Laurenceb/Dactyl/Hardware/Assembly/photo1.JPG

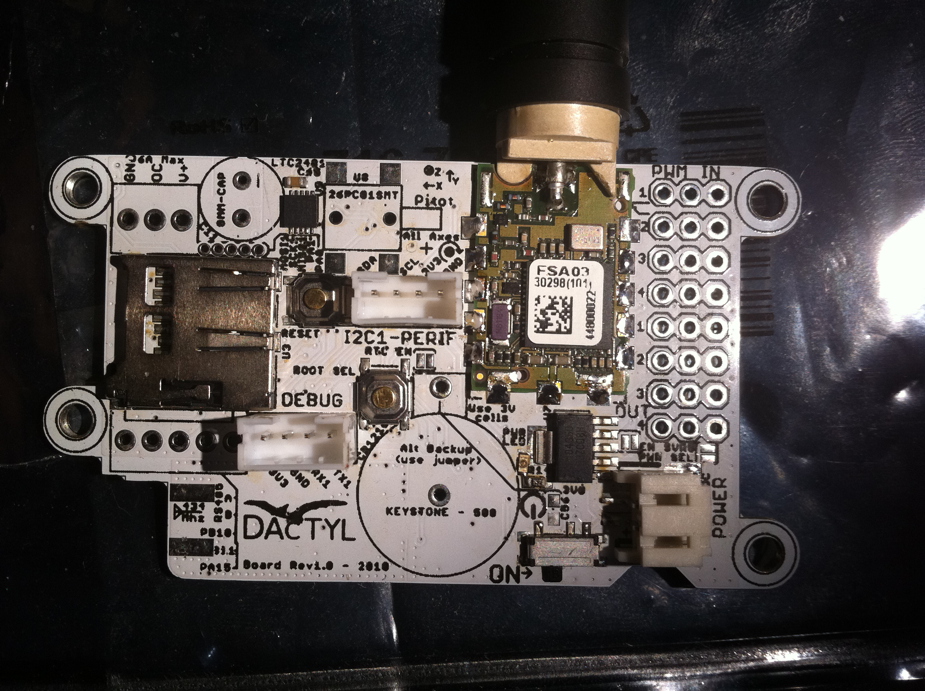
Hardware/Assembly/photo1.JPG
