Laurenceb/Dactyl/Hardware/Assembly/photo2.JPG

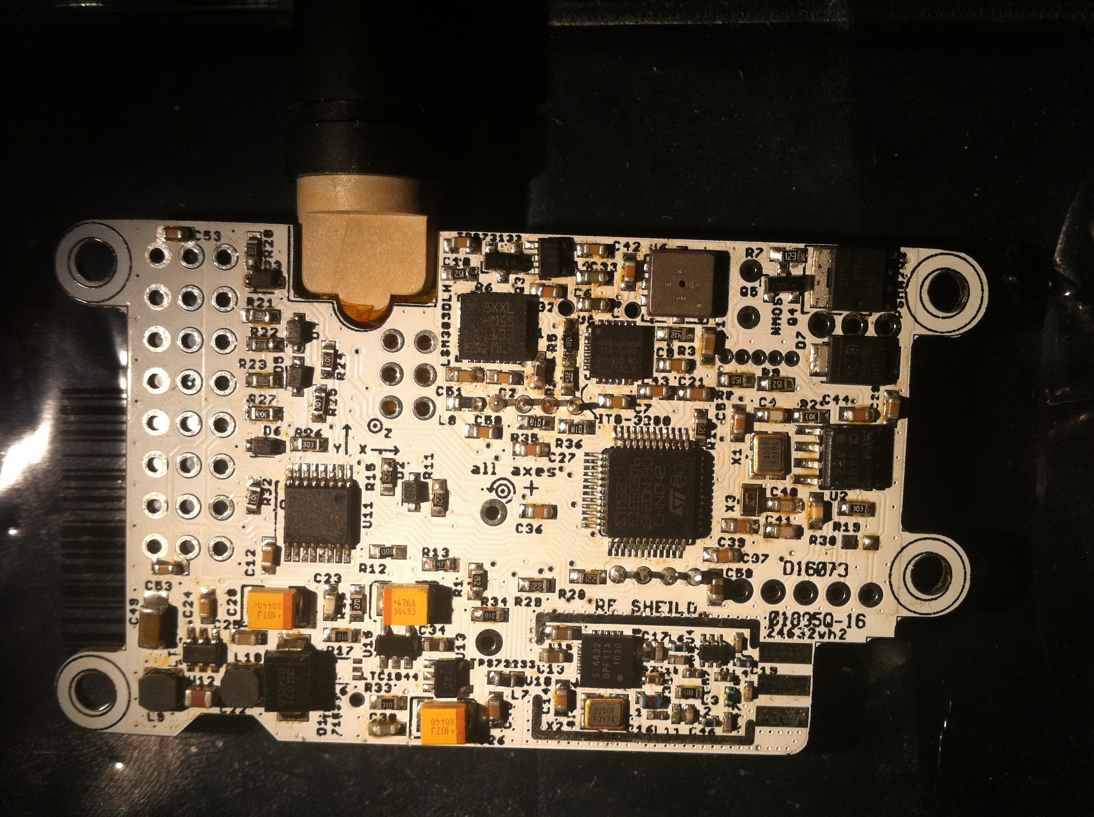
Hardware/Assembly/photo2.JPG
