Laurenceb/Dactyl/README

 The 'Dactyl' autopilot project.

V1.0 of the pcb - has been assembled and mostly tested.

Firmware is presently under development, using ekf code
from openpilot, ubx protocol driver from ukhas mini rogallo
 and Fatfs from http://elm-chan.org
Compiled with codesourcery.

Many thanks to :

- Everyone at OpenPilot
- ChaN for FatFS
- Martin Thomas for SPI and DMA code
- Peter Dannegger for RTC code
- Pascal Stang for rprintf code

Licensed under the GPL

This program is free software; you can redistribute it and/or modify
it under the terms of the GNU General Public License as published by
the Free Software Foundation; version 3 of the License.

This program is distributed in the hope that it will be useful,
but WITHOUT ANY WARRANTY; without even the implied warranty of
MERCHANTABILITY or FITNESS FOR A PARTICULAR PURPOSE.  See the
GNU General Public License for more details.
