Laurenceb/Dactyl/Hardware/11thSept_all.png

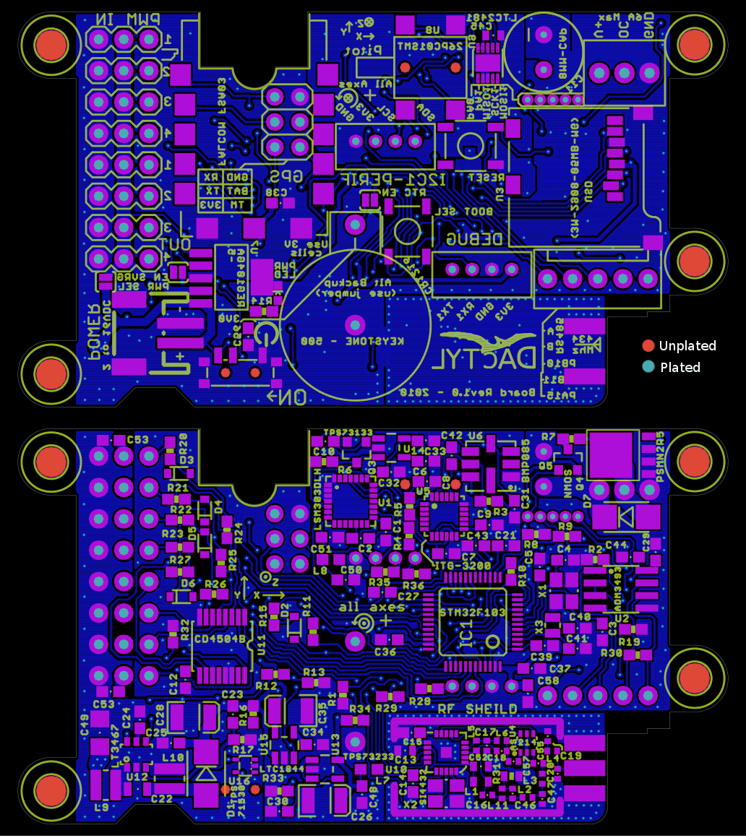
Hardware/11thSept_all.png
