Laurenceb/Dactyl/Hardware/Schematics/Board.png

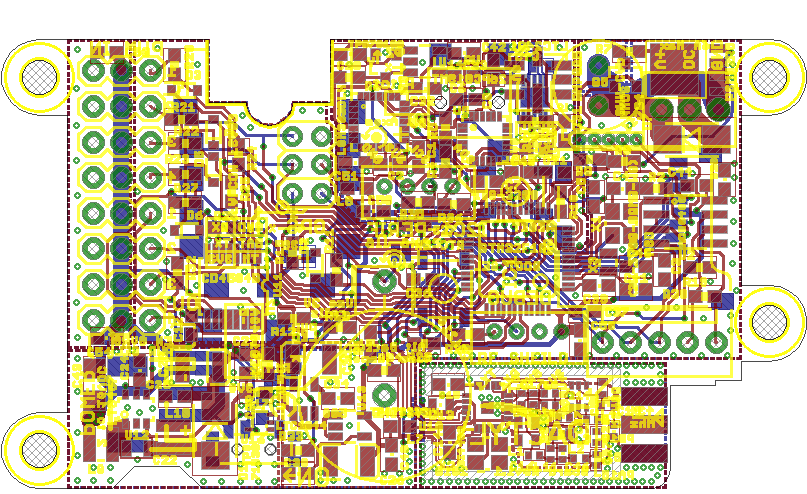
Hardware/Schematics/Board.png
