Laurenceb/Dactyl/Hardware/Schematics/intf.png

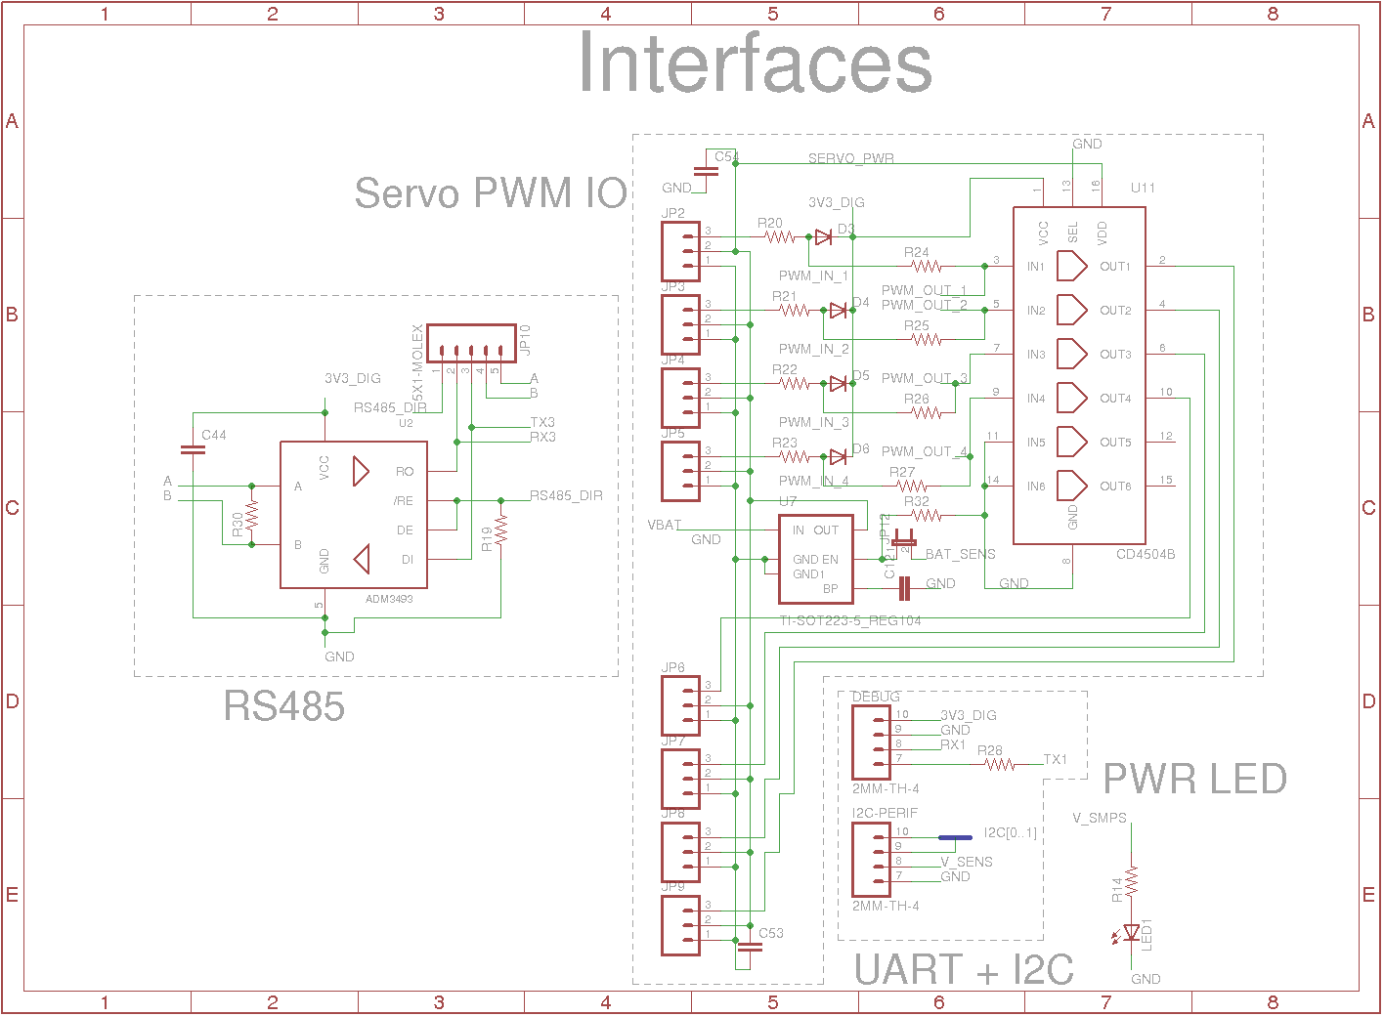
Hardware/Schematics/intf.png
