Laurenceb/Dactyl/Hardware/Schematics/ism.png

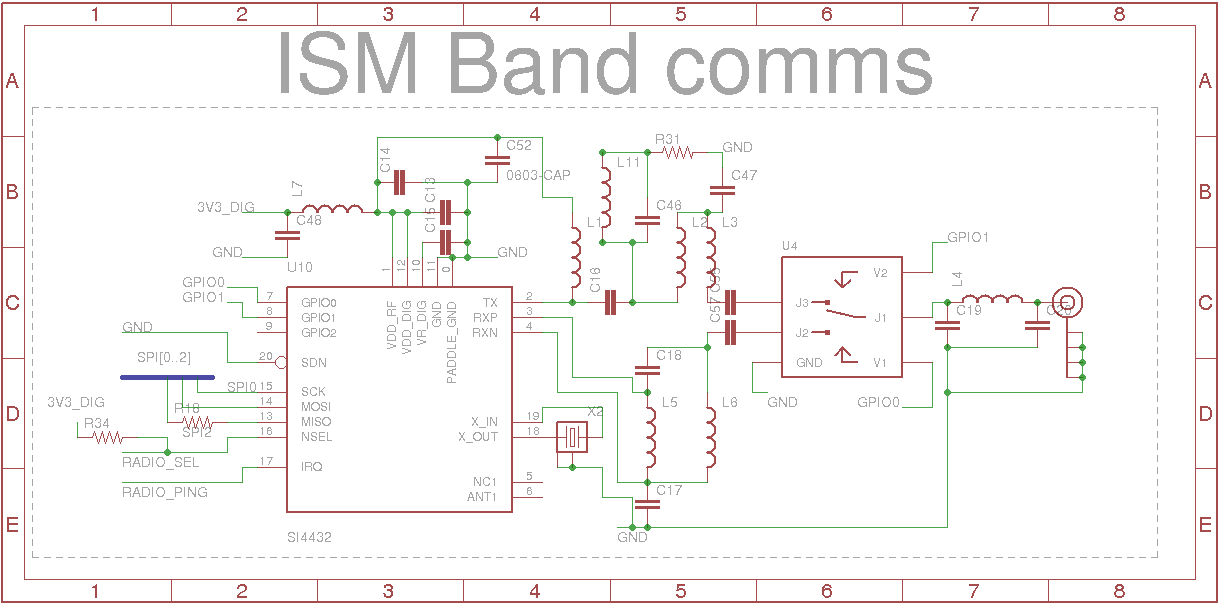
Hardware/Schematics/ism.png
