Laurenceb/Dactyl/Hardware/Schematics/pmg.png

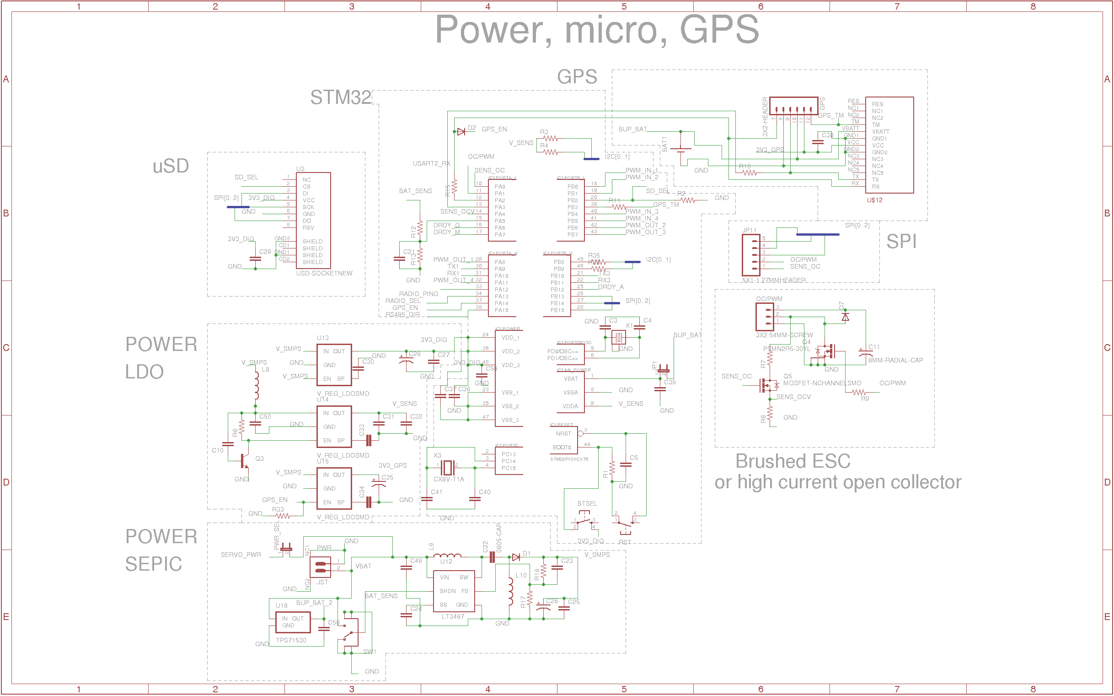
Hardware/Schematics/pmg.png
