Laurenceb/Dactyl/Hardware/Schematics/sens.png

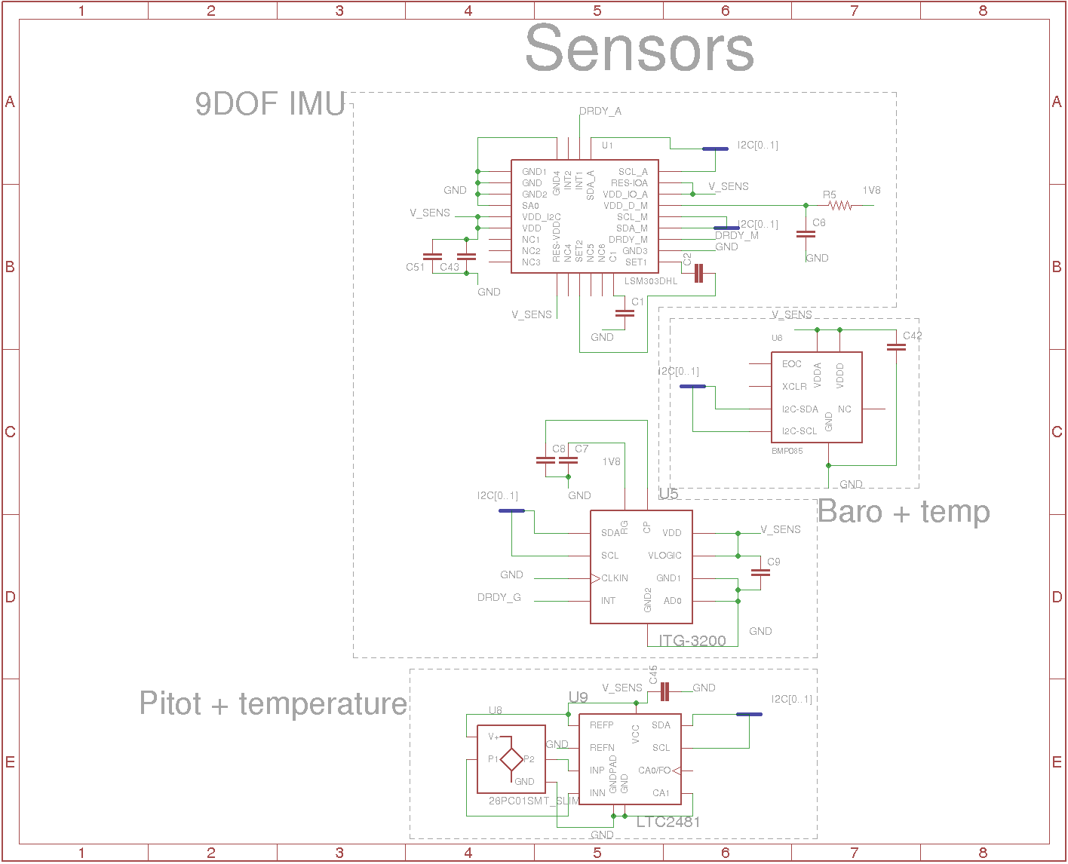
Hardware/Schematics/sens.png
