Laurenceb/Dactyl/Util/RF22/doc/classRF22.png

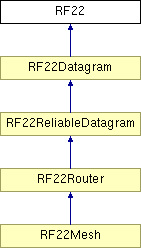
Util/RF22/doc/classRF22.png
