Laurenceb/Dactyl/Hardware/MFG/BOM.xls

 |  |  |  |  | Farnell | GBP | Mouser | GBP | Digikey | $ | Other |  |  | Best price
Part on Board | Quantity | Name | Value | Manufacturer | Code | Price | Code | Price | Code | Price | Name | Price GBP | Price $ | Price | Supplier
U1 | 1 | LSM303DLH | - | ST | - | - | 511-LSM303DLH | 7.34 | 497-10474-ND (http://search.digikey.com/scripts/DkSearch/dksus.dll?Detail&name=497-10474-ND) | 10.5 | Kamami | 12.19 | - | 6.615
U2 | 1 | ADM3493 | - | AD | 1274164 | 2.3 | - | - | ADM3493ARZ-ND (http://search.digikey.com/scripts/DkSearch/dksus.dll?Detail&name=ADM3493ARZ-ND) | 2.27 | - | - | - | 1.4301
U3 | 1 | 2908-05WB-MG | - | 3M | 1654360 | 1.2 | 517-2908-05WB-MG | 0.932 | - | - | - | - | - | 0.932
U4 | 1 | AS214-92LF | - | Skyworks | 1753767 | 0.41 | - | - | - | - | - | - | - | 0.41
U5 | 1 | ITG-3200 | - | Invensence | - | - | - | - | - | - | Invensence | - | 10 | 6.3
U6 | 1 | BMP085 | - | Bosch | - | - | - | - | 828-1005-1-ND (http://search.digikey.com/scripts/DkSearch/dksus.dll?Detail&name=828-1005-1-ND) | 8.79 | - | - | - | 5.5377
U7 | 1 | REG104GA-5 | - | Ti | 1207261 | 4.44 | 595-REG104GA-5/2K5 (http://gb.mouser.com/ProductDetail/Texas-Instruments/REG104GA-5-2K5/) | 3.53 | REG104GA-5-ND | 6.65 | - | - | - | 3.53
U8 | 1 | 26PC01SMT | - | Honeywell | 1225333 | 34.84 | 785-26PC01SMT | 18.67 | 480-2506-5-ND | 28.44 | Conrad | 23.37 | - | 17.9172
U9 | 1 | LTC2481 | - | Linear | 1330939 | 3.96 | - | - | LTC2481CDD#PBF-ND | 3.7 | - | - | - | 2.331
U10 | 1 | SI4432 | - | Silabs | - | - | Si4432-B1-FM | 3.57 | - | - | - | - | - | 3.57
U11 | 1 | CB4504B | - | Ti | - | - | 595-CD4504BPWRG4 | 0.41 | - | - | - | - | - | 0.41
U12 | 1 | LT3467 | - | Linear | 1663827 | 3.72 | - | - | LT3467ES6#TRMPBFCT-ND | 4.14 | - | - | - | 2.6082
U13 | 1 | TPS73233 | - | Ti | - | - | 595-TPS73233DBVT | 1.25 | 296-15812-1-ND | 2.49 | - | - | - | 1.25
U14 | 1 | TPS73133 | - | Ti | 1207341 | 1 | 595-TPS73133DBVR | 0.906 | 296-15805-2-ND | 1.04 | - | - | - | 0.6552
U15 | 1 | LTC1844 | - | Linear | 1663867 | 2.69 | - | - | LTC1844ES5-3.3#TRMPBFCT-ND | 2.88 | - | - | - | 1.8144
U16 | 1 | TPS71530 | - | Ti | 1135382 | 0.41 | 595-TPS71530DCKRG4 | 0.72 | 296-15045-1-ND | 1.29 | - | - | - | 0.41
GPS | 1 | FSA03 | - | Falcom | - | - | - | - | - | - | Esawdust | - | 47.99 | 30.2337
IC1 | 1 | STM32F103CBT | - | ST | 1606327 | 5.54 | 511-STM32F103CBT6 | 6.4 | 497-6288-ND | 9.6 | - | - | - | 5.54
SMA | 1 | SMA card edge | - | - | - | - | 712-CONREVSMA003.031 | 2.17 | CONSMA003.062-ND | 3.29 | - | - | - | 2.0727
Q4 | 1 | PSMN2R5-30YL | - | NXP | 1699704 | 1.43 | 771-PSMN2R5-30YL-T/R | 1.07 | 568-4680-1-ND | 2.14 | - | - | - | 1.07
ESC-Term | 1 | 1725672 | - | Phoenix | 3041414 | 0.86 | 651-1725672 | 1.59 | 277-1275-ND | 2.23 |  | - | - | 0.86
C11 | 1 | UHN1C471MPD | 470uF | Nichicon | - | - | 647-UHN1C471MPD | 0.212 | - | - | - | - | - | 0.212
Bat-holder | 1 | Keystone 500 | - | Keystone | 3029839 | 1.62 | 534-500 | 1.37 | 500K-ND | 1.37 | - | - | - | 0.8631
Pwr-con | 1 | S2B-PH-SM4-TB | - | JST | 9492615 | 0.32 | - | - | 455-1749-1-ND | 0.5 | - | - | - | 0.315
JST-cons | 2 | B4B-PH-K-S | - | JST | 9492437 | 0.158 | - | - | 455-1706-ND | 0.18 | - | - | - | 0.2268
RS485-head | 1 | 22-11-2052 | - | Molex | - | - | 538-22-11-2052 | 1.29 | WM2703-ND | 0.97 | - | - | - | 0.6111
Servo headers | 8 | 0.1'' headers | - | - | 3418297 | 0.137 | 517-9611036804AR | 0.099 | WM8085-ND | 0.49 | - | - | - | 0.792
SPI-bkout | 1 | 0.05” 5 way | - | - | 1577762 | 0.23 | - | - | S9016E-05-ND | 0.4 | - | - | - | 0.23
Tact-switches | 2 | PTS 525 – S | - | C&K | - | - | 611-PTS525SM08SMTRLF | 0.395 | CKN9125CT-ND | 0.48 | - | - | - | 0.6048
On/off switch | 1 | PCM12SMTR | - | C&K | 9575146 | 0.82 | 611-PCM12SMTR | 0.778 | 401-2016-1-ND | 0.9 | - | - | - | 0.567
PWR LED | 1 | - | - | - | 8529850 | 0.175 | 604-APTD1608SYCK | 0.141 | 754-1353-1-ND | 0.18 | - | - | - | 0.1134
C45,54,53,44,43,42,9,7,48,14,29,21,38,39,50,27,37,36,32,5,10,12 | 22 | Ceramic 0603 caps | 100nF | - | 1759037 | 0.006 | - | - | - | - | - | - | - | 0.132
R14,6,1,8,9 | 5 | 0603 Resistor | 1K5 | - | 9331808 | 0.008 | - | - | - | - | - | - | - | 0.04
C22 | 1 | 0805 30V ceramic | 4u7 | - | 1735529 | 0.21 | 810-C2012X5R1E475K | 0.176 | 490-3335-1-ND | 0.281 | - | - | - | 0.176
C49 | 1 | 1206 Cap – 25V | 10uF | - | 1611967 | 0.087 | - | - | 587-1352-1-ND | 0.45 | - | - | - | 0.087
X2 | 1 | FA238 | 30MHz | Epson Toyocom | 1712817 | 1.17 | - | - | - | - | - | - | - | 1.17
C26,28 | 2 | Tant, 3528 | 100uF | - | 1650975 | 0.92 | - | - | - | - | - | - | - | 1.84
C35 | 1 | Tant, 3528 | 47uF | - | 1462450 | 1.08 | - | - | - | - | - | - | - | 1.08
L7,8 | 2 | Choke, RF | - | - | 1463450 | 0.038 | - | - | - | - | - | - | - | 0.076
L9,10 | 2 | Power inductor | 10uH | TDK | - | - | 810-VLS3015T-100MR70 | 0.501 | 445-3699-1-ND | 0.71 | - | - | - | 0.8946
D7 | 1 | 4A SMB Schottky | - | Vishay | 1336556RL | 0.62 | 625-SSB43L | 0.268 | SSB43L-E3/52TGICT-ND | 0.71 | - | - | - | 0.268
D1 | 1 | STPS2L40 | - | ST | 1373662 | 0.34 | 511-STPS2L40UF | 0.316 | 497-5574-1-ND | 0.67 | - | - | - | 0.316
D2,3,4,5,6 | 5 | SOD-323 | - | - | 1621831 | 0.058 | 78-1N4448W-V | 0.063 | SDMK0340L-FDICT-ND | 0.42 | - | - | - | 0.29
C25,31,51 | 3 | 0603 MLCC 6.3v | 10uF | - | 1833804 | 0.174 | 810-C1608Y5V0J106Z | 0.261 | 445-3448-1-ND | 0.44 | - | - | - | 0.522
Q3 | 1 | PDTC143 | - | NXP | 8737274 | 0.057 | - | - | - | - | - | - | - | 0.057
R18,28,10,15,11 | 5 | 0603 Resistor | 220ohm | - | 9330801 | 0.023 | - | - | - | - | - | - | - | 0.115
C8 | 1 | 0603 50V cap | 2n2F | - | 1520289 | 0.013 | - | - | - | - | - | - | - | 0.013
C58,6,1 | 3 | 0603 6.3v cap | 4u7 | - | 1833803 | 0.053 | - | - | - | - | - | - | - | 0.159
C30,33 | 2 | 0603 Ceramic | 10nF | - | 1759102 | 0.005 | - | - | - | - | - | - | - | 0.01
C34,56,15,13 | 4 | 0603 Ceramic | 1uF | - | 1740640 | 0.05 | - | - | - | - | - | - | - | 0.2
R33,2,19,34 | 4 | 0603 Resistor | 10K | - | 9330399 | 0.023 | - | - | - | - | - | - | - | 0.092
Q5 | 1 | N-MOSFET SOT23 | - | - | 9845011 | 0.135 | - | - | - | - | - | - | - | 0.135
R7 | 1 | 0603 Resistor | 12K | - | 9233512 | 0.011 | - | - | - | - | - | - | - | 0.011
R3,4 | 2 | 0603 Resistor | 4K7 | - | 1738913 | 0.03 | - | - | - | - | - | - | - | 0.06
R35,36 | 2 | 0603 Resistor | 100Ohm | - | 9330364 | 0.006 | - | - | - | - | - | - | - | 0.012
R20,21,22,23 | 4 | 0603 Resistor | 3K | - | 1653266 | 0.06 | - | - | - | - | - | - | - | 0.24
R24,25,26,27,32 | 5 | 0603 Resistor | 30K | - | 1653267 | 0.06 | - | - | - | - | - | - | - | 0.3
R30 | 1 | 0603 Resistor | 120Ohm | - | 1652832 | 0.059 | - | - | - | - | - | - | - | 0.059
R5,31 | 2 | 0603 Resistor | 50 Ohm | - | 1652900 | 0.059 | - | - | - | - | - | - | - | 0.118
C2 | 1 | 0603 Ceramic | 220nF | - | 431199 | 0.044 | - | - | - | - | - | - | - | 0.044
C57,55,52 | 3 | 0402 Ceramic | 220pF | - | 1611930 | 0.009 | - | - | - | - | - | - | - | 0.027
X1 | 1 | FA238 | 24MHz | Epson Toyocom | 1712815 | 0.83 | - | - | - | - | - | - | - | 0.83
C3,4 | 2 | 0603 Ceramic | 12pF | - | 1414612RL | 0.023 | - | - | - | - | - | - | - | 0.046
X3 | 1 | CX8V-T1A | - | Micro Crystal | - | - | - | - | - | - | (RS)672-7635P | 0.91 | - | 0.91
C40,41 | 2 | 0603 Ceramic | 9pF | - | 1759052RL | 0.006 | - | - | - | - | - | - | - | 0.012
C18 | 1 | 0402 Ceramic | 3.3pF | - | 1800797 | 0.022 | - | - | - | - | - | - | - | 0.022
C17 | 1 | 0402 Ceramic | 6.8pF | - | 1800799 | 0.018 | - | - | - | - | - | - | - | 0.018
L5 | 1 | 0402 Inductor | 33nH | Murata | 1762626 | 0.177 | - | - | - | - | - | - | - | 0.177
L6 | 1 | 0402 Inductor
 |  |  |  |  |  |  |  |  |  |  |  |  | Total | 110.591
 |  |  |  |  |  |  |  |  |  |  |  |  | +VAT | 129.944425
