Laurenceb/Dactyl/Hardware/Datasheets/Radio/4431-T-B1_D_434_BOM.xls

Sheet: 4431-T-B1_D_434_BOM_parts
4431-T-B1 D 434
Part | Value | Device | Package | Description | Side | X (mm) | Y (mm) | Angle
C0 | 3.9pF | Capacitor | 0402 | Murata GRM15 series | Top | 30.56 | 26.85 | 180
C1 | 33pF | Capacitor | 0402 | Murata GRM15 series | Top | 34.52 | 25.53 | 180
C12 | 100pF | Capacitor | 0603 | Capacitor | Top | 24.26 | 21.49 | 0
C13 | 1uF | Capacitor | 0603 | Capacitor | Top | 24.26 | 20.12 | 0
C14 | 100pF | Capacitor | 0603 | Capacitor | Top | 50.19 | 15.88 | 270
C16 | 100nF | Capacitor | 0603 | Capacitor | Top | 27.03 | 18.75 | 0
C2 | 100pF | Capacitor | 0402 | Murata GRM15 series | Top | 35.38 | 26.52 | 180
C23 | 100nF | Capacitor | 0603 | Capacitor | Top | 7.01 | 13.97 | 0
C3 | 100nF | Capacitor | 0402 | Murata GRM15 series | Top | 36.3 | 27.51 | 180
C4 | 2.2uF | Capacitor | 0603 | Capacitor | Top | 36.93 | 29.06 | 180
C5 | N.F. | Capacitor | 0603 | Capacitor | Top | 15.9 | 22.86 | 90
CC1 | 270pF | Capacitor | 0402 | Murata GRM15 series | Top | 30.56 | 34.65 | 0
CM | 3.6pF | Capacitor | 0402 | Murata GRM15 series | Top | 30.56 | 28.83 | 180
CM2 | 6.2pF | Capacitor | 0402 | Murata GRM15 series | Top | 31.47 | 30.81 | 180
CM3 | N.F. | Capacitor | 0402 | Murata GRM15 series | Top | 31.47 | 33.66 | 180
CR1 | 8.2pF | Capacitor | 0402 | Murata GRM15 series | Top | 26.85 | 26.09 | 0
CR2 | 3pF | Capacitor | 0402 | Murata GRM15 series | Top | 29.13 | 27.51 | 270
CS1 | CON40-0 | CON40-0 | Molex 0702474051 | 40-PIN male connector, 90 deg | Top | 29.34 | 2.54 | 270
L0 | 51nH | Inductor | 0402 | Coilcraft 0402HP series | Top | 30.56 | 27.84 | 0
LC | 100nH | Inductor | 0402 | Coilcraft 0402HP series | Top | 30.56 | 25.86 | 0
LM | 36nH | Inductor | 0402 | Coilcraft 0402HP series | Top | 30.56 | 29.82 | 180
LM2 | 16nH | Inductor | 0403 | Coilcraft 0402HP series | Top | 31.01 | 32.23 | 270
LR | 33nH | Inductor | 0402 | Coilcraft 0402HP series | Top | 28.7 | 26.09 | 180
LR2 | 33nH | Inductor | 0402 | Coilcraft 0402HP series | Top | 28.14 | 27.51 | 270
Q1 | 30MHz | Crystal | SMD2520 | TST TZ1430A | Top | 35.46 | 22.99 | 180
Q2 | 32.7 kHz | Crystal | SMQ32SL | SMQ32SL | Top | 10.16 | 23.5 | 180
R1 | 100k | Resistor | 0603 | Resistor | Top | 44.45 | 15.88 | 90
R10 | 100k | Resistor | 0603 | Resistor | Top | 46.38 | 15.88 | 270
R13 | 100k | Resistor | 0603 | Resistor | Top | 48.29 | 15.88 | 270
R2 | 10k | Resistor | 0603 | Resistor | Top | 19.05 | 21.59 | 90
R4 | 100k | Resistor | 0603 | Resistor | Top | 10.82 | 13.97 | 0
R5 | N.F. | Resistor | 0603 | Resistor | Top | 14 | 13.97 | 180
R9 | 10k | Resistor | 0603 | Resistor | Top | 52.1 | 15.88 | 270
RDC | 43R | Resistor | 0402 | Resistor | Top | 32.41 | 25.86 | 0
TRX | Horizontal | SMA connector | BU-SMA-H | 90degree bent, female SMA connector | Top | 29.46 | 42.42 | 0
U1 | Si4431 | Si4431 RevB1 | QFN-20 | Radio IC, Silicon Labs | Top | 29.49 | 22.48 | 270
U2 | 25AA080C | 25AA080C | TSSOP8 | Serial EEPROM; Microchip | Top | 11.46 | 16.51 | 180

Sheet: 4431-T-B1_D_434_values
4431-T-B1 D 434
Qty | Value | Device | Package | Part | Description
1 |  | 25AA080C | TSSOP8 | U2 | Serial EEPROM, Microchip
1 | 3.9pF | Capacitor | 0402 | C0 | Murata GRM15 series
1 | 33pF | Capacitor | 0402 | C1 | Murata GRM15 series
1 | 100pF | Capacitor | 0402 | C2 | Murata GRM15 series
1 | 100nF | Capacitor | 0402 | C3 | Murata GRM15 series
1 | 270pF | Capacitor | 0402 | CC1 | Murata GRM15 series
1 | 3.6pF | Capacitor | 0402 | CM | Murata GRM15 series
1 | 6.2pF | Capacitor | 0402 | CM2 | Murata GRM15 series
1 | N.F. | Capacitor | 0402 | CM3 | Murata GRM15 series
1 | 8.2pF | Capacitor | 0402 | CR1 | Murata GRM15 series
1 | 3pF | Capacitor | 0402 | CR2 | Murata GRM15 series
1 | 2.2uF | Capacitor | 0603 | C4 | Capacitor
1 | N.F. | Capacitor | 0603 | C5 | Capacitor
2 | 100pF | Capacitor | 0603 | C12, C14 | Capacitor
1 | 1uF | Capacitor | 0603 | C13 | Capacitor
2 | 100nF | Capacitor | 0603 | C16, C23 | Capacitor
1 |  | CON40-0 | Molex 0702474051 | CS1 | 40-PIN male connector, 90 deg
1 | 32.768k | Crystal | SMD2520 | Q2 | SMQ32SL
1 | 30MHz | Crystal | SMQ32SL | Q1 | TST TZ1430A
1 | 100nH | Inductor | 0402 | LC | Coilcraft 0402HP series
1 | 51nH | Inductor | 0402 | L0 | Coilcraft 0402HP series
1 | 36nH | Inductor | 0402 | LM | Coilcraft 0402HP series
1 | 16nH | Inductor | 0402 | LM2 | Coilcraft 0402HP series
2 | 33nH | Inductor | 0402 | LR, LR2 | Coilcraft 0402HP series
1 | 43R | Resistor | 0402 | RDC | Resistor
4 | 100k | Resistor | 0603 | R1, R4, R10, R13 | Resistor
2 | 10k | Resistor | 0603 | R9, R2 | Resistor
1 | N.F. | Resistor | 0603 | R5 | Resistor
1 |  | Si4431 RevB1 | QFN-20 | U1 | Radio IC, Silicon Labs
1 |  | SMA connector | BU-SMA-H | TRX | 90degree bent, female SMA connector

Sheet: Manufacturing details
4431-T-B1 D 434
Material: | FR4
Total thickness: | 1.57 mm | +/-0.15mm
Number of layers | 2
Color of board: | Blue
Color of text on board: | White | Top side only
Finish: | HAL
Technology: | Pb free, RHoS
The given drill size is finished size!
Layer structure
 | Top Cu | 0.035 mm
 | FR4 | 1.5 mm | +/-0.15mm
 | Bottom Cu | 0.035 mm
Connector orientation (illustration)
