Laurenceb/Dactyl/test5hz.png

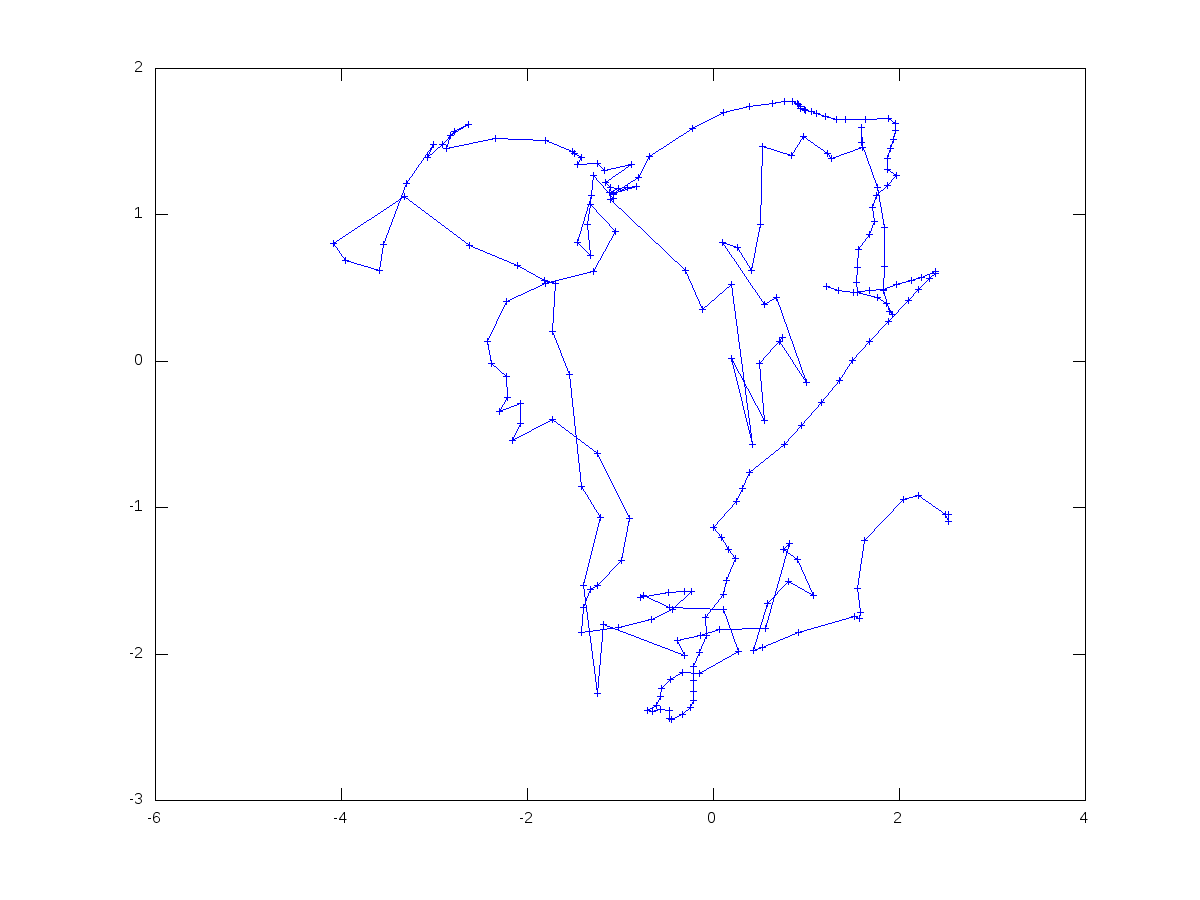
test5hz.png
