Laurenceb/Dactyl/Hardware/spice/lt3467/LT3467.asc

C1: cap; 10µ; V=25 Irms=0 Rser=0.001 Lser=0 mfg="TDK" pn="C575OX7RIE106M" type="X7R"
C2: cap; 10µ
C3: cap; 12p
C4: cap; .001µ
C5: cap; 4.7µ; V=10 Irms=0 Rser=0.003 Lser=0 mfg="TDK" pn="C3216X5RlA475M" type="X5R"
D1: SCHOTTKY; MBRS130L
Iload: LOAD2; 500m; load
L1: ind; 10µ; Ipk=0.8 Rser=0.33 Rpar=942 Cpar=0 mfg="Coilcraft" pn="ME3220-103KX"
L2: ind; 10µ
R1: RES; 25K
R2: RES; 13.3K
U1: LT3467
V1: VOLTAGE; 15.5V
Named nets: OUT, 0, IN
Note:
  If the simulation model is not found please update with the "Sync Release" command from the "Tools" menu.
  It remains the customer's responsibility to verify proper and reliable operation in the actual application.
  Component substitution and printed circuit board layout may significantly affect circuit performance or reliability.
  Contact your local sales representative for assistance. This circuit is distributed to customers only for use with LTC parts.
  Copyright © 2006 Linear Technology Inc. All rights reserved.
.tran .5m startup
LT3467 - 1.1A, 1.3MHz, Step-up DC/DC Converter in ThinSOT
Input: 5V    Output: 12V @ 260mA
