Laurenceb/Dactyl/Control/loggedo2ekf.asm

ekf.o:     file format elf32-littlearm


Disassembly of section .text:

00000000 <ins_get_num_states>:
       0:	200d      	movs	r0, #13
       2:	4770      	bx	lr

00000004 <INSGPSInit>:
       4:	4bc7      	ldr	r3, [pc, #796]	; (324 <INSGPSInit+0x320>)
       6:	e92d 07f0 	stmdb	sp!, {r4, r5, r6, r7, r8, r9, sl}
       a:	48c7      	ldr	r0, [pc, #796]	; (328 <INSGPSInit+0x324>)
       c:	4cc7      	ldr	r4, [pc, #796]	; (32c <INSGPSInit+0x328>)
       e:	f8df 9338 	ldr.w	r9, [pc, #824]	; 348 <INSGPSInit+0x344>
      12:	2200      	movs	r2, #0
      14:	f04f 5a7e 	mov.w	sl, #1065353216	; 0x3f800000
      18:	49c5      	ldr	r1, [pc, #788]	; (330 <INSGPSInit+0x32c>)
      1a:	f8df 8330 	ldr.w	r8, [pc, #816]	; 34c <INSGPSInit+0x348>
      1e:	f8df c330 	ldr.w	ip, [pc, #816]	; 350 <INSGPSInit+0x34c>
      22:	4fc4      	ldr	r7, [pc, #784]	; (334 <INSGPSInit+0x330>)
      24:	4ec4      	ldr	r6, [pc, #784]	; (338 <INSGPSInit+0x334>)
      26:	4dc5      	ldr	r5, [pc, #788]	; (33c <INSGPSInit+0x338>)
      28:	605a      	str	r2, [r3, #4]
      2a:	609a      	str	r2, [r3, #8]
      2c:	611a      	str	r2, [r3, #16]
      2e:	615a      	str	r2, [r3, #20]
      30:	619a      	str	r2, [r3, #24]
      32:	61da      	str	r2, [r3, #28]
      34:	621a      	str	r2, [r3, #32]
      36:	625a      	str	r2, [r3, #36]	; 0x24
      38:	629a      	str	r2, [r3, #40]	; 0x28
      3a:	62da      	str	r2, [r3, #44]	; 0x2c
      3c:	631a      	str	r2, [r3, #48]	; 0x30
      3e:	635a      	str	r2, [r3, #52]	; 0x34
      40:	639a      	str	r2, [r3, #56]	; 0x38
      42:	63da      	str	r2, [r3, #60]	; 0x3c
      44:	641a      	str	r2, [r3, #64]	; 0x40
      46:	649a      	str	r2, [r3, #72]	; 0x48
      48:	64da      	str	r2, [r3, #76]	; 0x4c
      4a:	651a      	str	r2, [r3, #80]	; 0x50
      4c:	655a      	str	r2, [r3, #84]	; 0x54
      4e:	659a      	str	r2, [r3, #88]	; 0x58
      50:	65da      	str	r2, [r3, #92]	; 0x5c
      52:	661a      	str	r2, [r3, #96]	; 0x60
      54:	665a      	str	r2, [r3, #100]	; 0x64
      56:	669a      	str	r2, [r3, #104]	; 0x68
      58:	66da      	str	r2, [r3, #108]	; 0x6c
      5a:	671a      	str	r2, [r3, #112]	; 0x70
      5c:	675a      	str	r2, [r3, #116]	; 0x74
      5e:	679a      	str	r2, [r3, #120]	; 0x78
      60:	f8c3 2080 	str.w	r2, [r3, #128]	; 0x80
      64:	f8c3 2084 	str.w	r2, [r3, #132]	; 0x84
      68:	f8c3 2088 	str.w	r2, [r3, #136]	; 0x88
      6c:	f8c3 a000 	str.w	sl, [r3]
      70:	f8c3 208c 	str.w	r2, [r3, #140]	; 0x8c
      74:	f8c3 2090 	str.w	r2, [r3, #144]	; 0x90
      78:	f8c3 2094 	str.w	r2, [r3, #148]	; 0x94
      7c:	f8c3 2098 	str.w	r2, [r3, #152]	; 0x98
      80:	f8c3 209c 	str.w	r2, [r3, #156]	; 0x9c
      84:	f8c3 20a0 	str.w	r2, [r3, #160]	; 0xa0
      88:	f8c3 20a4 	str.w	r2, [r3, #164]	; 0xa4
      8c:	f8c3 20a8 	str.w	r2, [r3, #168]	; 0xa8
      90:	f8c3 20ac 	str.w	r2, [r3, #172]	; 0xac
      94:	f8c3 20b0 	str.w	r2, [r3, #176]	; 0xb0
      98:	f8c3 20b8 	str.w	r2, [r3, #184]	; 0xb8
      9c:	f8c3 20bc 	str.w	r2, [r3, #188]	; 0xbc
      a0:	f8c3 20c0 	str.w	r2, [r3, #192]	; 0xc0
      a4:	f8c3 20c4 	str.w	r2, [r3, #196]	; 0xc4
      a8:	f8c3 20c8 	str.w	r2, [r3, #200]	; 0xc8
      ac:	f8c3 20cc 	str.w	r2, [r3, #204]	; 0xcc
      b0:	f8c3 20d0 	str.w	r2, [r3, #208]	; 0xd0
      b4:	f8c3 20d4 	str.w	r2, [r3, #212]	; 0xd4
      b8:	f8c3 20d8 	str.w	r2, [r3, #216]	; 0xd8
      bc:	f8c3 20dc 	str.w	r2, [r3, #220]	; 0xdc
      c0:	f8c3 20e0 	str.w	r2, [r3, #224]	; 0xe0
      c4:	f8c3 20e4 	str.w	r2, [r3, #228]	; 0xe4
      c8:	f8c3 20e8 	str.w	r2, [r3, #232]	; 0xe8
      cc:	f8c3 20f0 	str.w	r2, [r3, #240]	; 0xf0
      d0:	f8c3 20f4 	str.w	r2, [r3, #244]	; 0xf4
      d4:	f8c3 20f8 	str.w	r2, [r3, #248]	; 0xf8
      d8:	f8c3 20fc 	str.w	r2, [r3, #252]	; 0xfc
      dc:	f8c3 2100 	str.w	r2, [r3, #256]	; 0x100
      e0:	f8c3 2104 	str.w	r2, [r3, #260]	; 0x104
      e4:	f8c3 2108 	str.w	r2, [r3, #264]	; 0x108
      e8:	f8c3 210c 	str.w	r2, [r3, #268]	; 0x10c
      ec:	f8c3 2110 	str.w	r2, [r3, #272]	; 0x110
      f0:	f8c3 2114 	str.w	r2, [r3, #276]	; 0x114
      f4:	f8c3 2118 	str.w	r2, [r3, #280]	; 0x118
      f8:	f8c3 211c 	str.w	r2, [r3, #284]	; 0x11c
      fc:	f8c3 2120 	str.w	r2, [r3, #288]	; 0x120
     100:	f8c3 2128 	str.w	r2, [r3, #296]	; 0x128
     104:	f8c3 212c 	str.w	r2, [r3, #300]	; 0x12c
     108:	f8c3 2130 	str.w	r2, [r3, #304]	; 0x130
     10c:	f8c3 2134 	str.w	r2, [r3, #308]	; 0x134
     110:	f8c3 2138 	str.w	r2, [r3, #312]	; 0x138
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
     a52:	d1e5      	bne.n	a20 <INSPosVelReset+0x80>
     a54:	3701      	adds	r7, #1
     a56:	3334      	adds	r3, #52	; 0x34
     a58:	2f06      	cmp	r7, #6
     a5a:	d1a7      	bne.n	9ac <INSPosVelReset+0xc>
     a5c:	4b11      	ldr	r3, [pc, #68]	; (aa4 <INSPosVelReset+0x104>)
     a5e:	4a12      	ldr	r2, [pc, #72]	; (aa8 <INSPosVelReset+0x108>)
     a60:	4c12      	ldr	r4, [pc, #72]	; (aac <INSPosVelReset+0x10c>)
     a62:	f8c3 2124 	str.w	r2, [r3, #292]	; 0x124
     a66:	67dc      	str	r4, [r3, #124]	; 0x7c
     a68:	645c      	str	r4, [r3, #68]	; 0x44
     a6a:	60dc      	str	r4, [r3, #12]
     a6c:	f8c3 20ec 	str.w	r2, [r3, #236]	; 0xec
     a70:	f8c3 20b4 	str.w	r2, [r3, #180]	; 0xb4
     a74:	6802      	ldr	r2, [r0, #0]
     a76:	f8c3 22b0 	str.w	r2, [r3, #688]	; 0x2b0
     a7a:	f8d0 c004 	ldr.w	ip, [r0, #4]
     a7e:	f8c3 c2b4 	str.w	ip, [r3, #692]	; 0x2b4
     a82:	6882      	ldr	r2, [r0, #8]
     a84:	f8c3 22b8 	str.w	r2, [r3, #696]	; 0x2b8
     a88:	f8d1 c000 	ldr.w	ip, [r1]
     a8c:	f8c3 c2bc 	str.w	ip, [r3, #700]	; 0x2bc
     a90:	6848      	ldr	r0, [r1, #4]
     a92:	f8c3 02c0 	str.w	r0, [r3, #704]	; 0x2c0
     a96:	688a      	ldr	r2, [r1, #8]
     a98:	f8c3 22c4 	str.w	r2, [r3, #708]	; 0x2c4
     a9c:	bcf0      	pop	{r4, r5, r6, r7}
     a9e:	4770      	bx	lr
     aa0:	0000003c 	andeq	r0, r0, ip, lsr r0
     aa4:	00000000 	andeq	r0, r0, r0
     aa8:	40a00000 	adcmi	r0, r0, r0
     aac:	41c80000 	bicmi	r0, r8, r0

00000ab0 <INSSetPosVelVar>:
     ab0:	4b06      	ldr	r3, [pc, #24]	; (acc <INSSetPosVelVar+0x1c>)
     ab2:	f8c3 0308 	str.w	r0, [r3, #776]	; 0x308
     ab6:	f8c3 030c 	str.w	r0, [r3, #780]	; 0x30c
     aba:	f8c3 0310 	str.w	r0, [r3, #784]	; 0x310
     abe:	f8c3 1314 	str.w	r1, [r3, #788]	; 0x314
     ac2:	f8c3 1318 	str.w	r1, [r3, #792]	; 0x318
     ac6:	f8c3 031c 	str.w	r0, [r3, #796]	; 0x31c
     aca:	4770      	bx	lr
     acc:	00000000 	andeq	r0, r0, r0

00000ad0 <INSSetGyroBias>:
     ad0:	4b05      	ldr	r3, [pc, #20]	; (ae8 <INSSetGyroBias+0x18>)
     ad2:	f8d0 c000 	ldr.w	ip, [r0]
     ad6:	f8c3 c2d8 	str.w	ip, [r3, #728]	; 0x2d8
     ada:	6841      	ldr	r1, [r0, #4]
     adc:	f8c3 12dc 	str.w	r1, [r3, #732]	; 0x2dc
     ae0:	6882      	ldr	r2, [r0, #8]
     ae2:	f8c3 22e0 	str.w	r2, [r3, #736]	; 0x2e0
     ae6:	4770      	bx	lr
     ae8:	00000000 	andeq	r0, r0, r0

00000aec <INSSetAccelVar>:
     aec:	4b05      	ldr	r3, [pc, #20]	; (b04 <INSSetAccelVar+0x18>)
     aee:	f8d0 c000 	ldr.w	ip, [r0]
     af2:	f8c3 c2f0 	str.w	ip, [r3, #752]	; 0x2f0
     af6:	6841      	ldr	r1, [r0, #4]
     af8:	f8c3 12f4 	str.w	r1, [r3, #756]	; 0x2f4
     afc:	6882      	ldr	r2, [r0, #8]
     afe:	f8c3 22f8 	str.w	r2, [r3, #760]	; 0x2f8
     b02:	4770      	bx	lr
     b04:	00000000 	andeq	r0, r0, r0

00000b08 <INSSetGyroVar>:
     b08:	4b05      	ldr	r3, [pc, #20]	; (b20 <INSSetGyroVar+0x18>)
     b0a:	f8d0 c000 	ldr.w	ip, [r0]
     b0e:	f8c3 c2e4 	str.w	ip, [r3, #740]	; 0x2e4
     b12:	6841      	ldr	r1, [r0, #4]
     b14:	f8c3 12e8 	str.w	r1, [r3, #744]	; 0x2e8
     b18:	6882      	ldr	r2, [r0, #8]
     b1a:	f8c3 22ec 	str.w	r2, [r3, #748]	; 0x2ec
     b1e:	4770      	bx	lr
     b20:	00000000 	andeq	r0, r0, r0

00000b24 <INSSetMagVar>:
     b24:	4b05      	ldr	r3, [pc, #20]	; (b3c <INSSetMagVar+0x18>)
     b26:	f8d0 c000 	ldr.w	ip, [r0]
     b2a:	f8c3 c320 	str.w	ip, [r3, #800]	; 0x320
     b2e:	6841      	ldr	r1, [r0, #4]
     b30:	f8c3 1324 	str.w	r1, [r3, #804]	; 0x324
     b34:	6882      	ldr	r2, [r0, #8]
     b36:	f8c3 2328 	str.w	r2, [r3, #808]	; 0x328
     b3a:	4770      	bx	lr
     b3c:	00000000 	andeq	r0, r0, r0

00000b40 <INSSetMagNorth>:
     b40:	4b04      	ldr	r3, [pc, #16]	; (b54 <INSSetMagNorth+0x14>)
     b42:	f8d0 c000 	ldr.w	ip, [r0]
     b46:	f8c3 c000 	str.w	ip, [r3]
     b4a:	6841      	ldr	r1, [r0, #4]
     b4c:	6059      	str	r1, [r3, #4]
     b4e:	6882      	ldr	r2, [r0, #8]
     b50:	609a      	str	r2, [r3, #8]
     b52:	4770      	bx	lr
     b54:	00000000 	andeq	r0, r0, r0

00000b58 <INSSetGravity>:
     b58:	4b01      	ldr	r3, [pc, #4]	; (b60 <INSSetGravity+0x8>)
     b5a:	6018      	str	r0, [r3, #0]
     b5c:	4770      	bx	lr
     b5e:	bf00      	nop
     b60:	00000000 	andeq	r0, r0, r0

00000b64 <CovariancePrediction>:
     b64:	e92d 4ff0 	stmdb	sp!, {r4, r5, r6, r7, r8, r9, sl, fp, lr}
     b68:	f5ad 6d9c 	sub.w	sp, sp, #1248	; 0x4e0
     b6c:	b081      	sub	sp, #4
     b6e:	9161      	str	r1, [sp, #388]	; 0x184
     b70:	4605      	mov	r5, r0
     b72:	4619      	mov	r1, r3
     b74:	4618      	mov	r0, r3
     b76:	923c      	str	r2, [sp, #240]	; 0xf0
     b78:	461c      	mov	r4, r3
     b7a:	f7ff fffe 	bl	0 <__aeabi_fmul>
     b7e:	f8dd 9508 	ldr.w	r9, [sp, #1288]	; 0x508
     b82:	9039      	str	r0, [sp, #228]	; 0xe4
     b84:	f50d 7a0f 	add.w	sl, sp, #572	; 0x23c
     b88:	464a      	mov	r2, r9
     b8a:	2000      	movs	r0, #0
     b8c:	b2c3      	uxtb	r3, r0
     b8e:	eb00 0140 	add.w	r1, r0, r0, lsl #1
     b92:	1c5e      	adds	r6, r3, #1
     b94:	eb00 0181 	add.w	r1, r0, r1, lsl #2
     b98:	f852 e023 	ldr.w	lr, [r2, r3, lsl #2]
     b9c:	f1c3 0c0c 	rsb	ip, r3, #12
     ba0:	18cf      	adds	r7, r1, r3
     ba2:	b2f3      	uxtb	r3, r6
     ba4:	2b0c      	cmp	r3, #12
     ba6:	f84a e027 	str.w	lr, [sl, r7, lsl #2]
     baa:	f00c 0607 	and.w	r6, ip, #7
     bae:	f200 8089 	bhi.w	cc4 <CovariancePrediction+0x160>
     bb2:	b276      	sxtb	r6, r6
     bb4:	2e00      	cmp	r6, #0
     bb6:	d044      	beq.n	c42 <CovariancePrediction+0xde>
     bb8:	2e01      	cmp	r6, #1
     bba:	d037      	beq.n	c2c <CovariancePrediction+0xc8>
     bbc:	2e02      	cmp	r6, #2
     bbe:	d02d      	beq.n	c1c <CovariancePrediction+0xb8>
     bc0:	2e03      	cmp	r6, #3
     bc2:	d023      	beq.n	c0c <CovariancePrediction+0xa8>
     bc4:	2e04      	cmp	r6, #4
     bc6:	d01a      	beq.n	bfe <CovariancePrediction+0x9a>
     bc8:	2e05      	cmp	r6, #5
     bca:	d010      	beq.n	bee <CovariancePrediction+0x8a>
     bcc:	2e06      	cmp	r6, #6
     bce:	d006      	beq.n	bde <CovariancePrediction+0x7a>
     bd0:	f852 b023 	ldr.w	fp, [r2, r3, lsl #2]
     bd4:	18ce      	adds	r6, r1, r3
     bd6:	3301      	adds	r3, #1
     bd8:	f84a b026 	str.w	fp, [sl, r6, lsl #2]
     bdc:	b2db      	uxtb	r3, r3
     bde:	f852 c023 	ldr.w	ip, [r2, r3, lsl #2]
     be2:	eb01 0803 	add.w	r8, r1, r3
     be6:	3301      	adds	r3, #1
     be8:	f84a c028 	str.w	ip, [sl, r8, lsl #2]
     bec:	b2db      	uxtb	r3, r3
     bee:	f852 7023 	ldr.w	r7, [r2, r3, lsl #2]
     bf2:	eb01 0e03 	add.w	lr, r1, r3
     bf6:	3301      	adds	r3, #1
     bf8:	f84a 702e 	str.w	r7, [sl, lr, lsl #2]
     bfc:	b2db      	uxtb	r3, r3
     bfe:	f852 b023 	ldr.w	fp, [r2, r3, lsl #2]
     c02:	18ce      	adds	r6, r1, r3
     c04:	3301      	adds	r3, #1
     c06:	f84a b026 	str.w	fp, [sl, r6, lsl #2]
     c0a:	b2db      	uxtb	r3, r3
     c0c:	f852 c023 	ldr.w	ip, [r2, r3, lsl #2]
     c10:	eb01 0803 	add.w	r8, r1, r3
     c14:	3301      	adds	r3, #1
     c16:	f84a c028 	str.w	ip, [sl, r8, lsl #2]
     c1a:	b2db      	uxtb	r3, r3
     c1c:	f852 7023 	ldr.w	r7, [r2, r3, lsl #2]
     c20:	eb01 0e03 	add.w	lr, r1, r3
     c24:	3301      	adds	r3, #1
     c26:	f84a 702e 	str.w	r7, [sl, lr, lsl #2]
     c2a:	b2db      	uxtb	r3, r3
     c2c:	f103 0801 	add.w	r8, r3, #1
     c30:	f852 b023 	ldr.w	fp, [r2, r3, lsl #2]
     c34:	18ce      	adds	r6, r1, r3
     c36:	fa5f f388 	uxtb.w	r3, r8
     c3a:	2b0c      	cmp	r3, #12
     c3c:	f84a b026 	str.w	fp, [sl, r6, lsl #2]
     c40:	d840      	bhi.n	cc4 <CovariancePrediction+0x160>
     c42:	f852 b023 	ldr.w	fp, [r2, r3, lsl #2]
     c46:	eb01 0803 	add.w	r8, r1, r3
     c4a:	3301      	adds	r3, #1
     c4c:	f84a b028 	str.w	fp, [sl, r8, lsl #2]
     c50:	b2de      	uxtb	r6, r3
     c52:	f852 e026 	ldr.w	lr, [r2, r6, lsl #2]
     c56:	1c73      	adds	r3, r6, #1
     c58:	eb01 0c06 	add.w	ip, r1, r6
     c5c:	f84a e02c 	str.w	lr, [sl, ip, lsl #2]
     c60:	b2df      	uxtb	r7, r3
     c62:	f852 b027 	ldr.w	fp, [r2, r7, lsl #2]
     c66:	1c7e      	adds	r6, r7, #1
     c68:	eb01 0807 	add.w	r8, r1, r7
     c6c:	f84a b028 	str.w	fp, [sl, r8, lsl #2]
     c70:	b2f3      	uxtb	r3, r6
     c72:	f852 e023 	ldr.w	lr, [r2, r3, lsl #2]
     c76:	1c5e      	adds	r6, r3, #1
     c78:	eb01 0c03 	add.w	ip, r1, r3
     c7c:	f84a e02c 	str.w	lr, [sl, ip, lsl #2]
     c80:	b2f7      	uxtb	r7, r6
     c82:	f852 b027 	ldr.w	fp, [r2, r7, lsl #2]
     c86:	1c7e      	adds	r6, r7, #1
     c88:	eb01 0807 	add.w	r8, r1, r7
     c8c:	f84a b028 	str.w	fp, [sl, r8, lsl #2]
     c90:	b2f3      	uxtb	r3, r6
     c92:	f852 e023 	ldr.w	lr, [r2, r3, lsl #2]
     c96:	1c5e      	adds	r6, r3, #1
     c98:	eb01 0c03 	add.w	ip, r1, r3
     c9c:	f84a e02c 	str.w	lr, [sl, ip, lsl #2]
     ca0:	b2f7      	uxtb	r7, r6
     ca2:	f852 b027 	ldr.w	fp, [r2, r7, lsl #2]
     ca6:	1c7e      	adds	r6, r7, #1
     ca8:	b2f6      	uxtb	r6, r6
     caa:	eb01 0807 	add.w	r8, r1, r7
     cae:	1c73      	adds	r3, r6, #1
     cb0:	f84a b028 	str.w	fp, [sl, r8, lsl #2]
     cb4:	f852 7026 	ldr.w	r7, [r2, r6, lsl #2]
     cb8:	b2db      	uxtb	r3, r3
     cba:	198e      	adds	r6, r1, r6
     cbc:	2b0c      	cmp	r3, #12
     cbe:	f84a 7026 	str.w	r7, [sl, r6, lsl #2]
     cc2:	d9be      	bls.n	c42 <CovariancePrediction+0xde>
     cc4:	3001      	adds	r0, #1
     cc6:	3234      	adds	r2, #52	; 0x34
     cc8:	280d      	cmp	r0, #13
     cca:	f47f af5f 	bne.w	b8c <CovariancePrediction+0x28>
     cce:	f8da 00a8 	ldr.w	r0, [sl, #168]	; 0xa8
     cd2:	9939      	ldr	r1, [sp, #228]	; 0xe4
     cd4:	9063      	str	r0, [sp, #396]	; 0x18c
     cd6:	f7ff fffe 	bl	0 <__aeabi_fmul>
     cda:	f8da 600c 	ldr.w	r6, [sl, #12]
     cde:	4607      	mov	r7, r0
     ce0:	4631      	mov	r1, r6
     ce2:	4630      	mov	r0, r6
     ce4:	f7ff fffe 	bl	0 <__aeabi_fadd>
     ce8:	4601      	mov	r1, r0
     cea:	4620      	mov	r0, r4
     cec:	f7ff fffe 	bl	0 <__aeabi_fmul>
     cf0:	4601      	mov	r1, r0
     cf2:	4638      	mov	r0, r7
     cf4:	f7ff fffe 	bl	0 <__aeabi_fadd>
     cf8:	f8da 1000 	ldr.w	r1, [sl]
     cfc:	f7ff fffe 	bl	0 <__aeabi_fadd>
     d00:	f8da c0ac 	ldr.w	ip, [sl, #172]	; 0xac
     d04:	4649      	mov	r1, r9
     d06:	f8cd c188 	str.w	ip, [sp, #392]	; 0x188
     d0a:	f841 0b34 	str.w	r0, [r1], #52
     d0e:	f8da 0010 	ldr.w	r0, [sl, #16]
     d12:	f8da e040 	ldr.w	lr, [sl, #64]	; 0x40
     d16:	913e      	str	r1, [sp, #248]	; 0xf8
     d18:	9040      	str	r0, [sp, #256]	; 0x100
     d1a:	9939      	ldr	r1, [sp, #228]	; 0xe4
     d1c:	4660      	mov	r0, ip
     d1e:	f8cd e0d4 	str.w	lr, [sp, #212]	; 0xd4
     d22:	f7ff fffe 	bl	0 <__aeabi_fmul>
     d26:	9935      	ldr	r1, [sp, #212]	; 0xd4
     d28:	4680      	mov	r8, r0
     d2a:	9840      	ldr	r0, [sp, #256]	; 0x100
     d2c:	f7ff fffe 	bl	0 <__aeabi_fadd>
     d30:	4601      	mov	r1, r0
     d32:	4620      	mov	r0, r4
     d34:	f7ff fffe 	bl	0 <__aeabi_fmul>
     d38:	4601      	mov	r1, r0
     d3a:	4640      	mov	r0, r8
     d3c:	f7ff fffe 	bl	0 <__aeabi_fadd>
     d40:	f8da 1004 	ldr.w	r1, [sl, #4]
     d44:	f7ff fffe 	bl	0 <__aeabi_fadd>
     d48:	f8da 3014 	ldr.w	r3, [sl, #20]
     d4c:	f8da 2074 	ldr.w	r2, [sl, #116]	; 0x74
     d50:	f8da b0b0 	ldr.w	fp, [sl, #176]	; 0xb0
     d54:	9337      	str	r3, [sp, #220]	; 0xdc
     d56:	924e      	str	r2, [sp, #312]	; 0x138
     d58:	f8cd b1a0 	str.w	fp, [sp, #416]	; 0x1a0
     d5c:	9939      	ldr	r1, [sp, #228]	; 0xe4
     d5e:	f8c9 0034 	str.w	r0, [r9, #52]	; 0x34
     d62:	f8c9 0004 	str.w	r0, [r9, #4]
     d66:	4658      	mov	r0, fp
     d68:	f7ff fffe 	bl	0 <__aeabi_fmul>
     d6c:	994e      	ldr	r1, [sp, #312]	; 0x138
     d6e:	4607      	mov	r7, r0
     d70:	9837      	ldr	r0, [sp, #220]	; 0xdc
     d72:	f7ff fffe 	bl	0 <__aeabi_fadd>
     d76:	4601      	mov	r1, r0
     d78:	4620      	mov	r0, r4
     d7a:	f7ff fffe 	bl	0 <__aeabi_fmul>
     d7e:	4601      	mov	r1, r0
     d80:	4638      	mov	r0, r7
     d82:	f7ff fffe 	bl	0 <__aeabi_fadd>
     d86:	f8da 1008 	ldr.w	r1, [sl, #8]
     d8a:	f7ff fffe 	bl	0 <__aeabi_fadd>
     d8e:	f105 089c 	add.w	r8, r5, #156	; 0x9c
     d92:	f8cd 80cc 	str.w	r8, [sp, #204]	; 0xcc
     d96:	f8c9 0068 	str.w	r0, [r9, #104]	; 0x68
     d9a:	f8c9 0008 	str.w	r0, [r9, #8]
     d9e:	f8da 10b4 	ldr.w	r1, [sl, #180]	; 0xb4
     da2:	f8d5 80b4 	ldr.w	r8, [r5, #180]	; 0xb4
     da6:	f8da 00b8 	ldr.w	r0, [sl, #184]	; 0xb8
     daa:	912f      	str	r1, [sp, #188]	; 0xbc
     dac:	992f      	ldr	r1, [sp, #188]	; 0xbc
     dae:	9031      	str	r0, [sp, #196]	; 0xc4
     db0:	4640      	mov	r0, r8
     db2:	f7ff fffe 	bl	0 <__aeabi_fmul>
     db6:	f8d5 70b8 	ldr.w	r7, [r5, #184]	; 0xb8
     dba:	f8da c0bc 	ldr.w	ip, [sl, #188]	; 0xbc
     dbe:	4683      	mov	fp, r0
     dc0:	9931      	ldr	r1, [sp, #196]	; 0xc4
     dc2:	4638      	mov	r0, r7
     dc4:	f8cd c0c8 	str.w	ip, [sp, #200]	; 0xc8
     dc8:	f7ff fffe 	bl	0 <__aeabi_fmul>
     dcc:	9b33      	ldr	r3, [sp, #204]	; 0xcc
     dce:	4601      	mov	r1, r0
     dd0:	6a1a      	ldr	r2, [r3, #32]
     dd2:	4658      	mov	r0, fp
     dd4:	922e      	str	r2, [sp, #184]	; 0xb8
     dd6:	f7ff fffe 	bl	0 <__aeabi_fadd>
     dda:	f8da e0c0 	ldr.w	lr, [sl, #192]	; 0xc0
     dde:	4683      	mov	fp, r0
     de0:	9932      	ldr	r1, [sp, #200]	; 0xc8
     de2:	982e      	ldr	r0, [sp, #184]	; 0xb8
     de4:	f8cd e110 	str.w	lr, [sp, #272]	; 0x110
     de8:	f7ff fffe 	bl	0 <__aeabi_fmul>
     dec:	9b33      	ldr	r3, [sp, #204]	; 0xcc
     dee:	4601      	mov	r1, r0
     df0:	f8d3 c024 	ldr.w	ip, [r3, #36]	; 0x24
     df4:	4658      	mov	r0, fp
     df6:	f8cd c0b4 	str.w	ip, [sp, #180]	; 0xb4
     dfa:	f7ff fffe 	bl	0 <__aeabi_fadd>
     dfe:	9944      	ldr	r1, [sp, #272]	; 0x110
     e00:	4683      	mov	fp, r0
     e02:	982d      	ldr	r0, [sp, #180]	; 0xb4
     e04:	f7ff fffe 	bl	0 <__aeabi_fmul>
     e08:	4601      	mov	r1, r0
     e0a:	4658      	mov	r0, fp
     e0c:	f8da b018 	ldr.w	fp, [sl, #24]
     e10:	f8cd b104 	str.w	fp, [sp, #260]	; 0x104
     e14:	f7ff fffe 	bl	0 <__aeabi_fadd>
     e18:	9939      	ldr	r1, [sp, #228]	; 0xe4
     e1a:	f7ff fffe 	bl	0 <__aeabi_fmul>
     e1e:	f8da 201c 	ldr.w	r2, [sl, #28]
     e22:	4683      	mov	fp, r0
     e24:	9941      	ldr	r1, [sp, #260]	; 0x104
     e26:	4640      	mov	r0, r8
     e28:	923f      	str	r2, [sp, #252]	; 0xfc
     e2a:	f7ff fffe 	bl	0 <__aeabi_fmul>
     e2e:	4601      	mov	r1, r0
     e30:	9863      	ldr	r0, [sp, #396]	; 0x18c
     e32:	f7ff fffe 	bl	0 <__aeabi_fadd>
     e36:	f8da 3020 	ldr.w	r3, [sl, #32]
     e3a:	4680      	mov	r8, r0
     e3c:	993f      	ldr	r1, [sp, #252]	; 0xfc
     e3e:	4638      	mov	r0, r7
     e40:	9342      	str	r3, [sp, #264]	; 0x108
     e42:	f7ff fffe 	bl	0 <__aeabi_fmul>
     e46:	4601      	mov	r1, r0
     e48:	4640      	mov	r0, r8
     e4a:	f7ff fffe 	bl	0 <__aeabi_fadd>
     e4e:	f8da c024 	ldr.w	ip, [sl, #36]	; 0x24
     e52:	9942      	ldr	r1, [sp, #264]	; 0x108
     e54:	4680      	mov	r8, r0
     e56:	982e      	ldr	r0, [sp, #184]	; 0xb8
     e58:	f8cd c0f4 	str.w	ip, [sp, #244]	; 0xf4
     e5c:	f7ff fffe 	bl	0 <__aeabi_fmul>
     e60:	4601      	mov	r1, r0
     e62:	4640      	mov	r0, r8
     e64:	f7ff fffe 	bl	0 <__aeabi_fadd>
     e68:	993d      	ldr	r1, [sp, #244]	; 0xf4
     e6a:	4607      	mov	r7, r0
     e6c:	982d      	ldr	r0, [sp, #180]	; 0xb4
     e6e:	f7ff fffe 	bl	0 <__aeabi_fmul>
     e72:	4601      	mov	r1, r0
     e74:	4638      	mov	r0, r7
     e76:	f7ff fffe 	bl	0 <__aeabi_fadd>
     e7a:	4601      	mov	r1, r0
     e7c:	4620      	mov	r0, r4
     e7e:	f7ff fffe 	bl	0 <__aeabi_fmul>
     e82:	4601      	mov	r1, r0
     e84:	4658      	mov	r0, fp
     e86:	f7ff fffe 	bl	0 <__aeabi_fadd>
     e8a:	4601      	mov	r1, r0
     e8c:	4630      	mov	r0, r6
     e8e:	f7ff fffe 	bl	0 <__aeabi_fadd>
     e92:	f105 0ed0 	add.w	lr, r5, #208	; 0xd0
     e96:	f8cd e0d0 	str.w	lr, [sp, #208]	; 0xd0
     e9a:	f8c9 009c 	str.w	r0, [r9, #156]	; 0x9c
     e9e:	f8c9 000c 	str.w	r0, [r9, #12]
     ea2:	f8d5 80e8 	ldr.w	r8, [r5, #232]	; 0xe8
     ea6:	982f      	ldr	r0, [sp, #188]	; 0xbc
     ea8:	4641      	mov	r1, r8
     eaa:	f7ff fffe 	bl	0 <__aeabi_fmul>
     eae:	f8d5 70ec 	ldr.w	r7, [r5, #236]	; 0xec
     eb2:	4606      	mov	r6, r0
     eb4:	4639      	mov	r1, r7
     eb6:	9831      	ldr	r0, [sp, #196]	; 0xc4
     eb8:	f7ff fffe 	bl	0 <__aeabi_fmul>
     ebc:	9a34      	ldr	r2, [sp, #208]	; 0xd0
     ebe:	4601      	mov	r1, r0
     ec0:	4630      	mov	r0, r6
     ec2:	6a16      	ldr	r6, [r2, #32]
     ec4:	f7ff fffe 	bl	0 <__aeabi_fadd>
     ec8:	4631      	mov	r1, r6
     eca:	4683      	mov	fp, r0
     ecc:	9832      	ldr	r0, [sp, #200]	; 0xc8
     ece:	f7ff fffe 	bl	0 <__aeabi_fmul>
     ed2:	9b34      	ldr	r3, [sp, #208]	; 0xd0
     ed4:	4601      	mov	r1, r0
     ed6:	f8d3 c024 	ldr.w	ip, [r3, #36]	; 0x24
     eda:	4658      	mov	r0, fp
     edc:	f8cd c0b0 	str.w	ip, [sp, #176]	; 0xb0
     ee0:	f7ff fffe 	bl	0 <__aeabi_fadd>
     ee4:	992c      	ldr	r1, [sp, #176]	; 0xb0
     ee6:	4683      	mov	fp, r0
     ee8:	9844      	ldr	r0, [sp, #272]	; 0x110
     eea:	f7ff fffe 	bl	0 <__aeabi_fmul>
     eee:	4601      	mov	r1, r0
     ef0:	4658      	mov	r0, fp
     ef2:	f7ff fffe 	bl	0 <__aeabi_fadd>
     ef6:	9939      	ldr	r1, [sp, #228]	; 0xe4
     ef8:	f7ff fffe 	bl	0 <__aeabi_fmul>
     efc:	4641      	mov	r1, r8
     efe:	4683      	mov	fp, r0
     f00:	9841      	ldr	r0, [sp, #260]	; 0x104
     f02:	f7ff fffe 	bl	0 <__aeabi_fmul>
     f06:	4601      	mov	r1, r0
     f08:	9862      	ldr	r0, [sp, #392]	; 0x188
     f0a:	f7ff fffe 	bl	0 <__aeabi_fadd>
     f0e:	4639      	mov	r1, r7
     f10:	4680      	mov	r8, r0
     f12:	983f      	ldr	r0, [sp, #252]	; 0xfc
     f14:	f7ff fffe 	bl	0 <__aeabi_fmul>
     f18:	4601      	mov	r1, r0
     f1a:	4640      	mov	r0, r8
     f1c:	f7ff fffe 	bl	0 <__aeabi_fadd>
     f20:	4631      	mov	r1, r6
     f22:	4680      	mov	r8, r0
     f24:	9842      	ldr	r0, [sp, #264]	; 0x108
     f26:	f7ff fffe 	bl	0 <__aeabi_fmul>
     f2a:	4601      	mov	r1, r0
     f2c:	4640      	mov	r0, r8
     f2e:	f7ff fffe 	bl	0 <__aeabi_fadd>
     f32:	992c      	ldr	r1, [sp, #176]	; 0xb0
     f34:	4607      	mov	r7, r0
     f36:	983d      	ldr	r0, [sp, #244]	; 0xf4
     f38:	f7ff fffe 	bl	0 <__aeabi_fmul>
     f3c:	4601      	mov	r1, r0
     f3e:	4638      	mov	r0, r7
     f40:	f7ff fffe 	bl	0 <__aeabi_fadd>
     f44:	4601      	mov	r1, r0
     f46:	4620      	mov	r0, r4
     f48:	f7ff fffe 	bl	0 <__aeabi_fmul>
     f4c:	4601      	mov	r1, r0
     f4e:	4658      	mov	r0, fp
     f50:	f7ff fffe 	bl	0 <__aeabi_fadd>
     f54:	4601      	mov	r1, r0
     f56:	9840      	ldr	r0, [sp, #256]	; 0x100
     f58:	f7ff fffe 	bl	0 <__aeabi_fadd>
     f5c:	f505 7e82 	add.w	lr, r5, #260	; 0x104
     f60:	f8cd e100 	str.w	lr, [sp, #256]	; 0x100
     f64:	f8c9 00d0 	str.w	r0, [r9, #208]	; 0xd0
     f68:	f8c9 0010 	str.w	r0, [r9, #16]
     f6c:	f8d5 811c 	ldr.w	r8, [r5, #284]	; 0x11c
     f70:	982f      	ldr	r0, [sp, #188]	; 0xbc
     f72:	4641      	mov	r1, r8
     f74:	f7ff fffe 	bl	0 <__aeabi_fmul>
     f78:	f8d5 7120 	ldr.w	r7, [r5, #288]	; 0x120
     f7c:	4683      	mov	fp, r0
     f7e:	4639      	mov	r1, r7
     f80:	9831      	ldr	r0, [sp, #196]	; 0xc4
     f82:	f7ff fffe 	bl	0 <__aeabi_fmul>
     f86:	4601      	mov	r1, r0
     f88:	4658      	mov	r0, fp
     f8a:	f7ff fffe 	bl	0 <__aeabi_fadd>
     f8e:	9e40      	ldr	r6, [sp, #256]	; 0x100
     f90:	4683      	mov	fp, r0
     f92:	6a36      	ldr	r6, [r6, #32]
     f94:	9832      	ldr	r0, [sp, #200]	; 0xc8
     f96:	4631      	mov	r1, r6
     f98:	f7ff fffe 	bl	0 <__aeabi_fmul>
     f9c:	9a40      	ldr	r2, [sp, #256]	; 0x100
     f9e:	4601      	mov	r1, r0
     fa0:	6a53      	ldr	r3, [r2, #36]	; 0x24
     fa2:	4658      	mov	r0, fp
     fa4:	932b      	str	r3, [sp, #172]	; 0xac
     fa6:	f7ff fffe 	bl	0 <__aeabi_fadd>
     faa:	992b      	ldr	r1, [sp, #172]	; 0xac
     fac:	4683      	mov	fp, r0
     fae:	9844      	ldr	r0, [sp, #272]	; 0x110
     fb0:	f7ff fffe 	bl	0 <__aeabi_fmul>
     fb4:	4601      	mov	r1, r0
     fb6:	4658      	mov	r0, fp
     fb8:	f7ff fffe 	bl	0 <__aeabi_fadd>
     fbc:	9939      	ldr	r1, [sp, #228]	; 0xe4
     fbe:	f7ff fffe 	bl	0 <__aeabi_fmul>
     fc2:	4641      	mov	r1, r8
     fc4:	4683      	mov	fp, r0
     fc6:	9841      	ldr	r0, [sp, #260]	; 0x104
     fc8:	f7ff fffe 	bl	0 <__aeabi_fmul>
     fcc:	4601      	mov	r1, r0
     fce:	9868      	ldr	r0, [sp, #416]	; 0x1a0
     fd0:	f7ff fffe 	bl	0 <__aeabi_fadd>
     fd4:	4639      	mov	r1, r7
     fd6:	4680      	mov	r8, r0
     fd8:	983f      	ldr	r0, [sp, #252]	; 0xfc
     fda:	f7ff fffe 	bl	0 <__aeabi_fmul>
     fde:	4601      	mov	r1, r0
     fe0:	4640      	mov	r0, r8
     fe2:	f7ff fffe 	bl	0 <__aeabi_fadd>
     fe6:	4631      	mov	r1, r6
     fe8:	4607      	mov	r7, r0
     fea:	9842      	ldr	r0, [sp, #264]	; 0x108
     fec:	f7ff fffe 	bl	0 <__aeabi_fmul>
     ff0:	4601      	mov	r1, r0
     ff2:	4638      	mov	r0, r7
     ff4:	f7ff fffe 	bl	0 <__aeabi_fadd>
     ff8:	992b      	ldr	r1, [sp, #172]	; 0xac
     ffa:	4680      	mov	r8, r0
     ffc:	983d      	ldr	r0, [sp, #244]	; 0xf4
     ffe:	f7ff fffe 	bl	0 <__aeabi_fmul>
    1002:	4601      	mov	r1, r0
    1004:	4640      	mov	r0, r8
    1006:	f7ff fffe 	bl	0 <__aeabi_fadd>
    100a:	4601      	mov	r1, r0
    100c:	4620      	mov	r0, r4
    100e:	f7ff fffe 	bl	0 <__aeabi_fmul>
    1012:	4601      	mov	r1, r0
    1014:	4658      	mov	r0, fp
    1016:	f7ff fffe 	bl	0 <__aeabi_fadd>
    101a:	4601      	mov	r1, r0
    101c:	9837      	ldr	r0, [sp, #220]	; 0xdc
    101e:	f7ff fffe 	bl	0 <__aeabi_fadd>
    1022:	f505 789c 	add.w	r8, r5, #312	; 0x138
    1026:	f8c9 0104 	str.w	r0, [r9, #260]	; 0x104
    102a:	f8c9 0014 	str.w	r0, [r9, #20]
    102e:	f8d8 701c 	ldr.w	r7, [r8, #28]
    1032:	9831      	ldr	r0, [sp, #196]	; 0xc4
    1034:	4639      	mov	r1, r7
    1036:	f7ff fffe 	bl	0 <__aeabi_fmul>
    103a:	f8d8 6020 	ldr.w	r6, [r8, #32]
    103e:	4683      	mov	fp, r0
    1040:	4631      	mov	r1, r6
    1042:	9832      	ldr	r0, [sp, #200]	; 0xc8
    1044:	f7ff fffe 	bl	0 <__aeabi_fmul>
    1048:	4601      	mov	r1, r0
    104a:	4658      	mov	r0, fp
    104c:	f7ff fffe 	bl	0 <__aeabi_fadd>
    1050:	f8da 20c4 	ldr.w	r2, [sl, #196]	; 0xc4
    1054:	f8d8 1024 	ldr.w	r1, [r8, #36]	; 0x24
    1058:	4683      	mov	fp, r0
    105a:	9844      	ldr	r0, [sp, #272]	; 0x110
    105c:	923a      	str	r2, [sp, #232]	; 0xe8
    105e:	f7ff fffe 	bl	0 <__aeabi_fmul>
    1062:	4601      	mov	r1, r0
    1064:	4658      	mov	r0, fp
    1066:	f7ff fffe 	bl	0 <__aeabi_fadd>
    106a:	f8da c0c8 	ldr.w	ip, [sl, #200]	; 0xc8
    106e:	4683      	mov	fp, r0
    1070:	993a      	ldr	r1, [sp, #232]	; 0xe8
    1072:	f8d8 0028 	ldr.w	r0, [r8, #40]	; 0x28
    1076:	f8cd c134 	str.w	ip, [sp, #308]	; 0x134
    107a:	f7ff fffe 	bl	0 <__aeabi_fmul>
    107e:	4601      	mov	r1, r0
    1080:	4658      	mov	r0, fp
    1082:	f7ff fffe 	bl	0 <__aeabi_fadd>
    1086:	f8da 30cc 	ldr.w	r3, [sl, #204]	; 0xcc
    108a:	4683      	mov	fp, r0
    108c:	994d      	ldr	r1, [sp, #308]	; 0x134
    108e:	f8d8 002c 	ldr.w	r0, [r8, #44]	; 0x2c
    1092:	9345      	str	r3, [sp, #276]	; 0x114
    1094:	f7ff fffe 	bl	0 <__aeabi_fmul>
    1098:	4601      	mov	r1, r0
    109a:	4658      	mov	r0, fp
    109c:	f7ff fffe 	bl	0 <__aeabi_fadd>
    10a0:	9945      	ldr	r1, [sp, #276]	; 0x114
    10a2:	4683      	mov	fp, r0
    10a4:	f8d8 0030 	ldr.w	r0, [r8, #48]	; 0x30
    10a8:	f7ff fffe 	bl	0 <__aeabi_fmul>
    10ac:	4601      	mov	r1, r0
    10ae:	4658      	mov	r0, fp
    10b0:	f7ff fffe 	bl	0 <__aeabi_fadd>
    10b4:	9939      	ldr	r1, [sp, #228]	; 0xe4
    10b6:	f7ff fffe 	bl	0 <__aeabi_fmul>
    10ba:	4639      	mov	r1, r7
    10bc:	4683      	mov	fp, r0
    10be:	983f      	ldr	r0, [sp, #252]	; 0xfc
    10c0:	f7ff fffe 	bl	0 <__aeabi_fmul>
    10c4:	4601      	mov	r1, r0
    10c6:	982f      	ldr	r0, [sp, #188]	; 0xbc
    10c8:	f7ff fffe 	bl	0 <__aeabi_fadd>
    10cc:	4631      	mov	r1, r6
    10ce:	4607      	mov	r7, r0
    10d0:	9842      	ldr	r0, [sp, #264]	; 0x108
    10d2:	f7ff fffe 	bl	0 <__aeabi_fmul>
    10d6:	4601      	mov	r1, r0
    10d8:	4638      	mov	r0, r7
    10da:	f7ff fffe 	bl	0 <__aeabi_fadd>
    10de:	f8da e028 	ldr.w	lr, [sl, #40]	; 0x28
    10e2:	f8d8 1024 	ldr.w	r1, [r8, #36]	; 0x24
    10e6:	4606      	mov	r6, r0
    10e8:	983d      	ldr	r0, [sp, #244]	; 0xf4
    10ea:	f8cd e0dc 	str.w	lr, [sp, #220]	; 0xdc
    10ee:	f7ff fffe 	bl	0 <__aeabi_fmul>
    10f2:	4601      	mov	r1, r0
    10f4:	4630      	mov	r0, r6
    10f6:	f7ff fffe 	bl	0 <__aeabi_fadd>
    10fa:	f8da 202c 	ldr.w	r2, [sl, #44]	; 0x2c
    10fe:	9937      	ldr	r1, [sp, #220]	; 0xdc
    1100:	4607      	mov	r7, r0
    1102:	f8d8 0028 	ldr.w	r0, [r8, #40]	; 0x28
    1106:	9230      	str	r2, [sp, #192]	; 0xc0
    1108:	f7ff fffe 	bl	0 <__aeabi_fmul>
    110c:	4601      	mov	r1, r0
    110e:	4638      	mov	r0, r7
    1110:	f7ff fffe 	bl	0 <__aeabi_fadd>
    1114:	f8da c030 	ldr.w	ip, [sl, #48]	; 0x30
    1118:	9930      	ldr	r1, [sp, #192]	; 0xc0
    111a:	4606      	mov	r6, r0
    111c:	f8d8 002c 	ldr.w	r0, [r8, #44]	; 0x2c
    1120:	f8cd c0d8 	str.w	ip, [sp, #216]	; 0xd8
    1124:	f7ff fffe 	bl	0 <__aeabi_fmul>
    1128:	4601      	mov	r1, r0
    112a:	4630      	mov	r0, r6
    112c:	f7ff fffe 	bl	0 <__aeabi_fadd>
    1130:	9936      	ldr	r1, [sp, #216]	; 0xd8
    1132:	4607      	mov	r7, r0
    1134:	f8d8 0030 	ldr.w	r0, [r8, #48]	; 0x30
    1138:	f7ff fffe 	bl	0 <__aeabi_fmul>
    113c:	4601      	mov	r1, r0
    113e:	4638      	mov	r0, r7
    1140:	f7ff fffe 	bl	0 <__aeabi_fadd>
    1144:	4601      	mov	r1, r0
    1146:	4620      	mov	r0, r4
    1148:	f7ff fffe 	bl	0 <__aeabi_fmul>
    114c:	4601      	mov	r1, r0
    114e:	4658      	mov	r0, fp
    1150:	f7ff fffe 	bl	0 <__aeabi_fadd>
    1154:	4601      	mov	r1, r0
    1156:	9841      	ldr	r0, [sp, #260]	; 0x104
    1158:	f7ff fffe 	bl	0 <__aeabi_fadd>
    115c:	f505 77b6 	add.w	r7, r5, #364	; 0x16c
    1160:	f8c9 0138 	str.w	r0, [r9, #312]	; 0x138
    1164:	f8c9 0018 	str.w	r0, [r9, #24]
    1168:	69be      	ldr	r6, [r7, #24]
    116a:	982f      	ldr	r0, [sp, #188]	; 0xbc
    116c:	4631      	mov	r1, r6
    116e:	f7ff fffe 	bl	0 <__aeabi_fmul>
    1172:	6a39      	ldr	r1, [r7, #32]
    1174:	4683      	mov	fp, r0
    1176:	9832      	ldr	r0, [sp, #200]	; 0xc8
    1178:	f7ff fffe 	bl	0 <__aeabi_fmul>
    117c:	4601      	mov	r1, r0
    117e:	4658      	mov	r0, fp
    1180:	f7ff fffe 	bl	0 <__aeabi_fadd>
    1184:	6a79      	ldr	r1, [r7, #36]	; 0x24
    1186:	4683      	mov	fp, r0
    1188:	9844      	ldr	r0, [sp, #272]	; 0x110
    118a:	f7ff fffe 	bl	0 <__aeabi_fmul>
    118e:	4601      	mov	r1, r0
    1190:	4658      	mov	r0, fp
    1192:	f7ff fffe 	bl	0 <__aeabi_fadd>
    1196:	6ab9      	ldr	r1, [r7, #40]	; 0x28
    1198:	4683      	mov	fp, r0
    119a:	983a      	ldr	r0, [sp, #232]	; 0xe8
    119c:	f7ff fffe 	bl	0 <__aeabi_fmul>
    11a0:	4601      	mov	r1, r0
    11a2:	4658      	mov	r0, fp
    11a4:	f7ff fffe 	bl	0 <__aeabi_fadd>
    11a8:	6af9      	ldr	r1, [r7, #44]	; 0x2c
    11aa:	4683      	mov	fp, r0
    11ac:	984d      	ldr	r0, [sp, #308]	; 0x134
    11ae:	f7ff fffe 	bl	0 <__aeabi_fmul>
    11b2:	4601      	mov	r1, r0
    11b4:	4658      	mov	r0, fp
    11b6:	f7ff fffe 	bl	0 <__aeabi_fadd>
    11ba:	6b39      	ldr	r1, [r7, #48]	; 0x30
    11bc:	4683      	mov	fp, r0
    11be:	9845      	ldr	r0, [sp, #276]	; 0x114
    11c0:	f7ff fffe 	bl	0 <__aeabi_fmul>
    11c4:	4601      	mov	r1, r0
    11c6:	4658      	mov	r0, fp
    11c8:	f7ff fffe 	bl	0 <__aeabi_fadd>
    11cc:	9939      	ldr	r1, [sp, #228]	; 0xe4
    11ce:	f7ff fffe 	bl	0 <__aeabi_fmul>
    11d2:	4631      	mov	r1, r6
    11d4:	4683      	mov	fp, r0
    11d6:	9841      	ldr	r0, [sp, #260]	; 0x104
    11d8:	f7ff fffe 	bl	0 <__aeabi_fmul>
    11dc:	4601      	mov	r1, r0
    11de:	9831      	ldr	r0, [sp, #196]	; 0xc4
    11e0:	f7ff fffe 	bl	0 <__aeabi_fadd>
    11e4:	6a39      	ldr	r1, [r7, #32]
    11e6:	4606      	mov	r6, r0
    11e8:	9842      	ldr	r0, [sp, #264]	; 0x108
    11ea:	f7ff fffe 	bl	0 <__aeabi_fmul>
    11ee:	4601      	mov	r1, r0
    11f0:	4630      	mov	r0, r6
    11f2:	f7ff fffe 	bl	0 <__aeabi_fadd>
    11f6:	6a79      	ldr	r1, [r7, #36]	; 0x24
    11f8:	4606      	mov	r6, r0
    11fa:	983d      	ldr	r0, [sp, #244]	; 0xf4
    11fc:	f7ff fffe 	bl	0 <__aeabi_fmul>
    1200:	4601      	mov	r1, r0
    1202:	4630      	mov	r0, r6
    1204:	f7ff fffe 	bl	0 <__aeabi_fadd>
    1208:	6ab9      	ldr	r1, [r7, #40]	; 0x28
    120a:	4606      	mov	r6, r0
    120c:	9837      	ldr	r0, [sp, #220]	; 0xdc
    120e:	f7ff fffe 	bl	0 <__aeabi_fmul>
    1212:	4601      	mov	r1, r0
    1214:	4630      	mov	r0, r6
    1216:	f7ff fffe 	bl	0 <__aeabi_fadd>
    121a:	6af9      	ldr	r1, [r7, #44]	; 0x2c
    121c:	4606      	mov	r6, r0
    121e:	9830      	ldr	r0, [sp, #192]	; 0xc0
    1220:	f7ff fffe 	bl	0 <__aeabi_fmul>
    1224:	4601      	mov	r1, r0
    1226:	4630      	mov	r0, r6
    1228:	f7ff fffe 	bl	0 <__aeabi_fadd>
    122c:	6b39      	ldr	r1, [r7, #48]	; 0x30
    122e:	4606      	mov	r6, r0
    1230:	9836      	ldr	r0, [sp, #216]	; 0xd8
    1232:	f7ff fffe 	bl	0 <__aeabi_fmul>
    1236:	4601      	mov	r1, r0
    1238:	4630      	mov	r0, r6
    123a:	f7ff fffe 	bl	0 <__aeabi_fadd>
    123e:	4601      	mov	r1, r0
    1240:	4620      	mov	r0, r4
    1242:	f7ff fffe 	bl	0 <__aeabi_fmul>
    1246:	4601      	mov	r1, r0
    1248:	4658      	mov	r0, fp
    124a:	f7ff fffe 	bl	0 <__aeabi_fadd>
    124e:	4601      	mov	r1, r0
    1250:	983f      	ldr	r0, [sp, #252]	; 0xfc
    1252:	f7ff fffe 	bl	0 <__aeabi_fadd>
    1256:	f505 76d0 	add.w	r6, r5, #416	; 0x1a0
    125a:	f8c9 016c 	str.w	r0, [r9, #364]	; 0x16c
    125e:	f8c9 001c 	str.w	r0, [r9, #28]
    1262:	69b3      	ldr	r3, [r6, #24]
    1264:	982f      	ldr	r0, [sp, #188]	; 0xbc
    1266:	4619      	mov	r1, r3
    1268:	9303      	str	r3, [sp, #12]
    126a:	f7ff fffe 	bl	0 <__aeabi_fmul>
    126e:	69f1      	ldr	r1, [r6, #28]
    1270:	4683      	mov	fp, r0
    1272:	9831      	ldr	r0, [sp, #196]	; 0xc4
    1274:	f7ff fffe 	bl	0 <__aeabi_fmul>
    1278:	4601      	mov	r1, r0
    127a:	4658      	mov	r0, fp
    127c:	f7ff fffe 	bl	0 <__aeabi_fadd>
    1280:	6a71      	ldr	r1, [r6, #36]	; 0x24
    1282:	4683      	mov	fp, r0
    1284:	9844      	ldr	r0, [sp, #272]	; 0x110
    1286:	f7ff fffe 	bl	0 <__aeabi_fmul>
    128a:	4601      	mov	r1, r0
    128c:	4658      	mov	r0, fp
    128e:	f7ff fffe 	bl	0 <__aeabi_fadd>
    1292:	6ab1      	ldr	r1, [r6, #40]	; 0x28
    1294:	4683      	mov	fp, r0
    1296:	983a      	ldr	r0, [sp, #232]	; 0xe8
    1298:	f7ff fffe 	bl	0 <__aeabi_fmul>
    129c:	4601      	mov	r1, r0
    129e:	4658      	mov	r0, fp
    12a0:	f7ff fffe 	bl	0 <__aeabi_fadd>
    12a4:	6af1      	ldr	r1, [r6, #44]	; 0x2c
    12a6:	4683      	mov	fp, r0
    12a8:	984d      	ldr	r0, [sp, #308]	; 0x134
    12aa:	f7ff fffe 	bl	0 <__aeabi_fmul>
    12ae:	4601      	mov	r1, r0
    12b0:	4658      	mov	r0, fp
    12b2:	f7ff fffe 	bl	0 <__aeabi_fadd>
    12b6:	6b31      	ldr	r1, [r6, #48]	; 0x30
    12b8:	4683      	mov	fp, r0
    12ba:	9845      	ldr	r0, [sp, #276]	; 0x114
    12bc:	f7ff fffe 	bl	0 <__aeabi_fmul>
    12c0:	4601      	mov	r1, r0
    12c2:	4658      	mov	r0, fp
    12c4:	f7ff fffe 	bl	0 <__aeabi_fadd>
    12c8:	9939      	ldr	r1, [sp, #228]	; 0xe4
    12ca:	f7ff fffe 	bl	0 <__aeabi_fmul>
    12ce:	9903      	ldr	r1, [sp, #12]
    12d0:	4602      	mov	r2, r0
    12d2:	9841      	ldr	r0, [sp, #260]	; 0x104
    12d4:	9201      	str	r2, [sp, #4]
    12d6:	f7ff fffe 	bl	0 <__aeabi_fmul>
    12da:	4601      	mov	r1, r0
    12dc:	9832      	ldr	r0, [sp, #200]	; 0xc8
    12de:	f7ff fffe 	bl	0 <__aeabi_fadd>
    12e2:	69f1      	ldr	r1, [r6, #28]
    12e4:	4683      	mov	fp, r0
    12e6:	983f      	ldr	r0, [sp, #252]	; 0xfc
    12e8:	f7ff fffe 	bl	0 <__aeabi_fmul>
    12ec:	4601      	mov	r1, r0
    12ee:	4658      	mov	r0, fp
    12f0:	f7ff fffe 	bl	0 <__aeabi_fadd>
    12f4:	6a71      	ldr	r1, [r6, #36]	; 0x24
    12f6:	4683      	mov	fp, r0
    12f8:	983d      	ldr	r0, [sp, #244]	; 0xf4
    12fa:	f7ff fffe 	bl	0 <__aeabi_fmul>
    12fe:	4601      	mov	r1, r0
    1300:	4658      	mov	r0, fp
    1302:	f7ff fffe 	bl	0 <__aeabi_fadd>
    1306:	6ab1      	ldr	r1, [r6, #40]	; 0x28
    1308:	4683      	mov	fp, r0
    130a:	9837      	ldr	r0, [sp, #220]	; 0xdc
    130c:	f7ff fffe 	bl	0 <__aeabi_fmul>
    1310:	4601      	mov	r1, r0
    1312:	4658      	mov	r0, fp
    1314:	f7ff fffe 	bl	0 <__aeabi_fadd>
    1318:	6af1      	ldr	r1, [r6, #44]	; 0x2c
    131a:	4683      	mov	fp, r0
    131c:	9830      	ldr	r0, [sp, #192]	; 0xc0
    131e:	f7ff fffe 	bl	0 <__aeabi_fmul>
    1322:	4601      	mov	r1, r0
    1324:	4658      	mov	r0, fp
    1326:	f7ff fffe 	bl	0 <__aeabi_fadd>
    132a:	6b31      	ldr	r1, [r6, #48]	; 0x30
    132c:	4683      	mov	fp, r0
    132e:	9836      	ldr	r0, [sp, #216]	; 0xd8
    1330:	f7ff fffe 	bl	0 <__aeabi_fmul>
    1334:	4601      	mov	r1, r0
    1336:	4658      	mov	r0, fp
    1338:	f7ff fffe 	bl	0 <__aeabi_fadd>
    133c:	4601      	mov	r1, r0
    133e:	4620      	mov	r0, r4
    1340:	f7ff fffe 	bl	0 <__aeabi_fmul>
    1344:	4601      	mov	r1, r0
    1346:	9801      	ldr	r0, [sp, #4]
    1348:	f7ff fffe 	bl	0 <__aeabi_fadd>
    134c:	4601      	mov	r1, r0
    134e:	9842      	ldr	r0, [sp, #264]	; 0x108
    1350:	f7ff fffe 	bl	0 <__aeabi_fadd>
    1354:	f505 75ea 	add.w	r5, r5, #468	; 0x1d4
    1358:	f8c9 01a0 	str.w	r0, [r9, #416]	; 0x1a0
    135c:	f8c9 0020 	str.w	r0, [r9, #32]
    1360:	69aa      	ldr	r2, [r5, #24]
    1362:	982f      	ldr	r0, [sp, #188]	; 0xbc
    1364:	4611      	mov	r1, r2
    1366:	9203      	str	r2, [sp, #12]
    1368:	f7ff fffe 	bl	0 <__aeabi_fmul>
    136c:	69e9      	ldr	r1, [r5, #28]
    136e:	4683      	mov	fp, r0
    1370:	9831      	ldr	r0, [sp, #196]	; 0xc4
    1372:	f7ff fffe 	bl	0 <__aeabi_fmul>
    1376:	4601      	mov	r1, r0
    1378:	4658      	mov	r0, fp
    137a:	f7ff fffe 	bl	0 <__aeabi_fadd>
    137e:	6a29      	ldr	r1, [r5, #32]
    1380:	4683      	mov	fp, r0
    1382:	9832      	ldr	r0, [sp, #200]	; 0xc8
    1384:	f7ff fffe 	bl	0 <__aeabi_fmul>
    1388:	4601      	mov	r1, r0
    138a:	4658      	mov	r0, fp
    138c:	f7ff fffe 	bl	0 <__aeabi_fadd>
    1390:	6aa9      	ldr	r1, [r5, #40]	; 0x28
    1392:	4683      	mov	fp, r0
    1394:	983a      	ldr	r0, [sp, #232]	; 0xe8
    1396:	f7ff fffe 	bl	0 <__aeabi_fmul>
    139a:	4601      	mov	r1, r0
    139c:	4658      	mov	r0, fp
    139e:	f7ff fffe 	bl	0 <__aeabi_fadd>
    13a2:	6ae9      	ldr	r1, [r5, #44]	; 0x2c
    13a4:	4683      	mov	fp, r0
    13a6:	984d      	ldr	r0, [sp, #308]	; 0x134
    13a8:	f7ff fffe 	bl	0 <__aeabi_fmul>
    13ac:	4601      	mov	r1, r0
    13ae:	4658      	mov	r0, fp
    13b0:	f7ff fffe 	bl	0 <__aeabi_fadd>
    13b4:	6b29      	ldr	r1, [r5, #48]	; 0x30
    13b6:	4683      	mov	fp, r0
    13b8:	9845      	ldr	r0, [sp, #276]	; 0x114
    13ba:	f7ff fffe 	bl	0 <__aeabi_fmul>
    13be:	4601      	mov	r1, r0
    13c0:	4658      	mov	r0, fp
    13c2:	f7ff fffe 	bl	0 <__aeabi_fadd>
    13c6:	9939      	ldr	r1, [sp, #228]	; 0xe4
    13c8:	f7ff fffe 	bl	0 <__aeabi_fmul>
    13cc:	9b03      	ldr	r3, [sp, #12]
    13ce:	4602      	mov	r2, r0
    13d0:	4619      	mov	r1, r3
    13d2:	9841      	ldr	r0, [sp, #260]	; 0x104
    13d4:	9201      	str	r2, [sp, #4]
    13d6:	f7ff fffe 	bl	0 <__aeabi_fmul>
    13da:	4601      	mov	r1, r0
    13dc:	9844      	ldr	r0, [sp, #272]	; 0x110
    13de:	f7ff fffe 	bl	0 <__aeabi_fadd>
    13e2:	69e9      	ldr	r1, [r5, #28]
    13e4:	4683      	mov	fp, r0
    13e6:	983f      	ldr	r0, [sp, #252]	; 0xfc
    13e8:	f7ff fffe 	bl	0 <__aeabi_fmul>
    13ec:	4601      	mov	r1, r0
    13ee:	4658      	mov	r0, fp
    13f0:	f7ff fffe 	bl	0 <__aeabi_fadd>
    13f4:	6a29      	ldr	r1, [r5, #32]
    13f6:	4683      	mov	fp, r0
    13f8:	9842      	ldr	r0, [sp, #264]	; 0x108
    13fa:	f7ff fffe 	bl	0 <__aeabi_fmul>
    13fe:	4601      	mov	r1, r0
    1400:	4658      	mov	r0, fp
    1402:	f7ff fffe 	bl	0 <__aeabi_fadd>
    1406:	6aa9      	ldr	r1, [r5, #40]	; 0x28
    1408:	4683      	mov	fp, r0
    140a:	9837      	ldr	r0, [sp, #220]	; 0xdc
    140c:	f7ff fffe 	bl	0 <__aeabi_fmul>
    1410:	4601      	mov	r1, r0
    1412:	4658      	mov	r0, fp
    1414:	f7ff fffe 	bl	0 <__aeabi_fadd>
    1418:	6ae9      	ldr	r1, [r5, #44]	; 0x2c
    141a:	4683      	mov	fp, r0
    141c:	9830      	ldr	r0, [sp, #192]	; 0xc0
    141e:	f7ff fffe 	bl	0 <__aeabi_fmul>
    1422:	4601      	mov	r1, r0
    1424:	4658      	mov	r0, fp
    1426:	f7ff fffe 	bl	0 <__aeabi_fadd>
    142a:	6b29      	ldr	r1, [r5, #48]	; 0x30
    142c:	4683      	mov	fp, r0
    142e:	9836      	ldr	r0, [sp, #216]	; 0xd8
    1430:	f7ff fffe 	bl	0 <__aeabi_fmul>
    1434:	4601      	mov	r1, r0
    1436:	4658      	mov	r0, fp
    1438:	f7ff fffe 	bl	0 <__aeabi_fadd>
    143c:	4601      	mov	r1, r0
    143e:	4620      	mov	r0, r4
    1440:	f7ff fffe 	bl	0 <__aeabi_fmul>
    1444:	4601      	mov	r1, r0
    1446:	9801      	ldr	r0, [sp, #4]
    1448:	f7ff fffe 	bl	0 <__aeabi_fadd>
    144c:	4601      	mov	r1, r0
    144e:	983d      	ldr	r0, [sp, #244]	; 0xf4
    1450:	f7ff fffe 	bl	0 <__aeabi_fadd>
    1454:	4601      	mov	r1, r0
    1456:	f8c9 01d4 	str.w	r0, [r9, #468]	; 0x1d4
    145a:	f8c9 1024 	str.w	r1, [r9, #36]	; 0x24
    145e:	4620      	mov	r0, r4
    1460:	993a      	ldr	r1, [sp, #232]	; 0xe8
    1462:	f7ff fffe 	bl	0 <__aeabi_fmul>
    1466:	4601      	mov	r1, r0
    1468:	9837      	ldr	r0, [sp, #220]	; 0xdc
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
    1728:	f8cc 0010 	str.w	r0, [ip, #16]
    172c:	9840      	ldr	r0, [sp, #256]	; 0x100
    172e:	6982      	ldr	r2, [r0, #24]
    1730:	69c1      	ldr	r1, [r0, #28]
    1732:	9847      	ldr	r0, [sp, #284]	; 0x11c
    1734:	9124      	str	r1, [sp, #144]	; 0x90
    1736:	4611      	mov	r1, r2
    1738:	9203      	str	r2, [sp, #12]
    173a:	f7ff fffe 	bl	0 <__aeabi_fmul>
    173e:	9924      	ldr	r1, [sp, #144]	; 0x90
    1740:	4683      	mov	fp, r0
    1742:	9851      	ldr	r0, [sp, #324]	; 0x144
    1744:	f7ff fffe 	bl	0 <__aeabi_fmul>
    1748:	9b40      	ldr	r3, [sp, #256]	; 0x100
    174a:	4601      	mov	r1, r0
    174c:	6a1a      	ldr	r2, [r3, #32]
    174e:	4658      	mov	r0, fp
    1750:	9223      	str	r2, [sp, #140]	; 0x8c
    1752:	f7ff fffe 	bl	0 <__aeabi_fadd>
    1756:	9923      	ldr	r1, [sp, #140]	; 0x8c
    1758:	4683      	mov	fp, r0
    175a:	985f      	ldr	r0, [sp, #380]	; 0x17c
    175c:	f7ff fffe 	bl	0 <__aeabi_fmul>
    1760:	f8dd e100 	ldr.w	lr, [sp, #256]	; 0x100
    1764:	4601      	mov	r1, r0
    1766:	f8de c024 	ldr.w	ip, [lr, #36]	; 0x24
    176a:	4658      	mov	r0, fp
    176c:	f8cd c088 	str.w	ip, [sp, #136]	; 0x88
    1770:	f7ff fffe 	bl	0 <__aeabi_fadd>
    1774:	9922      	ldr	r1, [sp, #136]	; 0x88
    1776:	4683      	mov	fp, r0
    1778:	984c      	ldr	r0, [sp, #304]	; 0x130
    177a:	f7ff fffe 	bl	0 <__aeabi_fmul>
    177e:	4601      	mov	r1, r0
    1780:	4658      	mov	r0, fp
    1782:	f7ff fffe 	bl	0 <__aeabi_fadd>
    1786:	9939      	ldr	r1, [sp, #228]	; 0xe4
    1788:	f7ff fffe 	bl	0 <__aeabi_fmul>
    178c:	9b03      	ldr	r3, [sp, #12]
    178e:	4602      	mov	r2, r0
    1790:	4619      	mov	r1, r3
    1792:	983f      	ldr	r0, [sp, #252]	; 0xfc
    1794:	9201      	str	r2, [sp, #4]
    1796:	f7ff fffe 	bl	0 <__aeabi_fmul>
    179a:	4601      	mov	r1, r0
    179c:	9869      	ldr	r0, [sp, #420]	; 0x1a4
    179e:	f7ff fffe 	bl	0 <__aeabi_fadd>
    17a2:	9924      	ldr	r1, [sp, #144]	; 0x90
    17a4:	4683      	mov	fp, r0
    17a6:	9842      	ldr	r0, [sp, #264]	; 0x108
    17a8:	f7ff fffe 	bl	0 <__aeabi_fmul>
    17ac:	4601      	mov	r1, r0
    17ae:	4658      	mov	r0, fp
    17b0:	f7ff fffe 	bl	0 <__aeabi_fadd>
    17b4:	9923      	ldr	r1, [sp, #140]	; 0x8c
    17b6:	4683      	mov	fp, r0
    17b8:	983d      	ldr	r0, [sp, #244]	; 0xf4
    17ba:	f7ff fffe 	bl	0 <__aeabi_fmul>
    17be:	4601      	mov	r1, r0
    17c0:	4658      	mov	r0, fp
    17c2:	f7ff fffe 	bl	0 <__aeabi_fadd>
    17c6:	9922      	ldr	r1, [sp, #136]	; 0x88
    17c8:	4683      	mov	fp, r0
    17ca:	9837      	ldr	r0, [sp, #220]	; 0xdc
    17cc:	f7ff fffe 	bl	0 <__aeabi_fmul>
    17d0:	4601      	mov	r1, r0
    17d2:	4658      	mov	r0, fp
    17d4:	f7ff fffe 	bl	0 <__aeabi_fadd>
    17d8:	4601      	mov	r1, r0
    17da:	4620      	mov	r0, r4
    17dc:	f7ff fffe 	bl	0 <__aeabi_fmul>
    17e0:	4601      	mov	r1, r0
    17e2:	9801      	ldr	r0, [sp, #4]
    17e4:	f7ff fffe 	bl	0 <__aeabi_fadd>
    17e8:	f509 7282 	add.w	r2, r9, #260	; 0x104
    17ec:	4601      	mov	r1, r0
    17ee:	9830      	ldr	r0, [sp, #192]	; 0xc0
    17f0:	9257      	str	r2, [sp, #348]	; 0x15c
    17f2:	f7ff fffe 	bl	0 <__aeabi_fadd>
    17f6:	f8dd e0f8 	ldr.w	lr, [sp, #248]	; 0xf8
    17fa:	9957      	ldr	r1, [sp, #348]	; 0x15c
    17fc:	6048      	str	r0, [r1, #4]
    17fe:	f8ce 0014 	str.w	r0, [lr, #20]
    1802:	f8d8 301c 	ldr.w	r3, [r8, #28]
    1806:	9851      	ldr	r0, [sp, #324]	; 0x144
    1808:	4619      	mov	r1, r3
    180a:	9303      	str	r3, [sp, #12]
    180c:	f7ff fffe 	bl	0 <__aeabi_fmul>
    1810:	f8d8 1020 	ldr.w	r1, [r8, #32]
    1814:	4683      	mov	fp, r0
    1816:	985f      	ldr	r0, [sp, #380]	; 0x17c
    1818:	f7ff fffe 	bl	0 <__aeabi_fmul>
    181c:	4601      	mov	r1, r0
    181e:	4658      	mov	r0, fp
    1820:	f7ff fffe 	bl	0 <__aeabi_fadd>
    1824:	f8da 20f8 	ldr.w	r2, [sl, #248]	; 0xf8
    1828:	f8d8 1024 	ldr.w	r1, [r8, #36]	; 0x24
    182c:	4683      	mov	fp, r0
    182e:	984c      	ldr	r0, [sp, #304]	; 0x130
    1830:	9254      	str	r2, [sp, #336]	; 0x150
    1832:	f7ff fffe 	bl	0 <__aeabi_fmul>
    1836:	4601      	mov	r1, r0
    1838:	4658      	mov	r0, fp
    183a:	f7ff fffe 	bl	0 <__aeabi_fadd>
    183e:	f8da 30fc 	ldr.w	r3, [sl, #252]	; 0xfc
    1842:	4683      	mov	fp, r0
    1844:	9954      	ldr	r1, [sp, #336]	; 0x150
    1846:	f8d8 0028 	ldr.w	r0, [r8, #40]	; 0x28
    184a:	9358      	str	r3, [sp, #352]	; 0x160
    184c:	f7ff fffe 	bl	0 <__aeabi_fmul>
    1850:	4601      	mov	r1, r0
    1852:	4658      	mov	r0, fp
    1854:	f7ff fffe 	bl	0 <__aeabi_fadd>
    1858:	f8da c100 	ldr.w	ip, [sl, #256]	; 0x100
    185c:	4683      	mov	fp, r0
    185e:	9958      	ldr	r1, [sp, #352]	; 0x160
    1860:	f8d8 002c 	ldr.w	r0, [r8, #44]	; 0x2c
    1864:	f8cd c154 	str.w	ip, [sp, #340]	; 0x154
    1868:	f7ff fffe 	bl	0 <__aeabi_fmul>
    186c:	4601      	mov	r1, r0
    186e:	4658      	mov	r0, fp
    1870:	f7ff fffe 	bl	0 <__aeabi_fadd>
    1874:	9955      	ldr	r1, [sp, #340]	; 0x154
    1876:	4683      	mov	fp, r0
    1878:	f8d8 0030 	ldr.w	r0, [r8, #48]	; 0x30
    187c:	f7ff fffe 	bl	0 <__aeabi_fmul>
    1880:	4601      	mov	r1, r0
    1882:	4658      	mov	r0, fp
    1884:	f7ff fffe 	bl	0 <__aeabi_fadd>
    1888:	9939      	ldr	r1, [sp, #228]	; 0xe4
    188a:	f7ff fffe 	bl	0 <__aeabi_fmul>
    188e:	9903      	ldr	r1, [sp, #12]
    1890:	4602      	mov	r2, r0
    1892:	9842      	ldr	r0, [sp, #264]	; 0x108
    1894:	9201      	str	r2, [sp, #4]
    1896:	f7ff fffe 	bl	0 <__aeabi_fmul>
    189a:	4601      	mov	r1, r0
    189c:	9847      	ldr	r0, [sp, #284]	; 0x11c
    189e:	f7ff fffe 	bl	0 <__aeabi_fadd>
    18a2:	f8d8 1020 	ldr.w	r1, [r8, #32]
    18a6:	4683      	mov	fp, r0
    18a8:	983d      	ldr	r0, [sp, #244]	; 0xf4
    18aa:	f7ff fffe 	bl	0 <__aeabi_fmul>
    18ae:	4601      	mov	r1, r0
    18b0:	4658      	mov	r0, fp
    18b2:	f7ff fffe 	bl	0 <__aeabi_fadd>
    18b6:	f8da 205c 	ldr.w	r2, [sl, #92]	; 0x5c
    18ba:	f8d8 1024 	ldr.w	r1, [r8, #36]	; 0x24
    18be:	4683      	mov	fp, r0
    18c0:	9837      	ldr	r0, [sp, #220]	; 0xdc
    18c2:	9230      	str	r2, [sp, #192]	; 0xc0
    18c4:	f7ff fffe 	bl	0 <__aeabi_fmul>
    18c8:	4601      	mov	r1, r0
    18ca:	4658      	mov	r0, fp
    18cc:	f7ff fffe 	bl	0 <__aeabi_fadd>
    18d0:	f8da e060 	ldr.w	lr, [sl, #96]	; 0x60
    18d4:	9930      	ldr	r1, [sp, #192]	; 0xc0
    18d6:	4683      	mov	fp, r0
    18d8:	f8d8 0028 	ldr.w	r0, [r8, #40]	; 0x28
    18dc:	f8cd e0d8 	str.w	lr, [sp, #216]	; 0xd8
    18e0:	f7ff fffe 	bl	0 <__aeabi_fmul>
    18e4:	4601      	mov	r1, r0
    18e6:	4658      	mov	r0, fp
    18e8:	f7ff fffe 	bl	0 <__aeabi_fadd>
    18ec:	f8da 3064 	ldr.w	r3, [sl, #100]	; 0x64
    18f0:	9936      	ldr	r1, [sp, #216]	; 0xd8
    18f2:	4683      	mov	fp, r0
    18f4:	f8d8 002c 	ldr.w	r0, [r8, #44]	; 0x2c
    18f8:	9335      	str	r3, [sp, #212]	; 0xd4
    18fa:	f7ff fffe 	bl	0 <__aeabi_fmul>
    18fe:	4601      	mov	r1, r0
    1900:	4658      	mov	r0, fp
    1902:	f7ff fffe 	bl	0 <__aeabi_fadd>
    1906:	9935      	ldr	r1, [sp, #212]	; 0xd4
    1908:	4683      	mov	fp, r0
    190a:	f8d8 0030 	ldr.w	r0, [r8, #48]	; 0x30
    190e:	f7ff fffe 	bl	0 <__aeabi_fmul>
    1912:	4601      	mov	r1, r0
    1914:	4658      	mov	r0, fp
    1916:	f7ff fffe 	bl	0 <__aeabi_fadd>
    191a:	4601      	mov	r1, r0
    191c:	4620      	mov	r0, r4
    191e:	f7ff fffe 	bl	0 <__aeabi_fmul>
    1922:	4601      	mov	r1, r0
    1924:	9801      	ldr	r0, [sp, #4]
    1926:	f7ff fffe 	bl	0 <__aeabi_fadd>
    192a:	f509 7c9c 	add.w	ip, r9, #312	; 0x138
    192e:	4601      	mov	r1, r0
    1930:	983f      	ldr	r0, [sp, #252]	; 0xfc
    1932:	f8cd c194 	str.w	ip, [sp, #404]	; 0x194
    1936:	f7ff fffe 	bl	0 <__aeabi_fadd>
    193a:	9a3e      	ldr	r2, [sp, #248]	; 0xf8
    193c:	9965      	ldr	r1, [sp, #404]	; 0x194
    193e:	6048      	str	r0, [r1, #4]
    1940:	6190      	str	r0, [r2, #24]
    1942:	69bb      	ldr	r3, [r7, #24]
    1944:	9847      	ldr	r0, [sp, #284]	; 0x11c
    1946:	4619      	mov	r1, r3
    1948:	9303      	str	r3, [sp, #12]
    194a:	f7ff fffe 	bl	0 <__aeabi_fmul>
    194e:	6a39      	ldr	r1, [r7, #32]
    1950:	4683      	mov	fp, r0
    1952:	985f      	ldr	r0, [sp, #380]	; 0x17c
    1954:	f7ff fffe 	bl	0 <__aeabi_fmul>
    1958:	4601      	mov	r1, r0
    195a:	4658      	mov	r0, fp
    195c:	f7ff fffe 	bl	0 <__aeabi_fadd>
    1960:	6a79      	ldr	r1, [r7, #36]	; 0x24
    1962:	4683      	mov	fp, r0
    1964:	984c      	ldr	r0, [sp, #304]	; 0x130
    1966:	f7ff fffe 	bl	0 <__aeabi_fmul>
    196a:	4601      	mov	r1, r0
    196c:	4658      	mov	r0, fp
    196e:	f7ff fffe 	bl	0 <__aeabi_fadd>
    1972:	6ab9      	ldr	r1, [r7, #40]	; 0x28
    1974:	4683      	mov	fp, r0
    1976:	9854      	ldr	r0, [sp, #336]	; 0x150
    1978:	f7ff fffe 	bl	0 <__aeabi_fmul>
    197c:	4601      	mov	r1, r0
    197e:	4658      	mov	r0, fp
    1980:	f7ff fffe 	bl	0 <__aeabi_fadd>
    1984:	6af9      	ldr	r1, [r7, #44]	; 0x2c
    1986:	4683      	mov	fp, r0
    1988:	9858      	ldr	r0, [sp, #352]	; 0x160
    198a:	f7ff fffe 	bl	0 <__aeabi_fmul>
    198e:	4601      	mov	r1, r0
    1990:	4658      	mov	r0, fp
    1992:	f7ff fffe 	bl	0 <__aeabi_fadd>
    1996:	6b39      	ldr	r1, [r7, #48]	; 0x30
    1998:	4683      	mov	fp, r0
    199a:	9855      	ldr	r0, [sp, #340]	; 0x154
    199c:	f7ff fffe 	bl	0 <__aeabi_fmul>
    19a0:	4601      	mov	r1, r0
    19a2:	4658      	mov	r0, fp
    19a4:	f7ff fffe 	bl	0 <__aeabi_fadd>
    19a8:	9939      	ldr	r1, [sp, #228]	; 0xe4
    19aa:	f7ff fffe 	bl	0 <__aeabi_fmul>
    19ae:	9903      	ldr	r1, [sp, #12]
    19b0:	4602      	mov	r2, r0
    19b2:	983f      	ldr	r0, [sp, #252]	; 0xfc
    19b4:	9201      	str	r2, [sp, #4]
    19b6:	f7ff fffe 	bl	0 <__aeabi_fmul>
    19ba:	4601      	mov	r1, r0
    19bc:	9851      	ldr	r0, [sp, #324]	; 0x144
    19be:	f7ff fffe 	bl	0 <__aeabi_fadd>
    19c2:	6a39      	ldr	r1, [r7, #32]
    19c4:	4683      	mov	fp, r0
    19c6:	983d      	ldr	r0, [sp, #244]	; 0xf4
    19c8:	f7ff fffe 	bl	0 <__aeabi_fmul>
    19cc:	4601      	mov	r1, r0
    19ce:	4658      	mov	r0, fp
    19d0:	f7ff fffe 	bl	0 <__aeabi_fadd>
    19d4:	6a79      	ldr	r1, [r7, #36]	; 0x24
    19d6:	4683      	mov	fp, r0
    19d8:	9837      	ldr	r0, [sp, #220]	; 0xdc
    19da:	f7ff fffe 	bl	0 <__aeabi_fmul>
    19de:	4601      	mov	r1, r0
    19e0:	4658      	mov	r0, fp
    19e2:	f7ff fffe 	bl	0 <__aeabi_fadd>
    19e6:	6ab9      	ldr	r1, [r7, #40]	; 0x28
    19e8:	4683      	mov	fp, r0
    19ea:	9830      	ldr	r0, [sp, #192]	; 0xc0
    19ec:	f7ff fffe 	bl	0 <__aeabi_fmul>
    19f0:	4601      	mov	r1, r0
    19f2:	4658      	mov	r0, fp
    19f4:	f7ff fffe 	bl	0 <__aeabi_fadd>
    19f8:	6af9      	ldr	r1, [r7, #44]	; 0x2c
    19fa:	4683      	mov	fp, r0
    19fc:	9836      	ldr	r0, [sp, #216]	; 0xd8
    19fe:	f7ff fffe 	bl	0 <__aeabi_fmul>
    1a02:	4601      	mov	r1, r0
    1a04:	4658      	mov	r0, fp
    1a06:	f7ff fffe 	bl	0 <__aeabi_fadd>
    1a0a:	6b39      	ldr	r1, [r7, #48]	; 0x30
    1a0c:	4683      	mov	fp, r0
    1a0e:	9835      	ldr	r0, [sp, #212]	; 0xd4
    1a10:	f7ff fffe 	bl	0 <__aeabi_fmul>
    1a14:	4601      	mov	r1, r0
    1a16:	4658      	mov	r0, fp
    1a18:	f7ff fffe 	bl	0 <__aeabi_fadd>
    1a1c:	4601      	mov	r1, r0
    1a1e:	4620      	mov	r0, r4
    1a20:	f7ff fffe 	bl	0 <__aeabi_fmul>
    1a24:	4601      	mov	r1, r0
    1a26:	9801      	ldr	r0, [sp, #4]
    1a28:	f7ff fffe 	bl	0 <__aeabi_fadd>
    1a2c:	f509 73b6 	add.w	r3, r9, #364	; 0x16c
    1a30:	4601      	mov	r1, r0
    1a32:	9842      	ldr	r0, [sp, #264]	; 0x108
    1a34:	9373      	str	r3, [sp, #460]	; 0x1cc
    1a36:	f7ff fffe 	bl	0 <__aeabi_fadd>
    1a3a:	f8dd e1cc 	ldr.w	lr, [sp, #460]	; 0x1cc
    1a3e:	9a3e      	ldr	r2, [sp, #248]	; 0xf8
    1a40:	f8ce 0004 	str.w	r0, [lr, #4]
    1a44:	61d0      	str	r0, [r2, #28]
    1a46:	69b3      	ldr	r3, [r6, #24]
    1a48:	9847      	ldr	r0, [sp, #284]	; 0x11c
    1a4a:	4619      	mov	r1, r3
    1a4c:	9303      	str	r3, [sp, #12]
    1a4e:	f7ff fffe 	bl	0 <__aeabi_fmul>
    1a52:	69f1      	ldr	r1, [r6, #28]
    1a54:	4683      	mov	fp, r0
    1a56:	9851      	ldr	r0, [sp, #324]	; 0x144
    1a58:	f7ff fffe 	bl	0 <__aeabi_fmul>
    1a5c:	4601      	mov	r1, r0
    1a5e:	4658      	mov	r0, fp
    1a60:	f7ff fffe 	bl	0 <__aeabi_fadd>
    1a64:	6a71      	ldr	r1, [r6, #36]	; 0x24
    1a66:	4683      	mov	fp, r0
    1a68:	984c      	ldr	r0, [sp, #304]	; 0x130
    1a6a:	f7ff fffe 	bl	0 <__aeabi_fmul>
    1a6e:	4601      	mov	r1, r0
    1a70:	4658      	mov	r0, fp
    1a72:	f7ff fffe 	bl	0 <__aeabi_fadd>
    1a76:	6ab1      	ldr	r1, [r6, #40]	; 0x28
    1a78:	4683      	mov	fp, r0
    1a7a:	9854      	ldr	r0, [sp, #336]	; 0x150
    1a7c:	f7ff fffe 	bl	0 <__aeabi_fmul>
    1a80:	4601      	mov	r1, r0
    1a82:	4658      	mov	r0, fp
    1a84:	f7ff fffe 	bl	0 <__aeabi_fadd>
    1a88:	6af1      	ldr	r1, [r6, #44]	; 0x2c
    1a8a:	4683      	mov	fp, r0
    1a8c:	9858      	ldr	r0, [sp, #352]	; 0x160
    1a8e:	f7ff fffe 	bl	0 <__aeabi_fmul>
    1a92:	4601      	mov	r1, r0
    1a94:	4658      	mov	r0, fp
    1a96:	f7ff fffe 	bl	0 <__aeabi_fadd>
    1a9a:	6b31      	ldr	r1, [r6, #48]	; 0x30
    1a9c:	4683      	mov	fp, r0
    1a9e:	9855      	ldr	r0, [sp, #340]	; 0x154
    1aa0:	f7ff fffe 	bl	0 <__aeabi_fmul>
    1aa4:	4601      	mov	r1, r0
    1aa6:	4658      	mov	r0, fp
    1aa8:	f7ff fffe 	bl	0 <__aeabi_fadd>
    1aac:	9939      	ldr	r1, [sp, #228]	; 0xe4
    1aae:	f7ff fffe 	bl	0 <__aeabi_fmul>
    1ab2:	9903      	ldr	r1, [sp, #12]
    1ab4:	4602      	mov	r2, r0
    1ab6:	983f      	ldr	r0, [sp, #252]	; 0xfc
    1ab8:	9201      	str	r2, [sp, #4]
    1aba:	f7ff fffe 	bl	0 <__aeabi_fmul>
    1abe:	4601      	mov	r1, r0
    1ac0:	985f      	ldr	r0, [sp, #380]	; 0x17c
    1ac2:	f7ff fffe 	bl	0 <__aeabi_fadd>
    1ac6:	69f1      	ldr	r1, [r6, #28]
    1ac8:	4683      	mov	fp, r0
    1aca:	9842      	ldr	r0, [sp, #264]	; 0x108
    1acc:	f7ff fffe 	bl	0 <__aeabi_fmul>
    1ad0:	4601      	mov	r1, r0
    1ad2:	4658      	mov	r0, fp
    1ad4:	f7ff fffe 	bl	0 <__aeabi_fadd>
    1ad8:	6a71      	ldr	r1, [r6, #36]	; 0x24
    1ada:	4683      	mov	fp, r0
    1adc:	9837      	ldr	r0, [sp, #220]	; 0xdc
    1ade:	f7ff fffe 	bl	0 <__aeabi_fmul>
    1ae2:	4601      	mov	r1, r0
    1ae4:	4658      	mov	r0, fp
    1ae6:	f7ff fffe 	bl	0 <__aeabi_fadd>
    1aea:	6ab1      	ldr	r1, [r6, #40]	; 0x28
    1aec:	4683      	mov	fp, r0
    1aee:	9830      	ldr	r0, [sp, #192]	; 0xc0
    1af0:	f7ff fffe 	bl	0 <__aeabi_fmul>
    1af4:	4601      	mov	r1, r0
    1af6:	4658      	mov	r0, fp
    1af8:	f7ff fffe 	bl	0 <__aeabi_fadd>
    1afc:	6af1      	ldr	r1, [r6, #44]	; 0x2c
    1afe:	4683      	mov	fp, r0
    1b00:	9836      	ldr	r0, [sp, #216]	; 0xd8
    1b02:	f7ff fffe 	bl	0 <__aeabi_fmul>
    1b06:	4601      	mov	r1, r0
    1b08:	4658      	mov	r0, fp
    1b0a:	f7ff fffe 	bl	0 <__aeabi_fadd>
    1b0e:	6b31      	ldr	r1, [r6, #48]	; 0x30
    1b10:	4683      	mov	fp, r0
    1b12:	9835      	ldr	r0, [sp, #212]	; 0xd4
    1b14:	f7ff fffe 	bl	0 <__aeabi_fmul>
    1b18:	4601      	mov	r1, r0
    1b1a:	4658      	mov	r0, fp
    1b1c:	f7ff fffe 	bl	0 <__aeabi_fadd>
    1b20:	4601      	mov	r1, r0
    1b22:	4620      	mov	r0, r4
    1b24:	f7ff fffe 	bl	0 <__aeabi_fmul>
    1b28:	4601      	mov	r1, r0
    1b2a:	9801      	ldr	r0, [sp, #4]
    1b2c:	f7ff fffe 	bl	0 <__aeabi_fadd>
    1b30:	f509 73d0 	add.w	r3, r9, #416	; 0x1a0
    1b34:	4601      	mov	r1, r0
    1b36:	983d      	ldr	r0, [sp, #244]	; 0xf4
    1b38:	9379      	str	r3, [sp, #484]	; 0x1e4
    1b3a:	f7ff fffe 	bl	0 <__aeabi_fadd>
    1b3e:	f8dd c0f8 	ldr.w	ip, [sp, #248]	; 0xf8
    1b42:	9a79      	ldr	r2, [sp, #484]	; 0x1e4
    1b44:	6050      	str	r0, [r2, #4]
    1b46:	f8cc 0020 	str.w	r0, [ip, #32]
    1b4a:	69ab      	ldr	r3, [r5, #24]
    1b4c:	9847      	ldr	r0, [sp, #284]	; 0x11c
    1b4e:	4619      	mov	r1, r3
    1b50:	9303      	str	r3, [sp, #12]
    1b52:	f7ff fffe 	bl	0 <__aeabi_fmul>
    1b56:	69e9      	ldr	r1, [r5, #28]
    1b58:	4683      	mov	fp, r0
    1b5a:	9851      	ldr	r0, [sp, #324]	; 0x144
    1b5c:	f7ff fffe 	bl	0 <__aeabi_fmul>
    1b60:	4601      	mov	r1, r0
    1b62:	4658      	mov	r0, fp
    1b64:	f7ff fffe 	bl	0 <__aeabi_fadd>
    1b68:	6a29      	ldr	r1, [r5, #32]
    1b6a:	4683      	mov	fp, r0
    1b6c:	985f      	ldr	r0, [sp, #380]	; 0x17c
    1b6e:	f7ff fffe 	bl	0 <__aeabi_fmul>
    1b72:	4601      	mov	r1, r0
    1b74:	4658      	mov	r0, fp
    1b76:	f7ff fffe 	bl	0 <__aeabi_fadd>
    1b7a:	6aa9      	ldr	r1, [r5, #40]	; 0x28
    1b7c:	4683      	mov	fp, r0
    1b7e:	9854      	ldr	r0, [sp, #336]	; 0x150
    1b80:	f7ff fffe 	bl	0 <__aeabi_fmul>
    1b84:	4601      	mov	r1, r0
    1b86:	4658      	mov	r0, fp
    1b88:	f7ff fffe 	bl	0 <__aeabi_fadd>
    1b8c:	6ae9      	ldr	r1, [r5, #44]	; 0x2c
    1b8e:	4683      	mov	fp, r0
    1b90:	9858      	ldr	r0, [sp, #352]	; 0x160
    1b92:	f7ff fffe 	bl	0 <__aeabi_fmul>
    1b96:	4601      	mov	r1, r0
    1b98:	4658      	mov	r0, fp
    1b9a:	f7ff fffe 	bl	0 <__aeabi_fadd>
    1b9e:	6b29      	ldr	r1, [r5, #48]	; 0x30
    1ba0:	4683      	mov	fp, r0
    1ba2:	9855      	ldr	r0, [sp, #340]	; 0x154
    1ba4:	f7ff fffe 	bl	0 <__aeabi_fmul>
    1ba8:	4601      	mov	r1, r0
    1baa:	4658      	mov	r0, fp
    1bac:	f7ff fffe 	bl	0 <__aeabi_fadd>
    1bb0:	9939      	ldr	r1, [sp, #228]	; 0xe4
    1bb2:	f7ff fffe 	bl	0 <__aeabi_fmul>
    1bb6:	9903      	ldr	r1, [sp, #12]
    1bb8:	4602      	mov	r2, r0
    1bba:	983f      	ldr	r0, [sp, #252]	; 0xfc
    1bbc:	9201      	str	r2, [sp, #4]
    1bbe:	f7ff fffe 	bl	0 <__aeabi_fmul>
    1bc2:	4601      	mov	r1, r0
    1bc4:	984c      	ldr	r0, [sp, #304]	; 0x130
    1bc6:	f7ff fffe 	bl	0 <__aeabi_fadd>
    1bca:	69e9      	ldr	r1, [r5, #28]
    1bcc:	4683      	mov	fp, r0
    1bce:	9842      	ldr	r0, [sp, #264]	; 0x108
    1bd0:	f7ff fffe 	bl	0 <__aeabi_fmul>
    1bd4:	4601      	mov	r1, r0
    1bd6:	4658      	mov	r0, fp
    1bd8:	f7ff fffe 	bl	0 <__aeabi_fadd>
    1bdc:	6a29      	ldr	r1, [r5, #32]
    1bde:	4683      	mov	fp, r0
    1be0:	983d      	ldr	r0, [sp, #244]	; 0xf4
    1be2:	f7ff fffe 	bl	0 <__aeabi_fmul>
    1be6:	4601      	mov	r1, r0
    1be8:	4658      	mov	r0, fp
    1bea:	f7ff fffe 	bl	0 <__aeabi_fadd>
    1bee:	6aa9      	ldr	r1, [r5, #40]	; 0x28
    1bf0:	4683      	mov	fp, r0
    1bf2:	9830      	ldr	r0, [sp, #192]	; 0xc0
    1bf4:	f7ff fffe 	bl	0 <__aeabi_fmul>
    1bf8:	4601      	mov	r1, r0
    1bfa:	4658      	mov	r0, fp
    1bfc:	f7ff fffe 	bl	0 <__aeabi_fadd>
    1c00:	6ae9      	ldr	r1, [r5, #44]	; 0x2c
    1c02:	4683      	mov	fp, r0
    1c04:	9836      	ldr	r0, [sp, #216]	; 0xd8
    1c06:	f7ff fffe 	bl	0 <__aeabi_fmul>
    1c0a:	4601      	mov	r1, r0
    1c0c:	4658      	mov	r0, fp
    1c0e:	f7ff fffe 	bl	0 <__aeabi_fadd>
    1c12:	6b29      	ldr	r1, [r5, #48]	; 0x30
    1c14:	4683      	mov	fp, r0
    1c16:	9835      	ldr	r0, [sp, #212]	; 0xd4
    1c18:	f7ff fffe 	bl	0 <__aeabi_fmul>
    1c1c:	4601      	mov	r1, r0
    1c1e:	4658      	mov	r0, fp
    1c20:	f7ff fffe 	bl	0 <__aeabi_fadd>
    1c24:	4601      	mov	r1, r0
    1c26:	4620      	mov	r0, r4
    1c28:	f7ff fffe 	bl	0 <__aeabi_fmul>
    1c2c:	4601      	mov	r1, r0
    1c2e:	9801      	ldr	r0, [sp, #4]
    1c30:	f7ff fffe 	bl	0 <__aeabi_fadd>
    1c34:	f509 73ea 	add.w	r3, r9, #468	; 0x1d4
    1c38:	4601      	mov	r1, r0
    1c3a:	9837      	ldr	r0, [sp, #220]	; 0xdc
    1c3c:	937a      	str	r3, [sp, #488]	; 0x1e8
    1c3e:	f7ff fffe 	bl	0 <__aeabi_fadd>
    1c42:	f8dd e1e8 	ldr.w	lr, [sp, #488]	; 0x1e8
    1c46:	9a3e      	ldr	r2, [sp, #248]	; 0xf8
    1c48:	4601      	mov	r1, r0
    1c4a:	f8ce 0004 	str.w	r0, [lr, #4]
    1c4e:	6251      	str	r1, [r2, #36]	; 0x24
    1c50:	4620      	mov	r0, r4
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
    1e40:	9b34      	ldr	r3, [sp, #208]	; 0xd0
    1e42:	4601      	mov	r1, r0
    1e44:	6a5a      	ldr	r2, [r3, #36]	; 0x24
    1e46:	4658      	mov	r0, fp
    1e48:	921d      	str	r2, [sp, #116]	; 0x74
    1e4a:	f7ff fffe 	bl	0 <__aeabi_fadd>
    1e4e:	991d      	ldr	r1, [sp, #116]	; 0x74
    1e50:	4683      	mov	fp, r0
    1e52:	985c      	ldr	r0, [sp, #368]	; 0x170
    1e54:	f7ff fffe 	bl	0 <__aeabi_fmul>
    1e58:	4601      	mov	r1, r0
    1e5a:	4658      	mov	r0, fp
    1e5c:	f7ff fffe 	bl	0 <__aeabi_fadd>
    1e60:	9939      	ldr	r1, [sp, #228]	; 0xe4
    1e62:	f7ff fffe 	bl	0 <__aeabi_fmul>
    1e66:	4651      	mov	r1, sl
    1e68:	4683      	mov	fp, r0
    1e6a:	983e      	ldr	r0, [sp, #248]	; 0xf8
    1e6c:	f7ff fffe 	bl	0 <__aeabi_fmul>
    1e70:	4601      	mov	r1, r0
    1e72:	9869      	ldr	r0, [sp, #420]	; 0x1a4
    1e74:	f7ff fffe 	bl	0 <__aeabi_fadd>
    1e78:	4649      	mov	r1, r9
    1e7a:	4682      	mov	sl, r0
    1e7c:	983f      	ldr	r0, [sp, #252]	; 0xfc
    1e7e:	f7ff fffe 	bl	0 <__aeabi_fmul>
    1e82:	4601      	mov	r1, r0
    1e84:	4650      	mov	r0, sl
    1e86:	f7ff fffe 	bl	0 <__aeabi_fadd>
    1e8a:	991e      	ldr	r1, [sp, #120]	; 0x78
    1e8c:	4681      	mov	r9, r0
    1e8e:	9842      	ldr	r0, [sp, #264]	; 0x108
    1e90:	f7ff fffe 	bl	0 <__aeabi_fmul>
    1e94:	4601      	mov	r1, r0
    1e96:	4648      	mov	r0, r9
    1e98:	f7ff fffe 	bl	0 <__aeabi_fadd>
    1e9c:	991d      	ldr	r1, [sp, #116]	; 0x74
    1e9e:	4682      	mov	sl, r0
    1ea0:	983d      	ldr	r0, [sp, #244]	; 0xf4
    1ea2:	f7ff fffe 	bl	0 <__aeabi_fmul>
    1ea6:	4601      	mov	r1, r0
    1ea8:	4650      	mov	r0, sl
    1eaa:	f7ff fffe 	bl	0 <__aeabi_fadd>
    1eae:	4601      	mov	r1, r0
    1eb0:	4620      	mov	r0, r4
    1eb2:	f7ff fffe 	bl	0 <__aeabi_fmul>
    1eb6:	4601      	mov	r1, r0
    1eb8:	4658      	mov	r0, fp
    1eba:	f7ff fffe 	bl	0 <__aeabi_fadd>
    1ebe:	4601      	mov	r1, r0
    1ec0:	9843      	ldr	r0, [sp, #268]	; 0x10c
    1ec2:	f7ff fffe 	bl	0 <__aeabi_fadd>
    1ec6:	f8dd 9118 	ldr.w	r9, [sp, #280]	; 0x118
    1eca:	f8c9 0008 	str.w	r0, [r9, #8]
    1ece:	9b41      	ldr	r3, [sp, #260]	; 0x104
    1ed0:	9940      	ldr	r1, [sp, #256]	; 0x100
    1ed2:	6118      	str	r0, [r3, #16]
    1ed4:	f8d1 a018 	ldr.w	sl, [r1, #24]
    1ed8:	f8d1 901c 	ldr.w	r9, [r1, #28]
    1edc:	985b      	ldr	r0, [sp, #364]	; 0x16c
    1ede:	4651      	mov	r1, sl
    1ee0:	f7ff fffe 	bl	0 <__aeabi_fmul>
    1ee4:	4649      	mov	r1, r9
    1ee6:	4683      	mov	fp, r0
    1ee8:	9852      	ldr	r0, [sp, #328]	; 0x148
    1eea:	f7ff fffe 	bl	0 <__aeabi_fmul>
    1eee:	f8dd e100 	ldr.w	lr, [sp, #256]	; 0x100
    1ef2:	4601      	mov	r1, r0
    1ef4:	f8de c020 	ldr.w	ip, [lr, #32]
    1ef8:	4658      	mov	r0, fp
    1efa:	f8cd c070 	str.w	ip, [sp, #112]	; 0x70
    1efe:	f7ff fffe 	bl	0 <__aeabi_fadd>
    1f02:	991c      	ldr	r1, [sp, #112]	; 0x70
    1f04:	4683      	mov	fp, r0
    1f06:	9856      	ldr	r0, [sp, #344]	; 0x158
    1f08:	f7ff fffe 	bl	0 <__aeabi_fmul>
    1f0c:	9a40      	ldr	r2, [sp, #256]	; 0x100
    1f0e:	4601      	mov	r1, r0
    1f10:	6a53      	ldr	r3, [r2, #36]	; 0x24
    1f12:	4658      	mov	r0, fp
    1f14:	931b      	str	r3, [sp, #108]	; 0x6c
    1f16:	f7ff fffe 	bl	0 <__aeabi_fadd>
    1f1a:	991b      	ldr	r1, [sp, #108]	; 0x6c
    1f1c:	4683      	mov	fp, r0
    1f1e:	985c      	ldr	r0, [sp, #368]	; 0x170
    1f20:	f7ff fffe 	bl	0 <__aeabi_fmul>
    1f24:	4601      	mov	r1, r0
    1f26:	4658      	mov	r0, fp
    1f28:	f7ff fffe 	bl	0 <__aeabi_fadd>
    1f2c:	9939      	ldr	r1, [sp, #228]	; 0xe4
    1f2e:	f7ff fffe 	bl	0 <__aeabi_fmul>
    1f32:	4651      	mov	r1, sl
    1f34:	4683      	mov	fp, r0
    1f36:	983e      	ldr	r0, [sp, #248]	; 0xf8
    1f38:	f7ff fffe 	bl	0 <__aeabi_fmul>
    1f3c:	4601      	mov	r1, r0
    1f3e:	987e      	ldr	r0, [sp, #504]	; 0x1f8
    1f40:	f7ff fffe 	bl	0 <__aeabi_fadd>
    1f44:	4649      	mov	r1, r9
    1f46:	4682      	mov	sl, r0
    1f48:	983f      	ldr	r0, [sp, #252]	; 0xfc
    1f4a:	f7ff fffe 	bl	0 <__aeabi_fmul>
    1f4e:	4601      	mov	r1, r0
    1f50:	4650      	mov	r0, sl
    1f52:	f7ff fffe 	bl	0 <__aeabi_fadd>
    1f56:	991c      	ldr	r1, [sp, #112]	; 0x70
    1f58:	4682      	mov	sl, r0
    1f5a:	9842      	ldr	r0, [sp, #264]	; 0x108
    1f5c:	f7ff fffe 	bl	0 <__aeabi_fmul>
    1f60:	4601      	mov	r1, r0
    1f62:	4650      	mov	r0, sl
    1f64:	f7ff fffe 	bl	0 <__aeabi_fadd>
    1f68:	991b      	ldr	r1, [sp, #108]	; 0x6c
    1f6a:	4681      	mov	r9, r0
    1f6c:	983d      	ldr	r0, [sp, #244]	; 0xf4
    1f6e:	f7ff fffe 	bl	0 <__aeabi_fmul>
    1f72:	4601      	mov	r1, r0
    1f74:	4648      	mov	r0, r9
    1f76:	f7ff fffe 	bl	0 <__aeabi_fadd>
    1f7a:	4601      	mov	r1, r0
    1f7c:	4620      	mov	r0, r4
    1f7e:	f7ff fffe 	bl	0 <__aeabi_fmul>
    1f82:	4601      	mov	r1, r0
    1f84:	4658      	mov	r0, fp
    1f86:	f7ff fffe 	bl	0 <__aeabi_fadd>
    1f8a:	4601      	mov	r1, r0
    1f8c:	9801      	ldr	r0, [sp, #4]
    1f8e:	f7ff fffe 	bl	0 <__aeabi_fadd>
    1f92:	f8dd e15c 	ldr.w	lr, [sp, #348]	; 0x15c
    1f96:	f8ce 0008 	str.w	r0, [lr, #8]
    1f9a:	9941      	ldr	r1, [sp, #260]	; 0x104
    1f9c:	6148      	str	r0, [r1, #20]
    1f9e:	f8d8 a01c 	ldr.w	sl, [r8, #28]
    1fa2:	9852      	ldr	r0, [sp, #328]	; 0x148
    1fa4:	4651      	mov	r1, sl
    1fa6:	f7ff fffe 	bl	0 <__aeabi_fmul>
    1faa:	f8d8 9020 	ldr.w	r9, [r8, #32]
    1fae:	4683      	mov	fp, r0
    1fb0:	4649      	mov	r1, r9
    1fb2:	9856      	ldr	r0, [sp, #344]	; 0x158
    1fb4:	f7ff fffe 	bl	0 <__aeabi_fmul>
    1fb8:	4601      	mov	r1, r0
    1fba:	4658      	mov	r0, fp
    1fbc:	f7ff fffe 	bl	0 <__aeabi_fadd>
    1fc0:	9ada      	ldr	r2, [sp, #872]	; 0x368
    1fc2:	f8d8 1024 	ldr.w	r1, [r8, #36]	; 0x24
    1fc6:	4683      	mov	fp, r0
    1fc8:	985c      	ldr	r0, [sp, #368]	; 0x170
    1fca:	925d      	str	r2, [sp, #372]	; 0x174
    1fcc:	f7ff fffe 	bl	0 <__aeabi_fmul>
    1fd0:	4601      	mov	r1, r0
    1fd2:	4658      	mov	r0, fp
    1fd4:	f7ff fffe 	bl	0 <__aeabi_fadd>
    1fd8:	f8dd c36c 	ldr.w	ip, [sp, #876]	; 0x36c
    1fdc:	4683      	mov	fp, r0
    1fde:	995d      	ldr	r1, [sp, #372]	; 0x174
    1fe0:	f8d8 0028 	ldr.w	r0, [r8, #40]	; 0x28
    1fe4:	f8cd c190 	str.w	ip, [sp, #400]	; 0x190
    1fe8:	f7ff fffe 	bl	0 <__aeabi_fmul>
    1fec:	4601      	mov	r1, r0
    1fee:	4658      	mov	r0, fp
    1ff0:	f7ff fffe 	bl	0 <__aeabi_fadd>
    1ff4:	9bdc      	ldr	r3, [sp, #880]	; 0x370
    1ff6:	4683      	mov	fp, r0
    1ff8:	9964      	ldr	r1, [sp, #400]	; 0x190
    1ffa:	f8d8 002c 	ldr.w	r0, [r8, #44]	; 0x2c
    1ffe:	936d      	str	r3, [sp, #436]	; 0x1b4
    2000:	f7ff fffe 	bl	0 <__aeabi_fmul>
    2004:	4601      	mov	r1, r0
    2006:	4658      	mov	r0, fp
    2008:	f7ff fffe 	bl	0 <__aeabi_fadd>
    200c:	996d      	ldr	r1, [sp, #436]	; 0x1b4
    200e:	4683      	mov	fp, r0
    2010:	f8d8 0030 	ldr.w	r0, [r8, #48]	; 0x30
    2014:	f7ff fffe 	bl	0 <__aeabi_fmul>
    2018:	4601      	mov	r1, r0
    201a:	4658      	mov	r0, fp
    201c:	f7ff fffe 	bl	0 <__aeabi_fadd>
    2020:	9939      	ldr	r1, [sp, #228]	; 0xe4
    2022:	f7ff fffe 	bl	0 <__aeabi_fmul>
    2026:	4651      	mov	r1, sl
    2028:	4683      	mov	fp, r0
    202a:	983f      	ldr	r0, [sp, #252]	; 0xfc
    202c:	f7ff fffe 	bl	0 <__aeabi_fmul>
    2030:	4601      	mov	r1, r0
    2032:	985b      	ldr	r0, [sp, #364]	; 0x16c
    2034:	f7ff fffe 	bl	0 <__aeabi_fadd>
    2038:	4649      	mov	r1, r9
    203a:	4682      	mov	sl, r0
    203c:	9842      	ldr	r0, [sp, #264]	; 0x108
    203e:	f7ff fffe 	bl	0 <__aeabi_fmul>
    2042:	4601      	mov	r1, r0
    2044:	4650      	mov	r0, sl
    2046:	f7ff fffe 	bl	0 <__aeabi_fadd>
    204a:	9ab3      	ldr	r2, [sp, #716]	; 0x2cc
    204c:	f8d8 1024 	ldr.w	r1, [r8, #36]	; 0x24
    2050:	4682      	mov	sl, r0
    2052:	983d      	ldr	r0, [sp, #244]	; 0xf4
    2054:	9237      	str	r2, [sp, #220]	; 0xdc
    2056:	f7ff fffe 	bl	0 <__aeabi_fmul>
    205a:	4601      	mov	r1, r0
    205c:	4650      	mov	r0, sl
    205e:	f7ff fffe 	bl	0 <__aeabi_fadd>
    2062:	f8dd c2d0 	ldr.w	ip, [sp, #720]	; 0x2d0
    2066:	9937      	ldr	r1, [sp, #220]	; 0xdc
    2068:	4681      	mov	r9, r0
    206a:	f8d8 0028 	ldr.w	r0, [r8, #40]	; 0x28
    206e:	f8cd c0c0 	str.w	ip, [sp, #192]	; 0xc0
    2072:	f7ff fffe 	bl	0 <__aeabi_fmul>
    2076:	4601      	mov	r1, r0
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
