Laurenceb/Dactyl/Control/loggedosekf.asm

ekf.o:     file format elf32-littlearm


Disassembly of section .text:

00000000 <ins_get_num_states>:
       0:	200d      	movs	r0, #13
       2:	4770      	bx	lr

00000004 <INSGPSInit>:
       4:	4b3d      	ldr	r3, [pc, #244]	; (fc <INSGPSInit+0xf8>)
       6:	f04f 507e 	mov.w	r0, #1065353216	; 0x3f800000
       a:	2200      	movs	r2, #0
       c:	b530      	push	{r4, r5, lr}
       e:	2100      	movs	r1, #0
      10:	6018      	str	r0, [r3, #0]
      12:	605a      	str	r2, [r3, #4]
      14:	609a      	str	r2, [r3, #8]
      16:	4604      	mov	r4, r0
      18:	e00b      	b.n	32 <INSGPSInit+0x2e>
      1a:	4b38      	ldr	r3, [pc, #224]	; (fc <INSGPSInit+0xf8>)
      1c:	f103 050c 	add.w	r5, r3, #12
      20:	194d      	adds	r5, r1, r5
      22:	502a      	str	r2, [r5, r0]
      24:	3004      	adds	r0, #4
      26:	2834      	cmp	r0, #52	; 0x34
      28:	d1f7      	bne.n	1a <INSGPSInit+0x16>
      2a:	3134      	adds	r1, #52	; 0x34
      2c:	f5b1 7f29 	cmp.w	r1, #676	; 0x2a4
      30:	d001      	beq.n	36 <INSGPSInit+0x32>
      32:	2000      	movs	r0, #0
      34:	e7f1      	b.n	1a <INSGPSInit+0x16>
      36:	4832      	ldr	r0, [pc, #200]	; (100 <INSGPSInit+0xfc>)
      38:	f8c3 22c4 	str.w	r2, [r3, #708]	; 0x2c4
      3c:	f8c3 0124 	str.w	r0, [r3, #292]	; 0x124
      40:	f8c3 00ec 	str.w	r0, [r3, #236]	; 0xec
      44:	f8c3 00b4 	str.w	r0, [r3, #180]	; 0xb4
      48:	482e      	ldr	r0, [pc, #184]	; (104 <INSGPSInit+0x100>)
      4a:	f8c3 22c0 	str.w	r2, [r3, #704]	; 0x2c0
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
     31a:	f8d0 c000 	ldr.w	ip, [r0]
     31e:	f8c3 c000 	str.w	ip, [r3]
     322:	6841      	ldr	r1, [r0, #4]
     324:	6059      	str	r1, [r3, #4]
     326:	6882      	ldr	r2, [r0, #8]
     328:	609a      	str	r2, [r3, #8]
     32a:	4770      	bx	lr
     32c:	00000000 	andeq	r0, r0, r0

00000330 <INSSetGravity>:
     330:	4b01      	ldr	r3, [pc, #4]	; (338 <INSSetGravity+0x8>)
     332:	6018      	str	r0, [r3, #0]
     334:	4770      	bx	lr
     336:	bf00      	nop
     338:	00000000 	andeq	r0, r0, r0

0000033c <CovariancePrediction>:
     33c:	e92d 4ff0 	stmdb	sp!, {r4, r5, r6, r7, r8, r9, sl, fp, lr}
     340:	f5ad 6d88 	sub.w	sp, sp, #1088	; 0x440
     344:	b081      	sub	sp, #4
     346:	911f      	str	r1, [sp, #124]	; 0x7c
     348:	4604      	mov	r4, r0
     34a:	4619      	mov	r1, r3
     34c:	4618      	mov	r0, r3
     34e:	461e      	mov	r6, r3
     350:	9219      	str	r2, [sp, #100]	; 0x64
     352:	f7ff fffe 	bl	0 <__aeabi_fmul>
     356:	f8dd 5468 	ldr.w	r5, [sp, #1128]	; 0x468
     35a:	9013      	str	r0, [sp, #76]	; 0x4c
     35c:	4629      	mov	r1, r5
     35e:	2300      	movs	r3, #0
     360:	e010      	b.n	384 <CovariancePrediction+0x48>
     362:	200d      	movs	r0, #13
     364:	fb00 2003 	mla	r0, r0, r3, r2
     368:	f851 7022 	ldr.w	r7, [r1, r2, lsl #2]
     36c:	3201      	adds	r2, #1
     36e:	b2d2      	uxtb	r2, r2
     370:	f50d 79ce 	add.w	r9, sp, #412	; 0x19c
     374:	2a0c      	cmp	r2, #12
     376:	f849 7020 	str.w	r7, [r9, r0, lsl #2]
     37a:	d9f2      	bls.n	362 <CovariancePrediction+0x26>
     37c:	3301      	adds	r3, #1
     37e:	3134      	adds	r1, #52	; 0x34
     380:	2b0d      	cmp	r3, #13
     382:	d001      	beq.n	388 <CovariancePrediction+0x4c>
     384:	b2da      	uxtb	r2, r3
     386:	e7ec      	b.n	362 <CovariancePrediction+0x26>
     388:	f8d9 e0a8 	ldr.w	lr, [r9, #168]	; 0xa8
     38c:	9913      	ldr	r1, [sp, #76]	; 0x4c
     38e:	4670      	mov	r0, lr
     390:	f8d9 700c 	ldr.w	r7, [r9, #12]
     394:	f8cd e004 	str.w	lr, [sp, #4]
     398:	f7ff fffe 	bl	0 <__aeabi_fmul>
     39c:	4639      	mov	r1, r7
     39e:	4680      	mov	r8, r0
     3a0:	4638      	mov	r0, r7
     3a2:	f7ff fffe 	bl	0 <__aeabi_fadd>
     3a6:	4631      	mov	r1, r6
     3a8:	f7ff fffe 	bl	0 <__aeabi_fmul>
     3ac:	4601      	mov	r1, r0
     3ae:	4640      	mov	r0, r8
     3b0:	f7ff fffe 	bl	0 <__aeabi_fadd>
     3b4:	f8d9 1000 	ldr.w	r1, [r9]
     3b8:	f7ff fffe 	bl	0 <__aeabi_fadd>
     3bc:	462b      	mov	r3, r5
     3be:	f843 0b34 	str.w	r0, [r3], #52
     3c2:	f8d9 2040 	ldr.w	r2, [r9, #64]	; 0x40
     3c6:	f8d9 00ac 	ldr.w	r0, [r9, #172]	; 0xac
     3ca:	9913      	ldr	r1, [sp, #76]	; 0x4c
     3cc:	931d      	str	r3, [sp, #116]	; 0x74
     3ce:	9217      	str	r2, [sp, #92]	; 0x5c
     3d0:	9040      	str	r0, [sp, #256]	; 0x100
     3d2:	f7ff fffe 	bl	0 <__aeabi_fmul>
     3d6:	9917      	ldr	r1, [sp, #92]	; 0x5c
     3d8:	4683      	mov	fp, r0
     3da:	f8d9 0010 	ldr.w	r0, [r9, #16]
     3de:	f7ff fffe 	bl	0 <__aeabi_fadd>
     3e2:	4631      	mov	r1, r6
     3e4:	f7ff fffe 	bl	0 <__aeabi_fmul>
     3e8:	4601      	mov	r1, r0
     3ea:	4658      	mov	r0, fp
     3ec:	f7ff fffe 	bl	0 <__aeabi_fadd>
     3f0:	f8d9 1004 	ldr.w	r1, [r9, #4]
     3f4:	f7ff fffe 	bl	0 <__aeabi_fadd>
     3f8:	6368      	str	r0, [r5, #52]	; 0x34
     3fa:	6068      	str	r0, [r5, #4]
     3fc:	f8d9 c0b0 	ldr.w	ip, [r9, #176]	; 0xb0
     400:	f8d9 a074 	ldr.w	sl, [r9, #116]	; 0x74
     404:	f105 0168 	add.w	r1, r5, #104	; 0x68
     408:	4660      	mov	r0, ip
     40a:	912e      	str	r1, [sp, #184]	; 0xb8
     40c:	9913      	ldr	r1, [sp, #76]	; 0x4c
     40e:	f8cd c110 	str.w	ip, [sp, #272]	; 0x110
     412:	f8cd a0cc 	str.w	sl, [sp, #204]	; 0xcc
     416:	f7ff fffe 	bl	0 <__aeabi_fmul>
     41a:	9933      	ldr	r1, [sp, #204]	; 0xcc
     41c:	4680      	mov	r8, r0
     41e:	f8d9 0014 	ldr.w	r0, [r9, #20]
     422:	f7ff fffe 	bl	0 <__aeabi_fadd>
     426:	4631      	mov	r1, r6
     428:	f7ff fffe 	bl	0 <__aeabi_fmul>
     42c:	4601      	mov	r1, r0
     42e:	4640      	mov	r0, r8
     430:	f7ff fffe 	bl	0 <__aeabi_fadd>
     434:	f8d9 1008 	ldr.w	r1, [r9, #8]
     438:	f7ff fffe 	bl	0 <__aeabi_fadd>
     43c:	f105 039c 	add.w	r3, r5, #156	; 0x9c
     440:	f104 089c 	add.w	r8, r4, #156	; 0x9c
     444:	66a8      	str	r0, [r5, #104]	; 0x68
     446:	60a8      	str	r0, [r5, #8]
     448:	9325      	str	r3, [sp, #148]	; 0x94
     44a:	f8d9 20b4 	ldr.w	r2, [r9, #180]	; 0xb4
     44e:	f8d8 a018 	ldr.w	sl, [r8, #24]
     452:	f8d9 00b8 	ldr.w	r0, [r9, #184]	; 0xb8
     456:	f8d9 10bc 	ldr.w	r1, [r9, #188]	; 0xbc
     45a:	f8d9 30c0 	ldr.w	r3, [r9, #192]	; 0xc0
     45e:	922b      	str	r2, [sp, #172]	; 0xac
     460:	9021      	str	r0, [sp, #132]	; 0x84
     462:	912d      	str	r1, [sp, #180]	; 0xb4
     464:	4650      	mov	r0, sl
     466:	992b      	ldr	r1, [sp, #172]	; 0xac
     468:	9312      	str	r3, [sp, #72]	; 0x48
     46a:	f7ff fffe 	bl	0 <__aeabi_fmul>
     46e:	9921      	ldr	r1, [sp, #132]	; 0x84
     470:	4683      	mov	fp, r0
     472:	f8d8 001c 	ldr.w	r0, [r8, #28]
     476:	f7ff fffe 	bl	0 <__aeabi_fmul>
     47a:	4601      	mov	r1, r0
     47c:	4658      	mov	r0, fp
     47e:	f7ff fffe 	bl	0 <__aeabi_fadd>
     482:	992d      	ldr	r1, [sp, #180]	; 0xb4
     484:	4683      	mov	fp, r0
     486:	f8d8 0020 	ldr.w	r0, [r8, #32]
     48a:	f7ff fffe 	bl	0 <__aeabi_fmul>
     48e:	4601      	mov	r1, r0
     490:	4658      	mov	r0, fp
     492:	f7ff fffe 	bl	0 <__aeabi_fadd>
     496:	9912      	ldr	r1, [sp, #72]	; 0x48
     498:	4683      	mov	fp, r0
     49a:	f8d8 0024 	ldr.w	r0, [r8, #36]	; 0x24
     49e:	f7ff fffe 	bl	0 <__aeabi_fmul>
     4a2:	4601      	mov	r1, r0
     4a4:	4658      	mov	r0, fp
     4a6:	f7ff fffe 	bl	0 <__aeabi_fadd>
     4aa:	9913      	ldr	r1, [sp, #76]	; 0x4c
     4ac:	f7ff fffe 	bl	0 <__aeabi_fmul>
     4b0:	f8d9 1018 	ldr.w	r1, [r9, #24]
     4b4:	4683      	mov	fp, r0
     4b6:	4650      	mov	r0, sl
     4b8:	f7ff fffe 	bl	0 <__aeabi_fmul>
     4bc:	f8dd c004 	ldr.w	ip, [sp, #4]
     4c0:	4601      	mov	r1, r0
     4c2:	4660      	mov	r0, ip
     4c4:	f7ff fffe 	bl	0 <__aeabi_fadd>
     4c8:	f8d9 101c 	ldr.w	r1, [r9, #28]
     4cc:	4682      	mov	sl, r0
     4ce:	f8d8 001c 	ldr.w	r0, [r8, #28]
     4d2:	f7ff fffe 	bl	0 <__aeabi_fmul>
     4d6:	4601      	mov	r1, r0
     4d8:	4650      	mov	r0, sl
     4da:	f7ff fffe 	bl	0 <__aeabi_fadd>
     4de:	f8d9 1020 	ldr.w	r1, [r9, #32]
     4e2:	4682      	mov	sl, r0
     4e4:	f8d8 0020 	ldr.w	r0, [r8, #32]
     4e8:	f7ff fffe 	bl	0 <__aeabi_fmul>
     4ec:	4601      	mov	r1, r0
     4ee:	4650      	mov	r0, sl
     4f0:	f7ff fffe 	bl	0 <__aeabi_fadd>
     4f4:	f8d9 1024 	ldr.w	r1, [r9, #36]	; 0x24
     4f8:	4682      	mov	sl, r0
     4fa:	f8d8 0024 	ldr.w	r0, [r8, #36]	; 0x24
     4fe:	f7ff fffe 	bl	0 <__aeabi_fmul>
     502:	4601      	mov	r1, r0
     504:	4650      	mov	r0, sl
     506:	f7ff fffe 	bl	0 <__aeabi_fadd>
     50a:	4631      	mov	r1, r6
     50c:	f7ff fffe 	bl	0 <__aeabi_fmul>
     510:	4601      	mov	r1, r0
     512:	4658      	mov	r0, fp
     514:	f7ff fffe 	bl	0 <__aeabi_fadd>
     518:	4639      	mov	r1, r7
     51a:	f7ff fffe 	bl	0 <__aeabi_fadd>
     51e:	f105 07d0 	add.w	r7, r5, #208	; 0xd0
     522:	f8c5 009c 	str.w	r0, [r5, #156]	; 0x9c
     526:	60e8      	str	r0, [r5, #12]
     528:	9730      	str	r7, [sp, #192]	; 0xc0
     52a:	f104 07d0 	add.w	r7, r4, #208	; 0xd0
     52e:	f8d7 a018 	ldr.w	sl, [r7, #24]
     532:	992b      	ldr	r1, [sp, #172]	; 0xac
     534:	4650      	mov	r0, sl
     536:	f7ff fffe 	bl	0 <__aeabi_fmul>
     53a:	9921      	ldr	r1, [sp, #132]	; 0x84
     53c:	4683      	mov	fp, r0
     53e:	69f8      	ldr	r0, [r7, #28]
     540:	f7ff fffe 	bl	0 <__aeabi_fmul>
     544:	4601      	mov	r1, r0
     546:	4658      	mov	r0, fp
     548:	f7ff fffe 	bl	0 <__aeabi_fadd>
     54c:	992d      	ldr	r1, [sp, #180]	; 0xb4
     54e:	4683      	mov	fp, r0
     550:	6a38      	ldr	r0, [r7, #32]
     552:	f7ff fffe 	bl	0 <__aeabi_fmul>
     556:	4601      	mov	r1, r0
     558:	4658      	mov	r0, fp
     55a:	f7ff fffe 	bl	0 <__aeabi_fadd>
     55e:	9912      	ldr	r1, [sp, #72]	; 0x48
     560:	4683      	mov	fp, r0
     562:	6a78      	ldr	r0, [r7, #36]	; 0x24
     564:	f7ff fffe 	bl	0 <__aeabi_fmul>
     568:	4601      	mov	r1, r0
     56a:	4658      	mov	r0, fp
     56c:	f7ff fffe 	bl	0 <__aeabi_fadd>
     570:	9913      	ldr	r1, [sp, #76]	; 0x4c
     572:	f7ff fffe 	bl	0 <__aeabi_fmul>
     576:	f8d9 1018 	ldr.w	r1, [r9, #24]
     57a:	4683      	mov	fp, r0
     57c:	4650      	mov	r0, sl
     57e:	f7ff fffe 	bl	0 <__aeabi_fmul>
     582:	4601      	mov	r1, r0
     584:	9840      	ldr	r0, [sp, #256]	; 0x100
     586:	f7ff fffe 	bl	0 <__aeabi_fadd>
     58a:	f8d9 101c 	ldr.w	r1, [r9, #28]
     58e:	4682      	mov	sl, r0
     590:	69f8      	ldr	r0, [r7, #28]
     592:	f7ff fffe 	bl	0 <__aeabi_fmul>
     596:	4601      	mov	r1, r0
     598:	4650      	mov	r0, sl
     59a:	f7ff fffe 	bl	0 <__aeabi_fadd>
     59e:	f8d9 1020 	ldr.w	r1, [r9, #32]
     5a2:	4682      	mov	sl, r0
     5a4:	6a38      	ldr	r0, [r7, #32]
     5a6:	f7ff fffe 	bl	0 <__aeabi_fmul>
     5aa:	4601      	mov	r1, r0
     5ac:	4650      	mov	r0, sl
     5ae:	f7ff fffe 	bl	0 <__aeabi_fadd>
     5b2:	f8d9 1024 	ldr.w	r1, [r9, #36]	; 0x24
     5b6:	4682      	mov	sl, r0
     5b8:	6a78      	ldr	r0, [r7, #36]	; 0x24
     5ba:	f7ff fffe 	bl	0 <__aeabi_fmul>
     5be:	4601      	mov	r1, r0
     5c0:	4650      	mov	r0, sl
     5c2:	f7ff fffe 	bl	0 <__aeabi_fadd>
     5c6:	4631      	mov	r1, r6
     5c8:	f7ff fffe 	bl	0 <__aeabi_fmul>
     5cc:	4601      	mov	r1, r0
     5ce:	4658      	mov	r0, fp
     5d0:	f7ff fffe 	bl	0 <__aeabi_fadd>
     5d4:	f8d9 1010 	ldr.w	r1, [r9, #16]
     5d8:	f7ff fffe 	bl	0 <__aeabi_fadd>
     5dc:	f8c5 00d0 	str.w	r0, [r5, #208]	; 0xd0
     5e0:	6128      	str	r0, [r5, #16]
     5e2:	f8d4 a11c 	ldr.w	sl, [r4, #284]	; 0x11c
     5e6:	992b      	ldr	r1, [sp, #172]	; 0xac
     5e8:	4650      	mov	r0, sl
     5ea:	f7ff fffe 	bl	0 <__aeabi_fmul>
     5ee:	9921      	ldr	r1, [sp, #132]	; 0x84
     5f0:	4683      	mov	fp, r0
     5f2:	f8d4 0120 	ldr.w	r0, [r4, #288]	; 0x120
     5f6:	f7ff fffe 	bl	0 <__aeabi_fmul>
     5fa:	4601      	mov	r1, r0
     5fc:	4658      	mov	r0, fp
     5fe:	f7ff fffe 	bl	0 <__aeabi_fadd>
     602:	992d      	ldr	r1, [sp, #180]	; 0xb4
     604:	4683      	mov	fp, r0
     606:	f8d4 0124 	ldr.w	r0, [r4, #292]	; 0x124
     60a:	f7ff fffe 	bl	0 <__aeabi_fmul>
     60e:	4601      	mov	r1, r0
     610:	4658      	mov	r0, fp
     612:	f7ff fffe 	bl	0 <__aeabi_fadd>
     616:	9912      	ldr	r1, [sp, #72]	; 0x48
     618:	4683      	mov	fp, r0
     61a:	f8d4 0128 	ldr.w	r0, [r4, #296]	; 0x128
     61e:	f7ff fffe 	bl	0 <__aeabi_fmul>
     622:	4601      	mov	r1, r0
     624:	4658      	mov	r0, fp
     626:	f7ff fffe 	bl	0 <__aeabi_fadd>
     62a:	9913      	ldr	r1, [sp, #76]	; 0x4c
     62c:	f7ff fffe 	bl	0 <__aeabi_fmul>
     630:	f8d9 1018 	ldr.w	r1, [r9, #24]
     634:	4683      	mov	fp, r0
     636:	4650      	mov	r0, sl
     638:	f7ff fffe 	bl	0 <__aeabi_fmul>
     63c:	4601      	mov	r1, r0
     63e:	9844      	ldr	r0, [sp, #272]	; 0x110
     640:	f7ff fffe 	bl	0 <__aeabi_fadd>
     644:	f8d9 101c 	ldr.w	r1, [r9, #28]
     648:	4682      	mov	sl, r0
     64a:	f8d4 0120 	ldr.w	r0, [r4, #288]	; 0x120
     64e:	f7ff fffe 	bl	0 <__aeabi_fmul>
     652:	4601      	mov	r1, r0
     654:	4650      	mov	r0, sl
     656:	f7ff fffe 	bl	0 <__aeabi_fadd>
     65a:	f8d9 1020 	ldr.w	r1, [r9, #32]
     65e:	4682      	mov	sl, r0
     660:	f8d4 0124 	ldr.w	r0, [r4, #292]	; 0x124
     664:	f7ff fffe 	bl	0 <__aeabi_fmul>
     668:	4601      	mov	r1, r0
     66a:	4650      	mov	r0, sl
     66c:	f7ff fffe 	bl	0 <__aeabi_fadd>
     670:	f8d9 1024 	ldr.w	r1, [r9, #36]	; 0x24
     674:	4682      	mov	sl, r0
     676:	f8d4 0128 	ldr.w	r0, [r4, #296]	; 0x128
     67a:	f7ff fffe 	bl	0 <__aeabi_fmul>
     67e:	4601      	mov	r1, r0
     680:	4650      	mov	r0, sl
     682:	f7ff fffe 	bl	0 <__aeabi_fadd>
     686:	4631      	mov	r1, r6
     688:	f7ff fffe 	bl	0 <__aeabi_fmul>
     68c:	4601      	mov	r1, r0
     68e:	4658      	mov	r0, fp
     690:	f7ff fffe 	bl	0 <__aeabi_fadd>
     694:	f8d9 1014 	ldr.w	r1, [r9, #20]
     698:	f7ff fffe 	bl	0 <__aeabi_fadd>
     69c:	f8c5 0104 	str.w	r0, [r5, #260]	; 0x104
     6a0:	6168      	str	r0, [r5, #20]
     6a2:	f8d4 a154 	ldr.w	sl, [r4, #340]	; 0x154
     6a6:	f8d9 00cc 	ldr.w	r0, [r9, #204]	; 0xcc
     6aa:	f8d9 20c4 	ldr.w	r2, [r9, #196]	; 0xc4
     6ae:	f8d9 c0c8 	ldr.w	ip, [r9, #200]	; 0xc8
     6b2:	9921      	ldr	r1, [sp, #132]	; 0x84
     6b4:	9028      	str	r0, [sp, #160]	; 0xa0
     6b6:	4650      	mov	r0, sl
     6b8:	9227      	str	r2, [sp, #156]	; 0x9c
     6ba:	f8cd c06c 	str.w	ip, [sp, #108]	; 0x6c
     6be:	f7ff fffe 	bl	0 <__aeabi_fmul>
     6c2:	992d      	ldr	r1, [sp, #180]	; 0xb4
     6c4:	4683      	mov	fp, r0
     6c6:	f8d4 0158 	ldr.w	r0, [r4, #344]	; 0x158
     6ca:	f7ff fffe 	bl	0 <__aeabi_fmul>
     6ce:	4601      	mov	r1, r0
     6d0:	4658      	mov	r0, fp
     6d2:	f7ff fffe 	bl	0 <__aeabi_fadd>
     6d6:	9912      	ldr	r1, [sp, #72]	; 0x48
     6d8:	4683      	mov	fp, r0
     6da:	f8d4 015c 	ldr.w	r0, [r4, #348]	; 0x15c
     6de:	f7ff fffe 	bl	0 <__aeabi_fmul>
     6e2:	4601      	mov	r1, r0
     6e4:	4658      	mov	r0, fp
     6e6:	f7ff fffe 	bl	0 <__aeabi_fadd>
     6ea:	9927      	ldr	r1, [sp, #156]	; 0x9c
     6ec:	4683      	mov	fp, r0
     6ee:	f8d4 0160 	ldr.w	r0, [r4, #352]	; 0x160
     6f2:	f7ff fffe 	bl	0 <__aeabi_fmul>
     6f6:	4601      	mov	r1, r0
     6f8:	4658      	mov	r0, fp
     6fa:	f7ff fffe 	bl	0 <__aeabi_fadd>
     6fe:	991b      	ldr	r1, [sp, #108]	; 0x6c
     700:	4683      	mov	fp, r0
     702:	f8d4 0164 	ldr.w	r0, [r4, #356]	; 0x164
     706:	f7ff fffe 	bl	0 <__aeabi_fmul>
     70a:	4601      	mov	r1, r0
     70c:	4658      	mov	r0, fp
     70e:	f7ff fffe 	bl	0 <__aeabi_fadd>
     712:	9928      	ldr	r1, [sp, #160]	; 0xa0
     714:	4683      	mov	fp, r0
     716:	f8d4 0168 	ldr.w	r0, [r4, #360]	; 0x168
     71a:	f7ff fffe 	bl	0 <__aeabi_fmul>
     71e:	4601      	mov	r1, r0
     720:	4658      	mov	r0, fp
     722:	f7ff fffe 	bl	0 <__aeabi_fadd>
     726:	9913      	ldr	r1, [sp, #76]	; 0x4c
     728:	f7ff fffe 	bl	0 <__aeabi_fmul>
     72c:	f8d9 101c 	ldr.w	r1, [r9, #28]
     730:	4683      	mov	fp, r0
     732:	4650      	mov	r0, sl
     734:	f7ff fffe 	bl	0 <__aeabi_fmul>
     738:	4601      	mov	r1, r0
     73a:	982b      	ldr	r0, [sp, #172]	; 0xac
     73c:	f7ff fffe 	bl	0 <__aeabi_fadd>
     740:	f8d9 1020 	ldr.w	r1, [r9, #32]
     744:	4682      	mov	sl, r0
     746:	f8d4 0158 	ldr.w	r0, [r4, #344]	; 0x158
     74a:	f7ff fffe 	bl	0 <__aeabi_fmul>
     74e:	4601      	mov	r1, r0
     750:	4650      	mov	r0, sl
     752:	f7ff fffe 	bl	0 <__aeabi_fadd>
     756:	f8d9 1024 	ldr.w	r1, [r9, #36]	; 0x24
     75a:	4682      	mov	sl, r0
     75c:	f8d4 015c 	ldr.w	r0, [r4, #348]	; 0x15c
     760:	f7ff fffe 	bl	0 <__aeabi_fmul>
     764:	4601      	mov	r1, r0
     766:	4650      	mov	r0, sl
     768:	f7ff fffe 	bl	0 <__aeabi_fadd>
     76c:	f8d9 1028 	ldr.w	r1, [r9, #40]	; 0x28
     770:	4682      	mov	sl, r0
     772:	f8d4 0160 	ldr.w	r0, [r4, #352]	; 0x160
     776:	f7ff fffe 	bl	0 <__aeabi_fmul>
     77a:	4601      	mov	r1, r0
     77c:	4650      	mov	r0, sl
     77e:	f7ff fffe 	bl	0 <__aeabi_fadd>
     782:	f8d9 102c 	ldr.w	r1, [r9, #44]	; 0x2c
     786:	4682      	mov	sl, r0
     788:	f8d4 0164 	ldr.w	r0, [r4, #356]	; 0x164
     78c:	f7ff fffe 	bl	0 <__aeabi_fmul>
     790:	4601      	mov	r1, r0
     792:	4650      	mov	r0, sl
     794:	f7ff fffe 	bl	0 <__aeabi_fadd>
     798:	f8d9 1030 	ldr.w	r1, [r9, #48]	; 0x30
     79c:	4682      	mov	sl, r0
     79e:	f8d4 0168 	ldr.w	r0, [r4, #360]	; 0x168
     7a2:	f7ff fffe 	bl	0 <__aeabi_fmul>
     7a6:	4601      	mov	r1, r0
     7a8:	4650      	mov	r0, sl
     7aa:	f7ff fffe 	bl	0 <__aeabi_fadd>
     7ae:	4631      	mov	r1, r6
     7b0:	f7ff fffe 	bl	0 <__aeabi_fmul>
     7b4:	4601      	mov	r1, r0
     7b6:	4658      	mov	r0, fp
     7b8:	f7ff fffe 	bl	0 <__aeabi_fadd>
     7bc:	f8d9 1018 	ldr.w	r1, [r9, #24]
     7c0:	f7ff fffe 	bl	0 <__aeabi_fadd>
     7c4:	f8c5 0138 	str.w	r0, [r5, #312]	; 0x138
     7c8:	61a8      	str	r0, [r5, #24]
     7ca:	f8d4 a184 	ldr.w	sl, [r4, #388]	; 0x184
     7ce:	992b      	ldr	r1, [sp, #172]	; 0xac
     7d0:	4650      	mov	r0, sl
     7d2:	f7ff fffe 	bl	0 <__aeabi_fmul>
     7d6:	992d      	ldr	r1, [sp, #180]	; 0xb4
     7d8:	4683      	mov	fp, r0
     7da:	f8d4 018c 	ldr.w	r0, [r4, #396]	; 0x18c
     7de:	f7ff fffe 	bl	0 <__aeabi_fmul>
     7e2:	4601      	mov	r1, r0
     7e4:	4658      	mov	r0, fp
     7e6:	f7ff fffe 	bl	0 <__aeabi_fadd>
     7ea:	9912      	ldr	r1, [sp, #72]	; 0x48
     7ec:	4683      	mov	fp, r0
     7ee:	f8d4 0190 	ldr.w	r0, [r4, #400]	; 0x190
     7f2:	f7ff fffe 	bl	0 <__aeabi_fmul>
     7f6:	4601      	mov	r1, r0
     7f8:	4658      	mov	r0, fp
     7fa:	f7ff fffe 	bl	0 <__aeabi_fadd>
     7fe:	9927      	ldr	r1, [sp, #156]	; 0x9c
     800:	4683      	mov	fp, r0
     802:	f8d4 0194 	ldr.w	r0, [r4, #404]	; 0x194
     806:	f7ff fffe 	bl	0 <__aeabi_fmul>
     80a:	4601      	mov	r1, r0
     80c:	4658      	mov	r0, fp
     80e:	f7ff fffe 	bl	0 <__aeabi_fadd>
     812:	991b      	ldr	r1, [sp, #108]	; 0x6c
     814:	4683      	mov	fp, r0
     816:	f8d4 0198 	ldr.w	r0, [r4, #408]	; 0x198
     81a:	f7ff fffe 	bl	0 <__aeabi_fmul>
     81e:	4601      	mov	r1, r0
     820:	4658      	mov	r0, fp
     822:	f7ff fffe 	bl	0 <__aeabi_fadd>
     826:	9928      	ldr	r1, [sp, #160]	; 0xa0
     828:	4683      	mov	fp, r0
     82a:	f8d4 019c 	ldr.w	r0, [r4, #412]	; 0x19c
     82e:	f7ff fffe 	bl	0 <__aeabi_fmul>
     832:	4601      	mov	r1, r0
     834:	4658      	mov	r0, fp
     836:	f7ff fffe 	bl	0 <__aeabi_fadd>
     83a:	9913      	ldr	r1, [sp, #76]	; 0x4c
     83c:	f7ff fffe 	bl	0 <__aeabi_fmul>
     840:	f8d9 1018 	ldr.w	r1, [r9, #24]
     844:	4683      	mov	fp, r0
     846:	4650      	mov	r0, sl
     848:	f7ff fffe 	bl	0 <__aeabi_fmul>
     84c:	4601      	mov	r1, r0
     84e:	9821      	ldr	r0, [sp, #132]	; 0x84
     850:	f7ff fffe 	bl	0 <__aeabi_fadd>
     854:	f8d9 1020 	ldr.w	r1, [r9, #32]
     858:	4682      	mov	sl, r0
     85a:	f8d4 018c 	ldr.w	r0, [r4, #396]	; 0x18c
     85e:	f7ff fffe 	bl	0 <__aeabi_fmul>
     862:	4601      	mov	r1, r0
     864:	4650      	mov	r0, sl
     866:	f7ff fffe 	bl	0 <__aeabi_fadd>
     86a:	f8d9 1024 	ldr.w	r1, [r9, #36]	; 0x24
     86e:	4682      	mov	sl, r0
     870:	f8d4 0190 	ldr.w	r0, [r4, #400]	; 0x190
     874:	f7ff fffe 	bl	0 <__aeabi_fmul>
     878:	4601      	mov	r1, r0
     87a:	4650      	mov	r0, sl
     87c:	f7ff fffe 	bl	0 <__aeabi_fadd>
     880:	f8d9 1028 	ldr.w	r1, [r9, #40]	; 0x28
     884:	4682      	mov	sl, r0
     886:	f8d4 0194 	ldr.w	r0, [r4, #404]	; 0x194
     88a:	f7ff fffe 	bl	0 <__aeabi_fmul>
     88e:	4601      	mov	r1, r0
     890:	4650      	mov	r0, sl
     892:	f7ff fffe 	bl	0 <__aeabi_fadd>
     896:	f8d9 102c 	ldr.w	r1, [r9, #44]	; 0x2c
     89a:	4682      	mov	sl, r0
     89c:	f8d4 0198 	ldr.w	r0, [r4, #408]	; 0x198
     8a0:	f7ff fffe 	bl	0 <__aeabi_fmul>
     8a4:	4601      	mov	r1, r0
     8a6:	4650      	mov	r0, sl
     8a8:	f7ff fffe 	bl	0 <__aeabi_fadd>
     8ac:	f8d9 1030 	ldr.w	r1, [r9, #48]	; 0x30
     8b0:	4682      	mov	sl, r0
     8b2:	f8d4 019c 	ldr.w	r0, [r4, #412]	; 0x19c
     8b6:	f7ff fffe 	bl	0 <__aeabi_fmul>
     8ba:	4601      	mov	r1, r0
     8bc:	4650      	mov	r0, sl
     8be:	f7ff fffe 	bl	0 <__aeabi_fadd>
     8c2:	4631      	mov	r1, r6
     8c4:	f7ff fffe 	bl	0 <__aeabi_fmul>
     8c8:	4601      	mov	r1, r0
     8ca:	4658      	mov	r0, fp
     8cc:	f7ff fffe 	bl	0 <__aeabi_fadd>
     8d0:	f8d9 101c 	ldr.w	r1, [r9, #28]
     8d4:	f7ff fffe 	bl	0 <__aeabi_fadd>
     8d8:	f8c5 016c 	str.w	r0, [r5, #364]	; 0x16c
     8dc:	61e8      	str	r0, [r5, #28]
     8de:	f8d4 a1b8 	ldr.w	sl, [r4, #440]	; 0x1b8
     8e2:	992b      	ldr	r1, [sp, #172]	; 0xac
     8e4:	4650      	mov	r0, sl
     8e6:	f7ff fffe 	bl	0 <__aeabi_fmul>
     8ea:	9921      	ldr	r1, [sp, #132]	; 0x84
     8ec:	4683      	mov	fp, r0
     8ee:	f8d4 01bc 	ldr.w	r0, [r4, #444]	; 0x1bc
     8f2:	f7ff fffe 	bl	0 <__aeabi_fmul>
     8f6:	4601      	mov	r1, r0
     8f8:	4658      	mov	r0, fp
     8fa:	f7ff fffe 	bl	0 <__aeabi_fadd>
     8fe:	9912      	ldr	r1, [sp, #72]	; 0x48
     900:	4683      	mov	fp, r0
     902:	f8d4 01c4 	ldr.w	r0, [r4, #452]	; 0x1c4
     906:	f7ff fffe 	bl	0 <__aeabi_fmul>
     90a:	4601      	mov	r1, r0
     90c:	4658      	mov	r0, fp
     90e:	f7ff fffe 	bl	0 <__aeabi_fadd>
     912:	9927      	ldr	r1, [sp, #156]	; 0x9c
     914:	4683      	mov	fp, r0
     916:	f8d4 01c8 	ldr.w	r0, [r4, #456]	; 0x1c8
     91a:	f7ff fffe 	bl	0 <__aeabi_fmul>
     91e:	4601      	mov	r1, r0
     920:	4658      	mov	r0, fp
     922:	f7ff fffe 	bl	0 <__aeabi_fadd>
     926:	991b      	ldr	r1, [sp, #108]	; 0x6c
     928:	4683      	mov	fp, r0
     92a:	f8d4 01cc 	ldr.w	r0, [r4, #460]	; 0x1cc
     92e:	f7ff fffe 	bl	0 <__aeabi_fmul>
     932:	4601      	mov	r1, r0
     934:	4658      	mov	r0, fp
     936:	f7ff fffe 	bl	0 <__aeabi_fadd>
     93a:	9928      	ldr	r1, [sp, #160]	; 0xa0
     93c:	4683      	mov	fp, r0
     93e:	f8d4 01d0 	ldr.w	r0, [r4, #464]	; 0x1d0
     942:	f7ff fffe 	bl	0 <__aeabi_fmul>
     946:	4601      	mov	r1, r0
     948:	4658      	mov	r0, fp
     94a:	f7ff fffe 	bl	0 <__aeabi_fadd>
     94e:	9913      	ldr	r1, [sp, #76]	; 0x4c
     950:	f7ff fffe 	bl	0 <__aeabi_fmul>
     954:	f8d9 1018 	ldr.w	r1, [r9, #24]
     958:	4683      	mov	fp, r0
     95a:	4650      	mov	r0, sl
     95c:	f7ff fffe 	bl	0 <__aeabi_fmul>
     960:	4601      	mov	r1, r0
     962:	982d      	ldr	r0, [sp, #180]	; 0xb4
     964:	f7ff fffe 	bl	0 <__aeabi_fadd>
     968:	f8d9 101c 	ldr.w	r1, [r9, #28]
     96c:	4682      	mov	sl, r0
     96e:	f8d4 01bc 	ldr.w	r0, [r4, #444]	; 0x1bc
     972:	f7ff fffe 	bl	0 <__aeabi_fmul>
     976:	4601      	mov	r1, r0
     978:	4650      	mov	r0, sl
     97a:	f7ff fffe 	bl	0 <__aeabi_fadd>
     97e:	f8d9 1024 	ldr.w	r1, [r9, #36]	; 0x24
     982:	4682      	mov	sl, r0
     984:	f8d4 01c4 	ldr.w	r0, [r4, #452]	; 0x1c4
     988:	f7ff fffe 	bl	0 <__aeabi_fmul>
     98c:	4601      	mov	r1, r0
     98e:	4650      	mov	r0, sl
     990:	f7ff fffe 	bl	0 <__aeabi_fadd>
     994:	f8d9 1028 	ldr.w	r1, [r9, #40]	; 0x28
     998:	4682      	mov	sl, r0
     99a:	f8d4 01c8 	ldr.w	r0, [r4, #456]	; 0x1c8
     99e:	f7ff fffe 	bl	0 <__aeabi_fmul>
     9a2:	4601      	mov	r1, r0
     9a4:	4650      	mov	r0, sl
     9a6:	f7ff fffe 	bl	0 <__aeabi_fadd>
     9aa:	f8d9 102c 	ldr.w	r1, [r9, #44]	; 0x2c
     9ae:	4682      	mov	sl, r0
     9b0:	f8d4 01cc 	ldr.w	r0, [r4, #460]	; 0x1cc
     9b4:	f7ff fffe 	bl	0 <__aeabi_fmul>
     9b8:	4601      	mov	r1, r0
     9ba:	4650      	mov	r0, sl
     9bc:	f7ff fffe 	bl	0 <__aeabi_fadd>
     9c0:	f8d9 1030 	ldr.w	r1, [r9, #48]	; 0x30
     9c4:	4682      	mov	sl, r0
     9c6:	f8d4 01d0 	ldr.w	r0, [r4, #464]	; 0x1d0
     9ca:	f7ff fffe 	bl	0 <__aeabi_fmul>
     9ce:	4601      	mov	r1, r0
     9d0:	4650      	mov	r0, sl
     9d2:	f7ff fffe 	bl	0 <__aeabi_fadd>
     9d6:	4631      	mov	r1, r6
     9d8:	f7ff fffe 	bl	0 <__aeabi_fmul>
     9dc:	4601      	mov	r1, r0
     9de:	4658      	mov	r0, fp
     9e0:	f7ff fffe 	bl	0 <__aeabi_fadd>
     9e4:	f8d9 1020 	ldr.w	r1, [r9, #32]
     9e8:	f7ff fffe 	bl	0 <__aeabi_fadd>
     9ec:	f8c5 01a0 	str.w	r0, [r5, #416]	; 0x1a0
     9f0:	6228      	str	r0, [r5, #32]
     9f2:	f8d4 a1ec 	ldr.w	sl, [r4, #492]	; 0x1ec
     9f6:	992b      	ldr	r1, [sp, #172]	; 0xac
     9f8:	4650      	mov	r0, sl
     9fa:	f7ff fffe 	bl	0 <__aeabi_fmul>
     9fe:	9921      	ldr	r1, [sp, #132]	; 0x84
     a00:	4683      	mov	fp, r0
     a02:	f8d4 01f0 	ldr.w	r0, [r4, #496]	; 0x1f0
     a06:	f7ff fffe 	bl	0 <__aeabi_fmul>
     a0a:	4601      	mov	r1, r0
     a0c:	4658      	mov	r0, fp
     a0e:	f7ff fffe 	bl	0 <__aeabi_fadd>
     a12:	992d      	ldr	r1, [sp, #180]	; 0xb4
     a14:	4683      	mov	fp, r0
     a16:	f8d4 01f4 	ldr.w	r0, [r4, #500]	; 0x1f4
     a1a:	f7ff fffe 	bl	0 <__aeabi_fmul>
     a1e:	4601      	mov	r1, r0
     a20:	4658      	mov	r0, fp
     a22:	f7ff fffe 	bl	0 <__aeabi_fadd>
     a26:	9927      	ldr	r1, [sp, #156]	; 0x9c
     a28:	4683      	mov	fp, r0
     a2a:	f8d4 01fc 	ldr.w	r0, [r4, #508]	; 0x1fc
     a2e:	f7ff fffe 	bl	0 <__aeabi_fmul>
     a32:	4601      	mov	r1, r0
     a34:	4658      	mov	r0, fp
     a36:	f7ff fffe 	bl	0 <__aeabi_fadd>
     a3a:	991b      	ldr	r1, [sp, #108]	; 0x6c
     a3c:	4683      	mov	fp, r0
     a3e:	f8d4 0200 	ldr.w	r0, [r4, #512]	; 0x200
     a42:	f7ff fffe 	bl	0 <__aeabi_fmul>
     a46:	4601      	mov	r1, r0
     a48:	4658      	mov	r0, fp
     a4a:	f7ff fffe 	bl	0 <__aeabi_fadd>
     a4e:	9928      	ldr	r1, [sp, #160]	; 0xa0
     a50:	4683      	mov	fp, r0
     a52:	f8d4 0204 	ldr.w	r0, [r4, #516]	; 0x204
     a56:	f7ff fffe 	bl	0 <__aeabi_fmul>
     a5a:	4601      	mov	r1, r0
     a5c:	4658      	mov	r0, fp
     a5e:	f7ff fffe 	bl	0 <__aeabi_fadd>
     a62:	9913      	ldr	r1, [sp, #76]	; 0x4c
     a64:	f7ff fffe 	bl	0 <__aeabi_fmul>
     a68:	f8d9 1018 	ldr.w	r1, [r9, #24]
     a6c:	4683      	mov	fp, r0
     a6e:	4650      	mov	r0, sl
     a70:	f7ff fffe 	bl	0 <__aeabi_fmul>
     a74:	4601      	mov	r1, r0
     a76:	9812      	ldr	r0, [sp, #72]	; 0x48
     a78:	f7ff fffe 	bl	0 <__aeabi_fadd>
     a7c:	f8d9 101c 	ldr.w	r1, [r9, #28]
     a80:	4682      	mov	sl, r0
     a82:	f8d4 01f0 	ldr.w	r0, [r4, #496]	; 0x1f0
     a86:	f7ff fffe 	bl	0 <__aeabi_fmul>
     a8a:	4601      	mov	r1, r0
     a8c:	4650      	mov	r0, sl
     a8e:	f7ff fffe 	bl	0 <__aeabi_fadd>
     a92:	f8d9 1020 	ldr.w	r1, [r9, #32]
     a96:	4682      	mov	sl, r0
     a98:	f8d4 01f4 	ldr.w	r0, [r4, #500]	; 0x1f4
     a9c:	f7ff fffe 	bl	0 <__aeabi_fmul>
     aa0:	4601      	mov	r1, r0
     aa2:	4650      	mov	r0, sl
     aa4:	f7ff fffe 	bl	0 <__aeabi_fadd>
     aa8:	f8d9 1028 	ldr.w	r1, [r9, #40]	; 0x28
     aac:	4682      	mov	sl, r0
     aae:	f8d4 01fc 	ldr.w	r0, [r4, #508]	; 0x1fc
     ab2:	f7ff fffe 	bl	0 <__aeabi_fmul>
     ab6:	4601      	mov	r1, r0
     ab8:	4650      	mov	r0, sl
     aba:	f7ff fffe 	bl	0 <__aeabi_fadd>
     abe:	f8d9 102c 	ldr.w	r1, [r9, #44]	; 0x2c
     ac2:	4682      	mov	sl, r0
     ac4:	f8d4 0200 	ldr.w	r0, [r4, #512]	; 0x200
     ac8:	f7ff fffe 	bl	0 <__aeabi_fmul>
     acc:	4601      	mov	r1, r0
     ace:	4650      	mov	r0, sl
     ad0:	f7ff fffe 	bl	0 <__aeabi_fadd>
     ad4:	f8d9 1030 	ldr.w	r1, [r9, #48]	; 0x30
     ad8:	4682      	mov	sl, r0
     ada:	f8d4 0204 	ldr.w	r0, [r4, #516]	; 0x204
     ade:	f7ff fffe 	bl	0 <__aeabi_fmul>
     ae2:	4601      	mov	r1, r0
     ae4:	4650      	mov	r0, sl
     ae6:	f7ff fffe 	bl	0 <__aeabi_fadd>
     aea:	4631      	mov	r1, r6
     aec:	f7ff fffe 	bl	0 <__aeabi_fmul>
     af0:	4601      	mov	r1, r0
     af2:	4658      	mov	r0, fp
     af4:	f7ff fffe 	bl	0 <__aeabi_fadd>
     af8:	f8d9 1024 	ldr.w	r1, [r9, #36]	; 0x24
     afc:	f7ff fffe 	bl	0 <__aeabi_fadd>
     b00:	4631      	mov	r1, r6
     b02:	f8c5 01d4 	str.w	r0, [r5, #468]	; 0x1d4
     b06:	6268      	str	r0, [r5, #36]	; 0x24
     b08:	9827      	ldr	r0, [sp, #156]	; 0x9c
     b0a:	f7ff fffe 	bl	0 <__aeabi_fmul>
     b0e:	f8d9 1028 	ldr.w	r1, [r9, #40]	; 0x28
     b12:	f7ff fffe 	bl	0 <__aeabi_fadd>
     b16:	4631      	mov	r1, r6
     b18:	f8c5 0208 	str.w	r0, [r5, #520]	; 0x208
     b1c:	62a8      	str	r0, [r5, #40]	; 0x28
     b1e:	981b      	ldr	r0, [sp, #108]	; 0x6c
     b20:	f7ff fffe 	bl	0 <__aeabi_fmul>
     b24:	f8d9 102c 	ldr.w	r1, [r9, #44]	; 0x2c
     b28:	f7ff fffe 	bl	0 <__aeabi_fadd>
     b2c:	4631      	mov	r1, r6
     b2e:	f8c5 023c 	str.w	r0, [r5, #572]	; 0x23c
     b32:	62e8      	str	r0, [r5, #44]	; 0x2c
     b34:	9828      	ldr	r0, [sp, #160]	; 0xa0
     b36:	f7ff fffe 	bl	0 <__aeabi_fmul>
     b3a:	f8d9 1030 	ldr.w	r1, [r9, #48]	; 0x30
     b3e:	f7ff fffe 	bl	0 <__aeabi_fadd>
     b42:	f8c5 0270 	str.w	r0, [r5, #624]	; 0x270
     b46:	6328      	str	r0, [r5, #48]	; 0x30
     b48:	f8d9 10e0 	ldr.w	r1, [r9, #224]	; 0xe0
     b4c:	f8d9 a044 	ldr.w	sl, [r9, #68]	; 0x44
     b50:	9147      	str	r1, [sp, #284]	; 0x11c
     b52:	4608      	mov	r0, r1
     b54:	9913      	ldr	r1, [sp, #76]	; 0x4c
     b56:	f7ff fffe 	bl	0 <__aeabi_fmul>
     b5a:	4651      	mov	r1, sl
     b5c:	4683      	mov	fp, r0
     b5e:	4650      	mov	r0, sl
     b60:	f7ff fffe 	bl	0 <__aeabi_fadd>
     b64:	4631      	mov	r1, r6
     b66:	f7ff fffe 	bl	0 <__aeabi_fmul>
     b6a:	4601      	mov	r1, r0
     b6c:	4658      	mov	r0, fp
     b6e:	f7ff fffe 	bl	0 <__aeabi_fadd>
     b72:	f8d9 1038 	ldr.w	r1, [r9, #56]	; 0x38
     b76:	f7ff fffe 	bl	0 <__aeabi_fadd>
     b7a:	9b1d      	ldr	r3, [sp, #116]	; 0x74
     b7c:	9913      	ldr	r1, [sp, #76]	; 0x4c
     b7e:	6058      	str	r0, [r3, #4]
     b80:	f8d9 2048 	ldr.w	r2, [r9, #72]	; 0x48
     b84:	f8d9 c078 	ldr.w	ip, [r9, #120]	; 0x78
     b88:	f8d9 00e4 	ldr.w	r0, [r9, #228]	; 0xe4
     b8c:	9214      	str	r2, [sp, #80]	; 0x50
     b8e:	f8cd c060 	str.w	ip, [sp, #96]	; 0x60
     b92:	9045      	str	r0, [sp, #276]	; 0x114
     b94:	f7ff fffe 	bl	0 <__aeabi_fmul>
     b98:	9918      	ldr	r1, [sp, #96]	; 0x60
     b9a:	4683      	mov	fp, r0
     b9c:	9814      	ldr	r0, [sp, #80]	; 0x50
     b9e:	f7ff fffe 	bl	0 <__aeabi_fadd>
     ba2:	4631      	mov	r1, r6
     ba4:	f7ff fffe 	bl	0 <__aeabi_fmul>
     ba8:	4601      	mov	r1, r0
     baa:	4658      	mov	r0, fp
     bac:	f7ff fffe 	bl	0 <__aeabi_fadd>
     bb0:	f8d9 103c 	ldr.w	r1, [r9, #60]	; 0x3c
     bb4:	f7ff fffe 	bl	0 <__aeabi_fadd>
     bb8:	992e      	ldr	r1, [sp, #184]	; 0xb8
     bba:	6048      	str	r0, [r1, #4]
     bbc:	9b1d      	ldr	r3, [sp, #116]	; 0x74
     bbe:	6098      	str	r0, [r3, #8]
     bc0:	f8d9 00f0 	ldr.w	r0, [r9, #240]	; 0xf0
     bc4:	f8d9 20e8 	ldr.w	r2, [r9, #232]	; 0xe8
     bc8:	f8d9 c0ec 	ldr.w	ip, [r9, #236]	; 0xec
     bcc:	f8d8 b018 	ldr.w	fp, [r8, #24]
     bd0:	f8d9 10f4 	ldr.w	r1, [r9, #244]	; 0xf4
     bd4:	903e      	str	r0, [sp, #248]	; 0xf8
     bd6:	f8d9 0058 	ldr.w	r0, [r9, #88]	; 0x58
     bda:	f8d9 304c 	ldr.w	r3, [r9, #76]	; 0x4c
     bde:	921c      	str	r2, [sp, #112]	; 0x70
     be0:	f8cd c090 	str.w	ip, [sp, #144]	; 0x90
     be4:	f8d9 2050 	ldr.w	r2, [r9, #80]	; 0x50
     be8:	f8d9 c054 	ldr.w	ip, [r9, #84]	; 0x54
     bec:	913f      	str	r1, [sp, #252]	; 0xfc
     bee:	9020      	str	r0, [sp, #128]	; 0x80
     bf0:	991c      	ldr	r1, [sp, #112]	; 0x70
     bf2:	4658      	mov	r0, fp
     bf4:	9222      	str	r2, [sp, #136]	; 0x88
     bf6:	f8cd c08c 	str.w	ip, [sp, #140]	; 0x8c
     bfa:	931e      	str	r3, [sp, #120]	; 0x78
     bfc:	f7ff fffe 	bl	0 <__aeabi_fmul>
     c00:	9924      	ldr	r1, [sp, #144]	; 0x90
     c02:	4681      	mov	r9, r0
     c04:	f8d8 001c 	ldr.w	r0, [r8, #28]
     c08:	f7ff fffe 	bl	0 <__aeabi_fmul>
     c0c:	4601      	mov	r1, r0
     c0e:	4648      	mov	r0, r9
     c10:	f7ff fffe 	bl	0 <__aeabi_fadd>
     c14:	993e      	ldr	r1, [sp, #248]	; 0xf8
     c16:	4681      	mov	r9, r0
     c18:	f8d8 0020 	ldr.w	r0, [r8, #32]
     c1c:	f7ff fffe 	bl	0 <__aeabi_fmul>
     c20:	4601      	mov	r1, r0
     c22:	4648      	mov	r0, r9
     c24:	f7ff fffe 	bl	0 <__aeabi_fadd>
     c28:	993f      	ldr	r1, [sp, #252]	; 0xfc
     c2a:	4681      	mov	r9, r0
     c2c:	f8d8 0024 	ldr.w	r0, [r8, #36]	; 0x24
     c30:	f7ff fffe 	bl	0 <__aeabi_fmul>
     c34:	4601      	mov	r1, r0
     c36:	4648      	mov	r0, r9
     c38:	f7ff fffe 	bl	0 <__aeabi_fadd>
     c3c:	9913      	ldr	r1, [sp, #76]	; 0x4c
     c3e:	f7ff fffe 	bl	0 <__aeabi_fmul>
     c42:	991e      	ldr	r1, [sp, #120]	; 0x78
     c44:	4681      	mov	r9, r0
     c46:	4658      	mov	r0, fp
     c48:	f7ff fffe 	bl	0 <__aeabi_fmul>
     c4c:	4601      	mov	r1, r0
     c4e:	9840      	ldr	r0, [sp, #256]	; 0x100
     c50:	f7ff fffe 	bl	0 <__aeabi_fadd>
     c54:	9922      	ldr	r1, [sp, #136]	; 0x88
     c56:	4683      	mov	fp, r0
     c58:	f8d8 001c 	ldr.w	r0, [r8, #28]
     c5c:	f7ff fffe 	bl	0 <__aeabi_fmul>
     c60:	4601      	mov	r1, r0
     c62:	4658      	mov	r0, fp
     c64:	f7ff fffe 	bl	0 <__aeabi_fadd>
     c68:	9923      	ldr	r1, [sp, #140]	; 0x8c
     c6a:	4683      	mov	fp, r0
     c6c:	f8d8 0020 	ldr.w	r0, [r8, #32]
     c70:	f7ff fffe 	bl	0 <__aeabi_fmul>
     c74:	4601      	mov	r1, r0
     c76:	4658      	mov	r0, fp
     c78:	f7ff fffe 	bl	0 <__aeabi_fadd>
     c7c:	9920      	ldr	r1, [sp, #128]	; 0x80
     c7e:	4683      	mov	fp, r0
     c80:	f8d8 0024 	ldr.w	r0, [r8, #36]	; 0x24
     c84:	f7ff fffe 	bl	0 <__aeabi_fmul>
     c88:	4601      	mov	r1, r0
     c8a:	4658      	mov	r0, fp
     c8c:	f7ff fffe 	bl	0 <__aeabi_fadd>
     c90:	4631      	mov	r1, r6
     c92:	f7ff fffe 	bl	0 <__aeabi_fmul>
     c96:	4601      	mov	r1, r0
     c98:	4648      	mov	r0, r9
     c9a:	f7ff fffe 	bl	0 <__aeabi_fadd>
     c9e:	9917      	ldr	r1, [sp, #92]	; 0x5c
     ca0:	f7ff fffe 	bl	0 <__aeabi_fadd>
     ca4:	9925      	ldr	r1, [sp, #148]	; 0x94
     ca6:	6048      	str	r0, [r1, #4]
     ca8:	9b1d      	ldr	r3, [sp, #116]	; 0x74
     caa:	991c      	ldr	r1, [sp, #112]	; 0x70
     cac:	60d8      	str	r0, [r3, #12]
     cae:	f8d7 9018 	ldr.w	r9, [r7, #24]
     cb2:	4648      	mov	r0, r9
     cb4:	f7ff fffe 	bl	0 <__aeabi_fmul>
     cb8:	9924      	ldr	r1, [sp, #144]	; 0x90
     cba:	4683      	mov	fp, r0
     cbc:	69f8      	ldr	r0, [r7, #28]
     cbe:	f7ff fffe 	bl	0 <__aeabi_fmul>
     cc2:	4601      	mov	r1, r0
     cc4:	4658      	mov	r0, fp
     cc6:	f7ff fffe 	bl	0 <__aeabi_fadd>
     cca:	993e      	ldr	r1, [sp, #248]	; 0xf8
     ccc:	4683      	mov	fp, r0
     cce:	6a38      	ldr	r0, [r7, #32]
     cd0:	f7ff fffe 	bl	0 <__aeabi_fmul>
     cd4:	4601      	mov	r1, r0
     cd6:	4658      	mov	r0, fp
     cd8:	f7ff fffe 	bl	0 <__aeabi_fadd>
     cdc:	993f      	ldr	r1, [sp, #252]	; 0xfc
     cde:	4683      	mov	fp, r0
     ce0:	6a78      	ldr	r0, [r7, #36]	; 0x24
     ce2:	f7ff fffe 	bl	0 <__aeabi_fmul>
     ce6:	4601      	mov	r1, r0
     ce8:	4658      	mov	r0, fp
     cea:	f7ff fffe 	bl	0 <__aeabi_fadd>
     cee:	9913      	ldr	r1, [sp, #76]	; 0x4c
     cf0:	f7ff fffe 	bl	0 <__aeabi_fmul>
     cf4:	991e      	ldr	r1, [sp, #120]	; 0x78
     cf6:	4683      	mov	fp, r0
     cf8:	4648      	mov	r0, r9
     cfa:	f7ff fffe 	bl	0 <__aeabi_fmul>
     cfe:	4601      	mov	r1, r0
     d00:	9847      	ldr	r0, [sp, #284]	; 0x11c
     d02:	f7ff fffe 	bl	0 <__aeabi_fadd>
     d06:	9922      	ldr	r1, [sp, #136]	; 0x88
     d08:	4681      	mov	r9, r0
     d0a:	69f8      	ldr	r0, [r7, #28]
     d0c:	f7ff fffe 	bl	0 <__aeabi_fmul>
     d10:	4601      	mov	r1, r0
     d12:	4648      	mov	r0, r9
     d14:	f7ff fffe 	bl	0 <__aeabi_fadd>
     d18:	9923      	ldr	r1, [sp, #140]	; 0x8c
     d1a:	4681      	mov	r9, r0
     d1c:	6a38      	ldr	r0, [r7, #32]
     d1e:	f7ff fffe 	bl	0 <__aeabi_fmul>
     d22:	4601      	mov	r1, r0
     d24:	4648      	mov	r0, r9
     d26:	f7ff fffe 	bl	0 <__aeabi_fadd>
     d2a:	9920      	ldr	r1, [sp, #128]	; 0x80
     d2c:	4681      	mov	r9, r0
     d2e:	6a78      	ldr	r0, [r7, #36]	; 0x24
     d30:	f7ff fffe 	bl	0 <__aeabi_fmul>
     d34:	4601      	mov	r1, r0
     d36:	4648      	mov	r0, r9
     d38:	f7ff fffe 	bl	0 <__aeabi_fadd>
     d3c:	4631      	mov	r1, r6
     d3e:	f7ff fffe 	bl	0 <__aeabi_fmul>
     d42:	4601      	mov	r1, r0
     d44:	4658      	mov	r0, fp
     d46:	f7ff fffe 	bl	0 <__aeabi_fadd>
     d4a:	4651      	mov	r1, sl
     d4c:	f7ff fffe 	bl	0 <__aeabi_fadd>
     d50:	9a30      	ldr	r2, [sp, #192]	; 0xc0
     d52:	6050      	str	r0, [r2, #4]
     d54:	991d      	ldr	r1, [sp, #116]	; 0x74
     d56:	6108      	str	r0, [r1, #16]
     d58:	f8d4 a11c 	ldr.w	sl, [r4, #284]	; 0x11c
     d5c:	991c      	ldr	r1, [sp, #112]	; 0x70
     d5e:	4650      	mov	r0, sl
     d60:	f7ff fffe 	bl	0 <__aeabi_fmul>
     d64:	f8d4 9120 	ldr.w	r9, [r4, #288]	; 0x120
     d68:	4683      	mov	fp, r0
     d6a:	9924      	ldr	r1, [sp, #144]	; 0x90
     d6c:	4648      	mov	r0, r9
     d6e:	f7ff fffe 	bl	0 <__aeabi_fmul>
     d72:	4601      	mov	r1, r0
     d74:	4658      	mov	r0, fp
     d76:	f7ff fffe 	bl	0 <__aeabi_fadd>
     d7a:	993e      	ldr	r1, [sp, #248]	; 0xf8
     d7c:	4683      	mov	fp, r0
     d7e:	f8d4 0124 	ldr.w	r0, [r4, #292]	; 0x124
     d82:	f7ff fffe 	bl	0 <__aeabi_fmul>
     d86:	4601      	mov	r1, r0
     d88:	4658      	mov	r0, fp
     d8a:	f7ff fffe 	bl	0 <__aeabi_fadd>
     d8e:	993f      	ldr	r1, [sp, #252]	; 0xfc
     d90:	4683      	mov	fp, r0
     d92:	f8d4 0128 	ldr.w	r0, [r4, #296]	; 0x128
     d96:	f7ff fffe 	bl	0 <__aeabi_fmul>
     d9a:	4601      	mov	r1, r0
     d9c:	4658      	mov	r0, fp
     d9e:	f7ff fffe 	bl	0 <__aeabi_fadd>
     da2:	9913      	ldr	r1, [sp, #76]	; 0x4c
     da4:	f7ff fffe 	bl	0 <__aeabi_fmul>
     da8:	991e      	ldr	r1, [sp, #120]	; 0x78
     daa:	4683      	mov	fp, r0
     dac:	4650      	mov	r0, sl
     dae:	f7ff fffe 	bl	0 <__aeabi_fmul>
     db2:	4601      	mov	r1, r0
     db4:	9845      	ldr	r0, [sp, #276]	; 0x114
     db6:	f7ff fffe 	bl	0 <__aeabi_fadd>
     dba:	9922      	ldr	r1, [sp, #136]	; 0x88
     dbc:	4682      	mov	sl, r0
     dbe:	4648      	mov	r0, r9
     dc0:	f7ff fffe 	bl	0 <__aeabi_fmul>
     dc4:	4601      	mov	r1, r0
     dc6:	4650      	mov	r0, sl
     dc8:	f7ff fffe 	bl	0 <__aeabi_fadd>
     dcc:	9923      	ldr	r1, [sp, #140]	; 0x8c
     dce:	4682      	mov	sl, r0
     dd0:	f8d4 0124 	ldr.w	r0, [r4, #292]	; 0x124
     dd4:	f7ff fffe 	bl	0 <__aeabi_fmul>
     dd8:	4601      	mov	r1, r0
     dda:	4650      	mov	r0, sl
     ddc:	f7ff fffe 	bl	0 <__aeabi_fadd>
     de0:	9920      	ldr	r1, [sp, #128]	; 0x80
     de2:	4681      	mov	r9, r0
     de4:	f8d4 0128 	ldr.w	r0, [r4, #296]	; 0x128
     de8:	f7ff fffe 	bl	0 <__aeabi_fmul>
     dec:	4601      	mov	r1, r0
     dee:	4648      	mov	r0, r9
     df0:	f7ff fffe 	bl	0 <__aeabi_fadd>
     df4:	4631      	mov	r1, r6
     df6:	f7ff fffe 	bl	0 <__aeabi_fmul>
     dfa:	4601      	mov	r1, r0
     dfc:	4658      	mov	r0, fp
     dfe:	f7ff fffe 	bl	0 <__aeabi_fadd>
     e02:	9914      	ldr	r1, [sp, #80]	; 0x50
     e04:	f7ff fffe 	bl	0 <__aeabi_fadd>
     e08:	f8c5 0108 	str.w	r0, [r5, #264]	; 0x108
     e0c:	9b1d      	ldr	r3, [sp, #116]	; 0x74
     e0e:	9924      	ldr	r1, [sp, #144]	; 0x90
     e10:	6158      	str	r0, [r3, #20]
     e12:	f8d4 a154 	ldr.w	sl, [r4, #340]	; 0x154
     e16:	98a7      	ldr	r0, [sp, #668]	; 0x29c
     e18:	9aa5      	ldr	r2, [sp, #660]	; 0x294
     e1a:	f8dd c298 	ldr.w	ip, [sp, #664]	; 0x298
     e1e:	9037      	str	r0, [sp, #220]	; 0xdc
     e20:	4650      	mov	r0, sl
     e22:	9236      	str	r2, [sp, #216]	; 0xd8
     e24:	f8cd c0f0 	str.w	ip, [sp, #240]	; 0xf0
     e28:	f7ff fffe 	bl	0 <__aeabi_fmul>
     e2c:	f8d4 9158 	ldr.w	r9, [r4, #344]	; 0x158
     e30:	4683      	mov	fp, r0
     e32:	993e      	ldr	r1, [sp, #248]	; 0xf8
     e34:	4648      	mov	r0, r9
     e36:	f7ff fffe 	bl	0 <__aeabi_fmul>
     e3a:	4601      	mov	r1, r0
     e3c:	4658      	mov	r0, fp
     e3e:	f7ff fffe 	bl	0 <__aeabi_fadd>
     e42:	993f      	ldr	r1, [sp, #252]	; 0xfc
     e44:	4683      	mov	fp, r0
     e46:	f8d4 015c 	ldr.w	r0, [r4, #348]	; 0x15c
     e4a:	f7ff fffe 	bl	0 <__aeabi_fmul>
     e4e:	4601      	mov	r1, r0
     e50:	4658      	mov	r0, fp
     e52:	f7ff fffe 	bl	0 <__aeabi_fadd>
     e56:	9936      	ldr	r1, [sp, #216]	; 0xd8
     e58:	4683      	mov	fp, r0
     e5a:	f8d4 0160 	ldr.w	r0, [r4, #352]	; 0x160
     e5e:	f7ff fffe 	bl	0 <__aeabi_fmul>
     e62:	4601      	mov	r1, r0
     e64:	4658      	mov	r0, fp
     e66:	f7ff fffe 	bl	0 <__aeabi_fadd>
     e6a:	993c      	ldr	r1, [sp, #240]	; 0xf0
     e6c:	4683      	mov	fp, r0
     e6e:	f8d4 0164 	ldr.w	r0, [r4, #356]	; 0x164
     e72:	f7ff fffe 	bl	0 <__aeabi_fmul>
     e76:	4601      	mov	r1, r0
     e78:	4658      	mov	r0, fp
     e7a:	f7ff fffe 	bl	0 <__aeabi_fadd>
     e7e:	9937      	ldr	r1, [sp, #220]	; 0xdc
     e80:	4683      	mov	fp, r0
     e82:	f8d4 0168 	ldr.w	r0, [r4, #360]	; 0x168
     e86:	f7ff fffe 	bl	0 <__aeabi_fmul>
     e8a:	4601      	mov	r1, r0
     e8c:	4658      	mov	r0, fp
     e8e:	f7ff fffe 	bl	0 <__aeabi_fadd>
     e92:	9913      	ldr	r1, [sp, #76]	; 0x4c
     e94:	f7ff fffe 	bl	0 <__aeabi_fmul>
     e98:	9922      	ldr	r1, [sp, #136]	; 0x88
     e9a:	4683      	mov	fp, r0
     e9c:	4650      	mov	r0, sl
     e9e:	f7ff fffe 	bl	0 <__aeabi_fmul>
     ea2:	4601      	mov	r1, r0
     ea4:	981c      	ldr	r0, [sp, #112]	; 0x70
     ea6:	f7ff fffe 	bl	0 <__aeabi_fadd>
     eaa:	9923      	ldr	r1, [sp, #140]	; 0x8c
     eac:	4682      	mov	sl, r0
     eae:	4648      	mov	r0, r9
     eb0:	f7ff fffe 	bl	0 <__aeabi_fmul>
     eb4:	4601      	mov	r1, r0
     eb6:	4650      	mov	r0, sl
     eb8:	f7ff fffe 	bl	0 <__aeabi_fadd>
     ebc:	9920      	ldr	r1, [sp, #128]	; 0x80
     ebe:	4682      	mov	sl, r0
     ec0:	f8d4 015c 	ldr.w	r0, [r4, #348]	; 0x15c
     ec4:	f7ff fffe 	bl	0 <__aeabi_fmul>
     ec8:	4601      	mov	r1, r0
     eca:	4650      	mov	r0, sl
     ecc:	f7ff fffe 	bl	0 <__aeabi_fadd>
     ed0:	997e      	ldr	r1, [sp, #504]	; 0x1f8
     ed2:	4681      	mov	r9, r0
     ed4:	f8d4 0160 	ldr.w	r0, [r4, #352]	; 0x160
     ed8:	f7ff fffe 	bl	0 <__aeabi_fmul>
     edc:	4601      	mov	r1, r0
     ede:	4648      	mov	r0, r9
     ee0:	f7ff fffe 	bl	0 <__aeabi_fadd>
     ee4:	997f      	ldr	r1, [sp, #508]	; 0x1fc
     ee6:	4682      	mov	sl, r0
     ee8:	f8d4 0164 	ldr.w	r0, [r4, #356]	; 0x164
     eec:	f7ff fffe 	bl	0 <__aeabi_fmul>
     ef0:	4601      	mov	r1, r0
     ef2:	4650      	mov	r0, sl
     ef4:	f7ff fffe 	bl	0 <__aeabi_fadd>
     ef8:	9980      	ldr	r1, [sp, #512]	; 0x200
     efa:	4681      	mov	r9, r0
     efc:	f8d4 0168 	ldr.w	r0, [r4, #360]	; 0x168
     f00:	f7ff fffe 	bl	0 <__aeabi_fmul>
     f04:	4601      	mov	r1, r0
     f06:	4648      	mov	r0, r9
     f08:	f7ff fffe 	bl	0 <__aeabi_fadd>
     f0c:	4631      	mov	r1, r6
     f0e:	f7ff fffe 	bl	0 <__aeabi_fmul>
     f12:	4601      	mov	r1, r0
     f14:	4658      	mov	r0, fp
     f16:	f7ff fffe 	bl	0 <__aeabi_fadd>
     f1a:	991e      	ldr	r1, [sp, #120]	; 0x78
     f1c:	f7ff fffe 	bl	0 <__aeabi_fadd>
     f20:	f8c5 013c 	str.w	r0, [r5, #316]	; 0x13c
     f24:	991d      	ldr	r1, [sp, #116]	; 0x74
     f26:	6188      	str	r0, [r1, #24]
     f28:	f8d4 a184 	ldr.w	sl, [r4, #388]	; 0x184
     f2c:	991c      	ldr	r1, [sp, #112]	; 0x70
     f2e:	4650      	mov	r0, sl
     f30:	f7ff fffe 	bl	0 <__aeabi_fmul>
     f34:	f8d4 918c 	ldr.w	r9, [r4, #396]	; 0x18c
     f38:	4683      	mov	fp, r0
     f3a:	993e      	ldr	r1, [sp, #248]	; 0xf8
     f3c:	4648      	mov	r0, r9
     f3e:	f7ff fffe 	bl	0 <__aeabi_fmul>
     f42:	4601      	mov	r1, r0
     f44:	4658      	mov	r0, fp
     f46:	f7ff fffe 	bl	0 <__aeabi_fadd>
     f4a:	993f      	ldr	r1, [sp, #252]	; 0xfc
     f4c:	4683      	mov	fp, r0
     f4e:	f8d4 0190 	ldr.w	r0, [r4, #400]	; 0x190
     f52:	f7ff fffe 	bl	0 <__aeabi_fmul>
     f56:	4601      	mov	r1, r0
     f58:	4658      	mov	r0, fp
     f5a:	f7ff fffe 	bl	0 <__aeabi_fadd>
     f5e:	9936      	ldr	r1, [sp, #216]	; 0xd8
     f60:	4683      	mov	fp, r0
     f62:	f8d4 0194 	ldr.w	r0, [r4, #404]	; 0x194
     f66:	f7ff fffe 	bl	0 <__aeabi_fmul>
     f6a:	4601      	mov	r1, r0
     f6c:	4658      	mov	r0, fp
     f6e:	f7ff fffe 	bl	0 <__aeabi_fadd>
     f72:	993c      	ldr	r1, [sp, #240]	; 0xf0
     f74:	4683      	mov	fp, r0
     f76:	f8d4 0198 	ldr.w	r0, [r4, #408]	; 0x198
     f7a:	f7ff fffe 	bl	0 <__aeabi_fmul>
     f7e:	4601      	mov	r1, r0
     f80:	4658      	mov	r0, fp
     f82:	f7ff fffe 	bl	0 <__aeabi_fadd>
     f86:	9937      	ldr	r1, [sp, #220]	; 0xdc
     f88:	4683      	mov	fp, r0
     f8a:	f8d4 019c 	ldr.w	r0, [r4, #412]	; 0x19c
     f8e:	f7ff fffe 	bl	0 <__aeabi_fmul>
     f92:	4601      	mov	r1, r0
     f94:	4658      	mov	r0, fp
     f96:	f7ff fffe 	bl	0 <__aeabi_fadd>
     f9a:	9913      	ldr	r1, [sp, #76]	; 0x4c
     f9c:	f7ff fffe 	bl	0 <__aeabi_fmul>
     fa0:	991e      	ldr	r1, [sp, #120]	; 0x78
     fa2:	4683      	mov	fp, r0
     fa4:	4650      	mov	r0, sl
     fa6:	f7ff fffe 	bl	0 <__aeabi_fmul>
     faa:	4601      	mov	r1, r0
     fac:	9824      	ldr	r0, [sp, #144]	; 0x90
     fae:	f7ff fffe 	bl	0 <__aeabi_fadd>
     fb2:	9923      	ldr	r1, [sp, #140]	; 0x8c
     fb4:	4682      	mov	sl, r0
     fb6:	4648      	mov	r0, r9
     fb8:	f7ff fffe 	bl	0 <__aeabi_fmul>
     fbc:	4601      	mov	r1, r0
     fbe:	4650      	mov	r0, sl
     fc0:	f7ff fffe 	bl	0 <__aeabi_fadd>
     fc4:	9920      	ldr	r1, [sp, #128]	; 0x80
     fc6:	4682      	mov	sl, r0
     fc8:	f8d4 0190 	ldr.w	r0, [r4, #400]	; 0x190
     fcc:	f7ff fffe 	bl	0 <__aeabi_fmul>
     fd0:	4601      	mov	r1, r0
     fd2:	4650      	mov	r0, sl
     fd4:	f7ff fffe 	bl	0 <__aeabi_fadd>
     fd8:	997e      	ldr	r1, [sp, #504]	; 0x1f8
     fda:	4681      	mov	r9, r0
     fdc:	f8d4 0194 	ldr.w	r0, [r4, #404]	; 0x194
     fe0:	f7ff fffe 	bl	0 <__aeabi_fmul>
     fe4:	4601      	mov	r1, r0
     fe6:	4648      	mov	r0, r9
     fe8:	f7ff fffe 	bl	0 <__aeabi_fadd>
     fec:	997f      	ldr	r1, [sp, #508]	; 0x1fc
     fee:	4682      	mov	sl, r0
     ff0:	f8d4 0198 	ldr.w	r0, [r4, #408]	; 0x198
     ff4:	f7ff fffe 	bl	0 <__aeabi_fmul>
     ff8:	4601      	mov	r1, r0
     ffa:	4650      	mov	r0, sl
     ffc:	f7ff fffe 	bl	0 <__aeabi_fadd>
    1000:	9980      	ldr	r1, [sp, #512]	; 0x200
    1002:	4681      	mov	r9, r0
    1004:	f8d4 019c 	ldr.w	r0, [r4, #412]	; 0x19c
    1008:	f7ff fffe 	bl	0 <__aeabi_fmul>
    100c:	4601      	mov	r1, r0
    100e:	4648      	mov	r0, r9
    1010:	f7ff fffe 	bl	0 <__aeabi_fadd>
    1014:	4631      	mov	r1, r6
    1016:	f7ff fffe 	bl	0 <__aeabi_fmul>
    101a:	4601      	mov	r1, r0
    101c:	4658      	mov	r0, fp
    101e:	f7ff fffe 	bl	0 <__aeabi_fadd>
    1022:	9922      	ldr	r1, [sp, #136]	; 0x88
    1024:	f7ff fffe 	bl	0 <__aeabi_fadd>
    1028:	f8c5 0170 	str.w	r0, [r5, #368]	; 0x170
    102c:	9b1d      	ldr	r3, [sp, #116]	; 0x74
    102e:	991c      	ldr	r1, [sp, #112]	; 0x70
    1030:	61d8      	str	r0, [r3, #28]
    1032:	f8d4 a1b8 	ldr.w	sl, [r4, #440]	; 0x1b8
    1036:	f8d4 91bc 	ldr.w	r9, [r4, #444]	; 0x1bc
    103a:	4650      	mov	r0, sl
    103c:	f7ff fffe 	bl	0 <__aeabi_fmul>
    1040:	9924      	ldr	r1, [sp, #144]	; 0x90
    1042:	4683      	mov	fp, r0
    1044:	4648      	mov	r0, r9
    1046:	f7ff fffe 	bl	0 <__aeabi_fmul>
    104a:	4601      	mov	r1, r0
    104c:	4658      	mov	r0, fp
    104e:	f7ff fffe 	bl	0 <__aeabi_fadd>
    1052:	993f      	ldr	r1, [sp, #252]	; 0xfc
    1054:	4683      	mov	fp, r0
    1056:	f8d4 01c4 	ldr.w	r0, [r4, #452]	; 0x1c4
    105a:	f7ff fffe 	bl	0 <__aeabi_fmul>
    105e:	4601      	mov	r1, r0
    1060:	4658      	mov	r0, fp
    1062:	f7ff fffe 	bl	0 <__aeabi_fadd>
    1066:	9936      	ldr	r1, [sp, #216]	; 0xd8
    1068:	4683      	mov	fp, r0
    106a:	f8d4 01c8 	ldr.w	r0, [r4, #456]	; 0x1c8
    106e:	f7ff fffe 	bl	0 <__aeabi_fmul>
    1072:	4601      	mov	r1, r0
    1074:	4658      	mov	r0, fp
    1076:	f7ff fffe 	bl	0 <__aeabi_fadd>
    107a:	993c      	ldr	r1, [sp, #240]	; 0xf0
    107c:	4683      	mov	fp, r0
    107e:	f8d4 01cc 	ldr.w	r0, [r4, #460]	; 0x1cc
    1082:	f7ff fffe 	bl	0 <__aeabi_fmul>
    1086:	4601      	mov	r1, r0
    1088:	4658      	mov	r0, fp
    108a:	f7ff fffe 	bl	0 <__aeabi_fadd>
    108e:	9937      	ldr	r1, [sp, #220]	; 0xdc
    1090:	4683      	mov	fp, r0
    1092:	f8d4 01d0 	ldr.w	r0, [r4, #464]	; 0x1d0
    1096:	f7ff fffe 	bl	0 <__aeabi_fmul>
    109a:	4601      	mov	r1, r0
    109c:	4658      	mov	r0, fp
    109e:	f7ff fffe 	bl	0 <__aeabi_fadd>
    10a2:	9913      	ldr	r1, [sp, #76]	; 0x4c
    10a4:	f7ff fffe 	bl	0 <__aeabi_fmul>
    10a8:	991e      	ldr	r1, [sp, #120]	; 0x78
    10aa:	4683      	mov	fp, r0
    10ac:	4650      	mov	r0, sl
    10ae:	f7ff fffe 	bl	0 <__aeabi_fmul>
    10b2:	4601      	mov	r1, r0
    10b4:	983e      	ldr	r0, [sp, #248]	; 0xf8
    10b6:	f7ff fffe 	bl	0 <__aeabi_fadd>
    10ba:	9922      	ldr	r1, [sp, #136]	; 0x88
    10bc:	4682      	mov	sl, r0
    10be:	4648      	mov	r0, r9
    10c0:	f7ff fffe 	bl	0 <__aeabi_fmul>
    10c4:	4601      	mov	r1, r0
    10c6:	4650      	mov	r0, sl
    10c8:	f7ff fffe 	bl	0 <__aeabi_fadd>
    10cc:	9920      	ldr	r1, [sp, #128]	; 0x80
    10ce:	4682      	mov	sl, r0
    10d0:	f8d4 01c4 	ldr.w	r0, [r4, #452]	; 0x1c4
    10d4:	f7ff fffe 	bl	0 <__aeabi_fmul>
    10d8:	4601      	mov	r1, r0
    10da:	4650      	mov	r0, sl
    10dc:	f7ff fffe 	bl	0 <__aeabi_fadd>
    10e0:	997e      	ldr	r1, [sp, #504]	; 0x1f8
    10e2:	4681      	mov	r9, r0
    10e4:	f8d4 01c8 	ldr.w	r0, [r4, #456]	; 0x1c8
    10e8:	f7ff fffe 	bl	0 <__aeabi_fmul>
    10ec:	4601      	mov	r1, r0
    10ee:	4648      	mov	r0, r9
    10f0:	f7ff fffe 	bl	0 <__aeabi_fadd>
    10f4:	997f      	ldr	r1, [sp, #508]	; 0x1fc
    10f6:	4682      	mov	sl, r0
    10f8:	f8d4 01cc 	ldr.w	r0, [r4, #460]	; 0x1cc
    10fc:	f7ff fffe 	bl	0 <__aeabi_fmul>
    1100:	4601      	mov	r1, r0
    1102:	4650      	mov	r0, sl
    1104:	f7ff fffe 	bl	0 <__aeabi_fadd>
    1108:	9980      	ldr	r1, [sp, #512]	; 0x200
    110a:	4681      	mov	r9, r0
    110c:	f8d4 01d0 	ldr.w	r0, [r4, #464]	; 0x1d0
    1110:	f7ff fffe 	bl	0 <__aeabi_fmul>
    1114:	4601      	mov	r1, r0
    1116:	4648      	mov	r0, r9
    1118:	f7ff fffe 	bl	0 <__aeabi_fadd>
    111c:	4631      	mov	r1, r6
    111e:	f7ff fffe 	bl	0 <__aeabi_fmul>
    1122:	4601      	mov	r1, r0
    1124:	4658      	mov	r0, fp
    1126:	f7ff fffe 	bl	0 <__aeabi_fadd>
    112a:	9923      	ldr	r1, [sp, #140]	; 0x8c
    112c:	f7ff fffe 	bl	0 <__aeabi_fadd>
    1130:	f8c5 01a4 	str.w	r0, [r5, #420]	; 0x1a4
    1134:	9a1d      	ldr	r2, [sp, #116]	; 0x74
    1136:	991c      	ldr	r1, [sp, #112]	; 0x70
    1138:	6210      	str	r0, [r2, #32]
    113a:	f8d4 a1ec 	ldr.w	sl, [r4, #492]	; 0x1ec
    113e:	f8d4 91f0 	ldr.w	r9, [r4, #496]	; 0x1f0
    1142:	4650      	mov	r0, sl
    1144:	f7ff fffe 	bl	0 <__aeabi_fmul>
    1148:	9924      	ldr	r1, [sp, #144]	; 0x90
    114a:	4683      	mov	fp, r0
    114c:	4648      	mov	r0, r9
    114e:	f7ff fffe 	bl	0 <__aeabi_fmul>
    1152:	4601      	mov	r1, r0
    1154:	4658      	mov	r0, fp
    1156:	f7ff fffe 	bl	0 <__aeabi_fadd>
    115a:	993e      	ldr	r1, [sp, #248]	; 0xf8
    115c:	4683      	mov	fp, r0
    115e:	f8d4 01f4 	ldr.w	r0, [r4, #500]	; 0x1f4
    1162:	f7ff fffe 	bl	0 <__aeabi_fmul>
    1166:	4601      	mov	r1, r0
    1168:	4658      	mov	r0, fp
    116a:	f7ff fffe 	bl	0 <__aeabi_fadd>
    116e:	9936      	ldr	r1, [sp, #216]	; 0xd8
    1170:	4683      	mov	fp, r0
    1172:	f8d4 01fc 	ldr.w	r0, [r4, #508]	; 0x1fc
    1176:	f7ff fffe 	bl	0 <__aeabi_fmul>
    117a:	4601      	mov	r1, r0
    117c:	4658      	mov	r0, fp
    117e:	f7ff fffe 	bl	0 <__aeabi_fadd>
    1182:	993c      	ldr	r1, [sp, #240]	; 0xf0
    1184:	4683      	mov	fp, r0
    1186:	f8d4 0200 	ldr.w	r0, [r4, #512]	; 0x200
    118a:	f7ff fffe 	bl	0 <__aeabi_fmul>
    118e:	4601      	mov	r1, r0
    1190:	4658      	mov	r0, fp
    1192:	f7ff fffe 	bl	0 <__aeabi_fadd>
    1196:	9937      	ldr	r1, [sp, #220]	; 0xdc
    1198:	4683      	mov	fp, r0
    119a:	f8d4 0204 	ldr.w	r0, [r4, #516]	; 0x204
    119e:	f7ff fffe 	bl	0 <__aeabi_fmul>
    11a2:	4601      	mov	r1, r0
    11a4:	4658      	mov	r0, fp
    11a6:	f7ff fffe 	bl	0 <__aeabi_fadd>
    11aa:	9913      	ldr	r1, [sp, #76]	; 0x4c
    11ac:	f7ff fffe 	bl	0 <__aeabi_fmul>
    11b0:	991e      	ldr	r1, [sp, #120]	; 0x78
    11b2:	4683      	mov	fp, r0
    11b4:	4650      	mov	r0, sl
    11b6:	f7ff fffe 	bl	0 <__aeabi_fmul>
    11ba:	4601      	mov	r1, r0
    11bc:	983f      	ldr	r0, [sp, #252]	; 0xfc
    11be:	f7ff fffe 	bl	0 <__aeabi_fadd>
    11c2:	9922      	ldr	r1, [sp, #136]	; 0x88
    11c4:	4682      	mov	sl, r0
    11c6:	4648      	mov	r0, r9
    11c8:	f7ff fffe 	bl	0 <__aeabi_fmul>
    11cc:	4601      	mov	r1, r0
    11ce:	4650      	mov	r0, sl
    11d0:	f7ff fffe 	bl	0 <__aeabi_fadd>
    11d4:	9923      	ldr	r1, [sp, #140]	; 0x8c
    11d6:	4682      	mov	sl, r0
    11d8:	f8d4 01f4 	ldr.w	r0, [r4, #500]	; 0x1f4
    11dc:	f7ff fffe 	bl	0 <__aeabi_fmul>
    11e0:	4601      	mov	r1, r0
    11e2:	4650      	mov	r0, sl
    11e4:	f7ff fffe 	bl	0 <__aeabi_fadd>
    11e8:	997e      	ldr	r1, [sp, #504]	; 0x1f8
    11ea:	4681      	mov	r9, r0
    11ec:	f8d4 01fc 	ldr.w	r0, [r4, #508]	; 0x1fc
    11f0:	f7ff fffe 	bl	0 <__aeabi_fmul>
    11f4:	4601      	mov	r1, r0
    11f6:	4648      	mov	r0, r9
    11f8:	f7ff fffe 	bl	0 <__aeabi_fadd>
    11fc:	997f      	ldr	r1, [sp, #508]	; 0x1fc
    11fe:	4682      	mov	sl, r0
    1200:	f8d4 0200 	ldr.w	r0, [r4, #512]	; 0x200
    1204:	f7ff fffe 	bl	0 <__aeabi_fmul>
    1208:	4601      	mov	r1, r0
    120a:	4650      	mov	r0, sl
    120c:	f7ff fffe 	bl	0 <__aeabi_fadd>
    1210:	9980      	ldr	r1, [sp, #512]	; 0x200
    1212:	4681      	mov	r9, r0
    1214:	f8d4 0204 	ldr.w	r0, [r4, #516]	; 0x204
    1218:	f7ff fffe 	bl	0 <__aeabi_fmul>
    121c:	4601      	mov	r1, r0
    121e:	4648      	mov	r0, r9
    1220:	f7ff fffe 	bl	0 <__aeabi_fadd>
    1224:	4631      	mov	r1, r6
    1226:	f7ff fffe 	bl	0 <__aeabi_fmul>
    122a:	4601      	mov	r1, r0
    122c:	4658      	mov	r0, fp
    122e:	f7ff fffe 	bl	0 <__aeabi_fadd>
    1232:	9920      	ldr	r1, [sp, #128]	; 0x80
    1234:	f7ff fffe 	bl	0 <__aeabi_fadd>
    1238:	f8c5 01d8 	str.w	r0, [r5, #472]	; 0x1d8
    123c:	991d      	ldr	r1, [sp, #116]	; 0x74
    123e:	6248      	str	r0, [r1, #36]	; 0x24
    1240:	9836      	ldr	r0, [sp, #216]	; 0xd8
    1242:	4631      	mov	r1, r6
    1244:	f7ff fffe 	bl	0 <__aeabi_fmul>
    1248:	997e      	ldr	r1, [sp, #504]	; 0x1f8
    124a:	f7ff fffe 	bl	0 <__aeabi_fadd>
    124e:	9b1d      	ldr	r3, [sp, #116]	; 0x74
    1250:	f8c5 020c 	str.w	r0, [r5, #524]	; 0x20c
    1254:	4631      	mov	r1, r6
    1256:	6298      	str	r0, [r3, #40]	; 0x28
    1258:	983c      	ldr	r0, [sp, #240]	; 0xf0
    125a:	f7ff fffe 	bl	0 <__aeabi_fmul>
    125e:	997f      	ldr	r1, [sp, #508]	; 0x1fc
    1260:	f7ff fffe 	bl	0 <__aeabi_fadd>
    1264:	9a1d      	ldr	r2, [sp, #116]	; 0x74
    1266:	f8c5 0240 	str.w	r0, [r5, #576]	; 0x240
    126a:	4631      	mov	r1, r6
    126c:	62d0      	str	r0, [r2, #44]	; 0x2c
    126e:	9837      	ldr	r0, [sp, #220]	; 0xdc
    1270:	f7ff fffe 	bl	0 <__aeabi_fmul>
    1274:	9980      	ldr	r1, [sp, #512]	; 0x200
    1276:	f7ff fffe 	bl	0 <__aeabi_fadd>
    127a:	991d      	ldr	r1, [sp, #116]	; 0x74
    127c:	f8c5 0274 	str.w	r0, [r5, #628]	; 0x274
    1280:	6308      	str	r0, [r1, #48]	; 0x30
    1282:	f8dd a2b4 	ldr.w	sl, [sp, #692]	; 0x2b4
    1286:	9913      	ldr	r1, [sp, #76]	; 0x4c
    1288:	4650      	mov	r0, sl
    128a:	f8cd a130 	str.w	sl, [sp, #304]	; 0x130
    128e:	f7ff fffe 	bl	0 <__aeabi_fmul>
    1292:	4681      	mov	r9, r0
    1294:	9886      	ldr	r0, [sp, #536]	; 0x218
    1296:	4601      	mov	r1, r0
    1298:	f7ff fffe 	bl	0 <__aeabi_fadd>
    129c:	4631      	mov	r1, r6
    129e:	f7ff fffe 	bl	0 <__aeabi_fmul>
    12a2:	4601      	mov	r1, r0
    12a4:	4648      	mov	r0, r9
    12a6:	f7ff fffe 	bl	0 <__aeabi_fadd>
    12aa:	9983      	ldr	r1, [sp, #524]	; 0x20c
    12ac:	f7ff fffe 	bl	0 <__aeabi_fadd>
    12b0:	9b2e      	ldr	r3, [sp, #184]	; 0xb8
    12b2:	6098      	str	r0, [r3, #8]
    12b4:	f8dd c2c0 	ldr.w	ip, [sp, #704]	; 0x2c0
    12b8:	9aae      	ldr	r2, [sp, #696]	; 0x2b8
    12ba:	99af      	ldr	r1, [sp, #700]	; 0x2bc
    12bc:	f8d8 a018 	ldr.w	sl, [r8, #24]
    12c0:	f8d8 901c 	ldr.w	r9, [r8, #28]
    12c4:	924a      	str	r2, [sp, #296]	; 0x128
    12c6:	9134      	str	r1, [sp, #208]	; 0xd0
    12c8:	f8cd c0d4 	str.w	ip, [sp, #212]	; 0xd4
    12cc:	98b1      	ldr	r0, [sp, #708]	; 0x2c4
    12ce:	994a      	ldr	r1, [sp, #296]	; 0x128
    12d0:	903b      	str	r0, [sp, #236]	; 0xec
    12d2:	4650      	mov	r0, sl
    12d4:	f7ff fffe 	bl	0 <__aeabi_fmul>
    12d8:	9934      	ldr	r1, [sp, #208]	; 0xd0
    12da:	4683      	mov	fp, r0
    12dc:	4648      	mov	r0, r9
    12de:	f7ff fffe 	bl	0 <__aeabi_fmul>
    12e2:	4601      	mov	r1, r0
    12e4:	4658      	mov	r0, fp
    12e6:	f7ff fffe 	bl	0 <__aeabi_fadd>
    12ea:	9935      	ldr	r1, [sp, #212]	; 0xd4
    12ec:	4683      	mov	fp, r0
    12ee:	f8d8 0020 	ldr.w	r0, [r8, #32]
    12f2:	f7ff fffe 	bl	0 <__aeabi_fmul>
    12f6:	4601      	mov	r1, r0
    12f8:	4658      	mov	r0, fp
    12fa:	f7ff fffe 	bl	0 <__aeabi_fadd>
    12fe:	993b      	ldr	r1, [sp, #236]	; 0xec
    1300:	4683      	mov	fp, r0
    1302:	f8d8 0024 	ldr.w	r0, [r8, #36]	; 0x24
    1306:	f7ff fffe 	bl	0 <__aeabi_fmul>
    130a:	4601      	mov	r1, r0
    130c:	4658      	mov	r0, fp
    130e:	f7ff fffe 	bl	0 <__aeabi_fadd>
    1312:	9913      	ldr	r1, [sp, #76]	; 0x4c
    1314:	f7ff fffe 	bl	0 <__aeabi_fmul>
    1318:	9987      	ldr	r1, [sp, #540]	; 0x21c
    131a:	4683      	mov	fp, r0
    131c:	4650      	mov	r0, sl
    131e:	f7ff fffe 	bl	0 <__aeabi_fmul>
    1322:	4601      	mov	r1, r0
    1324:	9844      	ldr	r0, [sp, #272]	; 0x110
    1326:	f7ff fffe 	bl	0 <__aeabi_fadd>
    132a:	9988      	ldr	r1, [sp, #544]	; 0x220
    132c:	4682      	mov	sl, r0
    132e:	4648      	mov	r0, r9
    1330:	f7ff fffe 	bl	0 <__aeabi_fmul>
    1334:	4601      	mov	r1, r0
    1336:	4650      	mov	r0, sl
    1338:	f7ff fffe 	bl	0 <__aeabi_fadd>
    133c:	9989      	ldr	r1, [sp, #548]	; 0x224
    133e:	4682      	mov	sl, r0
    1340:	f8d8 0020 	ldr.w	r0, [r8, #32]
    1344:	f7ff fffe 	bl	0 <__aeabi_fmul>
    1348:	4601      	mov	r1, r0
    134a:	4650      	mov	r0, sl
    134c:	f7ff fffe 	bl	0 <__aeabi_fadd>
    1350:	998a      	ldr	r1, [sp, #552]	; 0x228
    1352:	4681      	mov	r9, r0
    1354:	f8d8 0024 	ldr.w	r0, [r8, #36]	; 0x24
    1358:	f7ff fffe 	bl	0 <__aeabi_fmul>
    135c:	4601      	mov	r1, r0
    135e:	4648      	mov	r0, r9
    1360:	f7ff fffe 	bl	0 <__aeabi_fadd>
    1364:	4631      	mov	r1, r6
    1366:	f7ff fffe 	bl	0 <__aeabi_fmul>
    136a:	4601      	mov	r1, r0
    136c:	4658      	mov	r0, fp
    136e:	f7ff fffe 	bl	0 <__aeabi_fadd>
    1372:	9933      	ldr	r1, [sp, #204]	; 0xcc
    1374:	f7ff fffe 	bl	0 <__aeabi_fadd>
    1378:	9b25      	ldr	r3, [sp, #148]	; 0x94
    137a:	6098      	str	r0, [r3, #8]
    137c:	9a2e      	ldr	r2, [sp, #184]	; 0xb8
    137e:	994a      	ldr	r1, [sp, #296]	; 0x128
    1380:	60d0      	str	r0, [r2, #12]
    1382:	f8d7 a018 	ldr.w	sl, [r7, #24]
    1386:	f8d7 901c 	ldr.w	r9, [r7, #28]
    138a:	4650      	mov	r0, sl
    138c:	f7ff fffe 	bl	0 <__aeabi_fmul>
    1390:	9934      	ldr	r1, [sp, #208]	; 0xd0
    1392:	4683      	mov	fp, r0
    1394:	4648      	mov	r0, r9
    1396:	f7ff fffe 	bl	0 <__aeabi_fmul>
    139a:	4601      	mov	r1, r0
    139c:	4658      	mov	r0, fp
    139e:	f7ff fffe 	bl	0 <__aeabi_fadd>
    13a2:	9935      	ldr	r1, [sp, #212]	; 0xd4
    13a4:	4683      	mov	fp, r0
    13a6:	6a38      	ldr	r0, [r7, #32]
    13a8:	f7ff fffe 	bl	0 <__aeabi_fmul>
    13ac:	4601      	mov	r1, r0
    13ae:	4658      	mov	r0, fp
    13b0:	f7ff fffe 	bl	0 <__aeabi_fadd>
    13b4:	993b      	ldr	r1, [sp, #236]	; 0xec
    13b6:	4683      	mov	fp, r0
    13b8:	6a78      	ldr	r0, [r7, #36]	; 0x24
    13ba:	f7ff fffe 	bl	0 <__aeabi_fmul>
    13be:	4601      	mov	r1, r0
    13c0:	4658      	mov	r0, fp
    13c2:	f7ff fffe 	bl	0 <__aeabi_fadd>
    13c6:	9913      	ldr	r1, [sp, #76]	; 0x4c
    13c8:	f7ff fffe 	bl	0 <__aeabi_fmul>
    13cc:	9987      	ldr	r1, [sp, #540]	; 0x21c
    13ce:	4683      	mov	fp, r0
    13d0:	4650      	mov	r0, sl
    13d2:	f7ff fffe 	bl	0 <__aeabi_fmul>
    13d6:	4601      	mov	r1, r0
    13d8:	9845      	ldr	r0, [sp, #276]	; 0x114
    13da:	f7ff fffe 	bl	0 <__aeabi_fadd>
    13de:	9988      	ldr	r1, [sp, #544]	; 0x220
    13e0:	4682      	mov	sl, r0
    13e2:	4648      	mov	r0, r9
    13e4:	f7ff fffe 	bl	0 <__aeabi_fmul>
    13e8:	4601      	mov	r1, r0
    13ea:	4650      	mov	r0, sl
    13ec:	f7ff fffe 	bl	0 <__aeabi_fadd>
    13f0:	9989      	ldr	r1, [sp, #548]	; 0x224
    13f2:	4682      	mov	sl, r0
    13f4:	6a38      	ldr	r0, [r7, #32]
    13f6:	f7ff fffe 	bl	0 <__aeabi_fmul>
    13fa:	4601      	mov	r1, r0
    13fc:	4650      	mov	r0, sl
    13fe:	f7ff fffe 	bl	0 <__aeabi_fadd>
    1402:	998a      	ldr	r1, [sp, #552]	; 0x228
    1404:	4681      	mov	r9, r0
    1406:	6a78      	ldr	r0, [r7, #36]	; 0x24
    1408:	f7ff fffe 	bl	0 <__aeabi_fmul>
    140c:	4601      	mov	r1, r0
    140e:	4648      	mov	r0, r9
    1410:	f7ff fffe 	bl	0 <__aeabi_fadd>
    1414:	4631      	mov	r1, r6
    1416:	f7ff fffe 	bl	0 <__aeabi_fmul>
    141a:	4601      	mov	r1, r0
    141c:	4658      	mov	r0, fp
    141e:	f7ff fffe 	bl	0 <__aeabi_fadd>
    1422:	9918      	ldr	r1, [sp, #96]	; 0x60
    1424:	f7ff fffe 	bl	0 <__aeabi_fadd>
    1428:	9930      	ldr	r1, [sp, #192]	; 0xc0
    142a:	6088      	str	r0, [r1, #8]
    142c:	9b2e      	ldr	r3, [sp, #184]	; 0xb8
    142e:	994a      	ldr	r1, [sp, #296]	; 0x128
    1430:	6118      	str	r0, [r3, #16]
    1432:	f8d4 a11c 	ldr.w	sl, [r4, #284]	; 0x11c
    1436:	f8d4 9120 	ldr.w	r9, [r4, #288]	; 0x120
    143a:	4650      	mov	r0, sl
    143c:	f7ff fffe 	bl	0 <__aeabi_fmul>
    1440:	9934      	ldr	r1, [sp, #208]	; 0xd0
    1442:	4683      	mov	fp, r0
    1444:	4648      	mov	r0, r9
    1446:	f7ff fffe 	bl	0 <__aeabi_fmul>
    144a:	4601      	mov	r1, r0
    144c:	4658      	mov	r0, fp
    144e:	f7ff fffe 	bl	0 <__aeabi_fadd>
    1452:	9935      	ldr	r1, [sp, #212]	; 0xd4
    1454:	4683      	mov	fp, r0
    1456:	f8d4 0124 	ldr.w	r0, [r4, #292]	; 0x124
    145a:	f7ff fffe 	bl	0 <__aeabi_fmul>
    145e:	4601      	mov	r1, r0
    1460:	4658      	mov	r0, fp
    1462:	f7ff fffe 	bl	0 <__aeabi_fadd>
    1466:	993b      	ldr	r1, [sp, #236]	; 0xec
    1468:	4683      	mov	fp, r0
    146a:	f8d4 0128 	ldr.w	r0, [r4, #296]	; 0x128
    146e:	f7ff fffe 	bl	0 <__aeabi_fmul>
    1472:	4601      	mov	r1, r0
    1474:	4658      	mov	r0, fp
    1476:	f7ff fffe 	bl	0 <__aeabi_fadd>
    147a:	9913      	ldr	r1, [sp, #76]	; 0x4c
    147c:	f7ff fffe 	bl	0 <__aeabi_fmul>
    1480:	9987      	ldr	r1, [sp, #540]	; 0x21c
    1482:	4683      	mov	fp, r0
    1484:	4650      	mov	r0, sl
    1486:	f7ff fffe 	bl	0 <__aeabi_fmul>
    148a:	4601      	mov	r1, r0
    148c:	984c      	ldr	r0, [sp, #304]	; 0x130
    148e:	f7ff fffe 	bl	0 <__aeabi_fadd>
    1492:	9988      	ldr	r1, [sp, #544]	; 0x220
    1494:	4682      	mov	sl, r0
    1496:	4648      	mov	r0, r9
    1498:	f7ff fffe 	bl	0 <__aeabi_fmul>
    149c:	4601      	mov	r1, r0
    149e:	4650      	mov	r0, sl
    14a0:	f7ff fffe 	bl	0 <__aeabi_fadd>
    14a4:	9989      	ldr	r1, [sp, #548]	; 0x224
    14a6:	4682      	mov	sl, r0
    14a8:	f8d4 0124 	ldr.w	r0, [r4, #292]	; 0x124
    14ac:	f7ff fffe 	bl	0 <__aeabi_fmul>
    14b0:	4601      	mov	r1, r0
    14b2:	4650      	mov	r0, sl
    14b4:	f7ff fffe 	bl	0 <__aeabi_fadd>
    14b8:	998a      	ldr	r1, [sp, #552]	; 0x228
    14ba:	4681      	mov	r9, r0
    14bc:	f8d4 0128 	ldr.w	r0, [r4, #296]	; 0x128
    14c0:	f7ff fffe 	bl	0 <__aeabi_fmul>
    14c4:	4601      	mov	r1, r0
    14c6:	4648      	mov	r0, r9
    14c8:	f7ff fffe 	bl	0 <__aeabi_fadd>
    14cc:	4631      	mov	r1, r6
    14ce:	f7ff fffe 	bl	0 <__aeabi_fmul>
    14d2:	4601      	mov	r1, r0
    14d4:	4658      	mov	r0, fp
    14d6:	f7ff fffe 	bl	0 <__aeabi_fadd>
    14da:	9986      	ldr	r1, [sp, #536]	; 0x218
    14dc:	f7ff fffe 	bl	0 <__aeabi_fadd>
    14e0:	f8c5 010c 	str.w	r0, [r5, #268]	; 0x10c
    14e4:	9a2e      	ldr	r2, [sp, #184]	; 0xb8
    14e6:	6150      	str	r0, [r2, #20]
    14e8:	f8d4 a154 	ldr.w	sl, [r4, #340]	; 0x154
    14ec:	99b2      	ldr	r1, [sp, #712]	; 0x2c8
    14ee:	98b4      	ldr	r0, [sp, #720]	; 0x2d0
    14f0:	f8dd c2cc 	ldr.w	ip, [sp, #716]	; 0x2cc
    14f4:	9141      	str	r1, [sp, #260]	; 0x104
    14f6:	9042      	str	r0, [sp, #264]	; 0x108
    14f8:	9934      	ldr	r1, [sp, #208]	; 0xd0
    14fa:	4650      	mov	r0, sl
    14fc:	f8cd c0f4 	str.w	ip, [sp, #244]	; 0xf4
    1500:	f7ff fffe 	bl	0 <__aeabi_fmul>
    1504:	f8d4 9158 	ldr.w	r9, [r4, #344]	; 0x158
    1508:	4683      	mov	fp, r0
    150a:	9935      	ldr	r1, [sp, #212]	; 0xd4
    150c:	4648      	mov	r0, r9
    150e:	f7ff fffe 	bl	0 <__aeabi_fmul>
    1512:	4601      	mov	r1, r0
    1514:	4658      	mov	r0, fp
    1516:	f7ff fffe 	bl	0 <__aeabi_fadd>
    151a:	993b      	ldr	r1, [sp, #236]	; 0xec
    151c:	4683      	mov	fp, r0
    151e:	f8d4 015c 	ldr.w	r0, [r4, #348]	; 0x15c
    1522:	f7ff fffe 	bl	0 <__aeabi_fmul>
    1526:	4601      	mov	r1, r0
    1528:	4658      	mov	r0, fp
    152a:	f7ff fffe 	bl	0 <__aeabi_fadd>
    152e:	9941      	ldr	r1, [sp, #260]	; 0x104
    1530:	4683      	mov	fp, r0
    1532:	f8d4 0160 	ldr.w	r0, [r4, #352]	; 0x160
    1536:	f7ff fffe 	bl	0 <__aeabi_fmul>
    153a:	4601      	mov	r1, r0
    153c:	4658      	mov	r0, fp
    153e:	f7ff fffe 	bl	0 <__aeabi_fadd>
    1542:	993d      	ldr	r1, [sp, #244]	; 0xf4
    1544:	4683      	mov	fp, r0
    1546:	f8d4 0164 	ldr.w	r0, [r4, #356]	; 0x164
    154a:	f7ff fffe 	bl	0 <__aeabi_fmul>
    154e:	4601      	mov	r1, r0
    1550:	4658      	mov	r0, fp
    1552:	f7ff fffe 	bl	0 <__aeabi_fadd>
    1556:	9942      	ldr	r1, [sp, #264]	; 0x108
    1558:	4683      	mov	fp, r0
    155a:	f8d4 0168 	ldr.w	r0, [r4, #360]	; 0x168
    155e:	f7ff fffe 	bl	0 <__aeabi_fmul>
    1562:	4601      	mov	r1, r0
    1564:	4658      	mov	r0, fp
    1566:	f7ff fffe 	bl	0 <__aeabi_fadd>
    156a:	9913      	ldr	r1, [sp, #76]	; 0x4c
    156c:	f7ff fffe 	bl	0 <__aeabi_fmul>
    1570:	9988      	ldr	r1, [sp, #544]	; 0x220
    1572:	4683      	mov	fp, r0
    1574:	4650      	mov	r0, sl
    1576:	f7ff fffe 	bl	0 <__aeabi_fmul>
    157a:	4601      	mov	r1, r0
    157c:	984a      	ldr	r0, [sp, #296]	; 0x128
    157e:	f7ff fffe 	bl	0 <__aeabi_fadd>
    1582:	9989      	ldr	r1, [sp, #548]	; 0x224
    1584:	4682      	mov	sl, r0
    1586:	4648      	mov	r0, r9
    1588:	f7ff fffe 	bl	0 <__aeabi_fmul>
    158c:	4601      	mov	r1, r0
    158e:	4650      	mov	r0, sl
    1590:	f7ff fffe 	bl	0 <__aeabi_fadd>
    1594:	998a      	ldr	r1, [sp, #552]	; 0x228
    1596:	4682      	mov	sl, r0
    1598:	f8d4 015c 	ldr.w	r0, [r4, #348]	; 0x15c
    159c:	f7ff fffe 	bl	0 <__aeabi_fmul>
    15a0:	4601      	mov	r1, r0
    15a2:	4650      	mov	r0, sl
    15a4:	f7ff fffe 	bl	0 <__aeabi_fadd>
    15a8:	998b      	ldr	r1, [sp, #556]	; 0x22c
    15aa:	4681      	mov	r9, r0
    15ac:	f8d4 0160 	ldr.w	r0, [r4, #352]	; 0x160
    15b0:	f7ff fffe 	bl	0 <__aeabi_fmul>
    15b4:	4601      	mov	r1, r0
    15b6:	4648      	mov	r0, r9
    15b8:	f7ff fffe 	bl	0 <__aeabi_fadd>
    15bc:	998c      	ldr	r1, [sp, #560]	; 0x230
    15be:	4682      	mov	sl, r0
    15c0:	f8d4 0164 	ldr.w	r0, [r4, #356]	; 0x164
    15c4:	f7ff fffe 	bl	0 <__aeabi_fmul>
    15c8:	4601      	mov	r1, r0
    15ca:	4650      	mov	r0, sl
    15cc:	f7ff fffe 	bl	0 <__aeabi_fadd>
    15d0:	998d      	ldr	r1, [sp, #564]	; 0x234
    15d2:	4681      	mov	r9, r0
    15d4:	f8d4 0168 	ldr.w	r0, [r4, #360]	; 0x168
    15d8:	f7ff fffe 	bl	0 <__aeabi_fmul>
    15dc:	4601      	mov	r1, r0
    15de:	4648      	mov	r0, r9
    15e0:	f7ff fffe 	bl	0 <__aeabi_fadd>
    15e4:	4631      	mov	r1, r6
    15e6:	f7ff fffe 	bl	0 <__aeabi_fmul>
    15ea:	4601      	mov	r1, r0
    15ec:	4658      	mov	r0, fp
    15ee:	f7ff fffe 	bl	0 <__aeabi_fadd>
    15f2:	9987      	ldr	r1, [sp, #540]	; 0x21c
    15f4:	f7ff fffe 	bl	0 <__aeabi_fadd>
    15f8:	f8c5 0140 	str.w	r0, [r5, #320]	; 0x140
    15fc:	9b2e      	ldr	r3, [sp, #184]	; 0xb8
    15fe:	994a      	ldr	r1, [sp, #296]	; 0x128
    1600:	6198      	str	r0, [r3, #24]
    1602:	f8d4 a184 	ldr.w	sl, [r4, #388]	; 0x184
    1606:	f8d4 918c 	ldr.w	r9, [r4, #396]	; 0x18c
    160a:	4650      	mov	r0, sl
    160c:	f7ff fffe 	bl	0 <__aeabi_fmul>
    1610:	9935      	ldr	r1, [sp, #212]	; 0xd4
    1612:	4683      	mov	fp, r0
    1614:	4648      	mov	r0, r9
    1616:	f7ff fffe 	bl	0 <__aeabi_fmul>
    161a:	4601      	mov	r1, r0
    161c:	4658      	mov	r0, fp
    161e:	f7ff fffe 	bl	0 <__aeabi_fadd>
    1622:	993b      	ldr	r1, [sp, #236]	; 0xec
    1624:	4683      	mov	fp, r0
    1626:	f8d4 0190 	ldr.w	r0, [r4, #400]	; 0x190
    162a:	f7ff fffe 	bl	0 <__aeabi_fmul>
    162e:	4601      	mov	r1, r0
    1630:	4658      	mov	r0, fp
    1632:	f7ff fffe 	bl	0 <__aeabi_fadd>
    1636:	9941      	ldr	r1, [sp, #260]	; 0x104
    1638:	4683      	mov	fp, r0
    163a:	f8d4 0194 	ldr.w	r0, [r4, #404]	; 0x194
    163e:	f7ff fffe 	bl	0 <__aeabi_fmul>
    1642:	4601      	mov	r1, r0
    1644:	4658      	mov	r0, fp
    1646:	f7ff fffe 	bl	0 <__aeabi_fadd>
    164a:	993d      	ldr	r1, [sp, #244]	; 0xf4
    164c:	4683      	mov	fp, r0
    164e:	f8d4 0198 	ldr.w	r0, [r4, #408]	; 0x198
    1652:	f7ff fffe 	bl	0 <__aeabi_fmul>
    1656:	4601      	mov	r1, r0
    1658:	4658      	mov	r0, fp
    165a:	f7ff fffe 	bl	0 <__aeabi_fadd>
    165e:	9942      	ldr	r1, [sp, #264]	; 0x108
    1660:	4683      	mov	fp, r0
    1662:	f8d4 019c 	ldr.w	r0, [r4, #412]	; 0x19c
    1666:	f7ff fffe 	bl	0 <__aeabi_fmul>
    166a:	4601      	mov	r1, r0
    166c:	4658      	mov	r0, fp
    166e:	f7ff fffe 	bl	0 <__aeabi_fadd>
    1672:	9913      	ldr	r1, [sp, #76]	; 0x4c
    1674:	f7ff fffe 	bl	0 <__aeabi_fmul>
    1678:	9987      	ldr	r1, [sp, #540]	; 0x21c
    167a:	4683      	mov	fp, r0
    167c:	4650      	mov	r0, sl
    167e:	f7ff fffe 	bl	0 <__aeabi_fmul>
    1682:	4601      	mov	r1, r0
    1684:	9834      	ldr	r0, [sp, #208]	; 0xd0
    1686:	f7ff fffe 	bl	0 <__aeabi_fadd>
    168a:	9989      	ldr	r1, [sp, #548]	; 0x224
    168c:	4682      	mov	sl, r0
    168e:	4648      	mov	r0, r9
    1690:	f7ff fffe 	bl	0 <__aeabi_fmul>
    1694:	4601      	mov	r1, r0
    1696:	4650      	mov	r0, sl
    1698:	f7ff fffe 	bl	0 <__aeabi_fadd>
    169c:	998a      	ldr	r1, [sp, #552]	; 0x228
    169e:	4682      	mov	sl, r0
    16a0:	f8d4 0190 	ldr.w	r0, [r4, #400]	; 0x190
    16a4:	f7ff fffe 	bl	0 <__aeabi_fmul>
    16a8:	4601      	mov	r1, r0
    16aa:	4650      	mov	r0, sl
    16ac:	f7ff fffe 	bl	0 <__aeabi_fadd>
    16b0:	998b      	ldr	r1, [sp, #556]	; 0x22c
    16b2:	4681      	mov	r9, r0
    16b4:	f8d4 0194 	ldr.w	r0, [r4, #404]	; 0x194
    16b8:	f7ff fffe 	bl	0 <__aeabi_fmul>
    16bc:	4601      	mov	r1, r0
    16be:	4648      	mov	r0, r9
    16c0:	f7ff fffe 	bl	0 <__aeabi_fadd>
    16c4:	998c      	ldr	r1, [sp, #560]	; 0x230
    16c6:	4682      	mov	sl, r0
    16c8:	f8d4 0198 	ldr.w	r0, [r4, #408]	; 0x198
    16cc:	f7ff fffe 	bl	0 <__aeabi_fmul>
    16d0:	4601      	mov	r1, r0
    16d2:	4650      	mov	r0, sl
    16d4:	f7ff fffe 	bl	0 <__aeabi_fadd>
    16d8:	998d      	ldr	r1, [sp, #564]	; 0x234
    16da:	4681      	mov	r9, r0
    16dc:	f8d4 019c 	ldr.w	r0, [r4, #412]	; 0x19c
    16e0:	f7ff fffe 	bl	0 <__aeabi_fmul>
    16e4:	4601      	mov	r1, r0
    16e6:	4648      	mov	r0, r9
    16e8:	f7ff fffe 	bl	0 <__aeabi_fadd>
    16ec:	4631      	mov	r1, r6
    16ee:	f7ff fffe 	bl	0 <__aeabi_fmul>
    16f2:	4601      	mov	r1, r0
    16f4:	4658      	mov	r0, fp
    16f6:	f7ff fffe 	bl	0 <__aeabi_fadd>
    16fa:	9988      	ldr	r1, [sp, #544]	; 0x220
    16fc:	f7ff fffe 	bl	0 <__aeabi_fadd>
    1700:	f8c5 0174 	str.w	r0, [r5, #372]	; 0x174
    1704:	9a2e      	ldr	r2, [sp, #184]	; 0xb8
    1706:	994a      	ldr	r1, [sp, #296]	; 0x128
    1708:	61d0      	str	r0, [r2, #28]
    170a:	f8d4 a1b8 	ldr.w	sl, [r4, #440]	; 0x1b8
    170e:	f8d4 91bc 	ldr.w	r9, [r4, #444]	; 0x1bc
    1712:	4650      	mov	r0, sl
    1714:	f7ff fffe 	bl	0 <__aeabi_fmul>
    1718:	9934      	ldr	r1, [sp, #208]	; 0xd0
    171a:	4683      	mov	fp, r0
    171c:	4648      	mov	r0, r9
    171e:	f7ff fffe 	bl	0 <__aeabi_fmul>
    1722:	4601      	mov	r1, r0
    1724:	4658      	mov	r0, fp
    1726:	f7ff fffe 	bl	0 <__aeabi_fadd>
    172a:	993b      	ldr	r1, [sp, #236]	; 0xec
    172c:	4683      	mov	fp, r0
    172e:	f8d4 01c4 	ldr.w	r0, [r4, #452]	; 0x1c4
    1732:	f7ff fffe 	bl	0 <__aeabi_fmul>
    1736:	4601      	mov	r1, r0
    1738:	4658      	mov	r0, fp
    173a:	f7ff fffe 	bl	0 <__aeabi_fadd>
    173e:	9941      	ldr	r1, [sp, #260]	; 0x104
    1740:	4683      	mov	fp, r0
    1742:	f8d4 01c8 	ldr.w	r0, [r4, #456]	; 0x1c8
    1746:	f7ff fffe 	bl	0 <__aeabi_fmul>
    174a:	4601      	mov	r1, r0
    174c:	4658      	mov	r0, fp
    174e:	f7ff fffe 	bl	0 <__aeabi_fadd>
    1752:	993d      	ldr	r1, [sp, #244]	; 0xf4
    1754:	4683      	mov	fp, r0
    1756:	f8d4 01cc 	ldr.w	r0, [r4, #460]	; 0x1cc
    175a:	f7ff fffe 	bl	0 <__aeabi_fmul>
    175e:	4601      	mov	r1, r0
    1760:	4658      	mov	r0, fp
    1762:	f7ff fffe 	bl	0 <__aeabi_fadd>
    1766:	9942      	ldr	r1, [sp, #264]	; 0x108
    1768:	4683      	mov	fp, r0
    176a:	f8d4 01d0 	ldr.w	r0, [r4, #464]	; 0x1d0
    176e:	f7ff fffe 	bl	0 <__aeabi_fmul>
    1772:	4601      	mov	r1, r0
    1774:	4658      	mov	r0, fp
    1776:	f7ff fffe 	bl	0 <__aeabi_fadd>
    177a:	9913      	ldr	r1, [sp, #76]	; 0x4c
    177c:	f7ff fffe 	bl	0 <__aeabi_fmul>
    1780:	9987      	ldr	r1, [sp, #540]	; 0x21c
    1782:	4683      	mov	fp, r0
    1784:	4650      	mov	r0, sl
    1786:	f7ff fffe 	bl	0 <__aeabi_fmul>
    178a:	4601      	mov	r1, r0
    178c:	9835      	ldr	r0, [sp, #212]	; 0xd4
    178e:	f7ff fffe 	bl	0 <__aeabi_fadd>
    1792:	9988      	ldr	r1, [sp, #544]	; 0x220
    1794:	4682      	mov	sl, r0
    1796:	4648      	mov	r0, r9
    1798:	f7ff fffe 	bl	0 <__aeabi_fmul>
    179c:	4601      	mov	r1, r0
    179e:	4650      	mov	r0, sl
    17a0:	f7ff fffe 	bl	0 <__aeabi_fadd>
    17a4:	998a      	ldr	r1, [sp, #552]	; 0x228
    17a6:	4682      	mov	sl, r0
    17a8:	f8d4 01c4 	ldr.w	r0, [r4, #452]	; 0x1c4
    17ac:	f7ff fffe 	bl	0 <__aeabi_fmul>
    17b0:	4601      	mov	r1, r0
    17b2:	4650      	mov	r0, sl
    17b4:	f7ff fffe 	bl	0 <__aeabi_fadd>
    17b8:	998b      	ldr	r1, [sp, #556]	; 0x22c
    17ba:	4681      	mov	r9, r0
    17bc:	f8d4 01c8 	ldr.w	r0, [r4, #456]	; 0x1c8
    17c0:	f7ff fffe 	bl	0 <__aeabi_fmul>
    17c4:	4601      	mov	r1, r0
    17c6:	4648      	mov	r0, r9
    17c8:	f7ff fffe 	bl	0 <__aeabi_fadd>
    17cc:	998c      	ldr	r1, [sp, #560]	; 0x230
    17ce:	4682      	mov	sl, r0
    17d0:	f8d4 01cc 	ldr.w	r0, [r4, #460]	; 0x1cc
    17d4:	f7ff fffe 	bl	0 <__aeabi_fmul>
    17d8:	4601      	mov	r1, r0
    17da:	4650      	mov	r0, sl
    17dc:	f7ff fffe 	bl	0 <__aeabi_fadd>
    17e0:	998d      	ldr	r1, [sp, #564]	; 0x234
    17e2:	4681      	mov	r9, r0
    17e4:	f8d4 01d0 	ldr.w	r0, [r4, #464]	; 0x1d0
    17e8:	f7ff fffe 	bl	0 <__aeabi_fmul>
    17ec:	4601      	mov	r1, r0
    17ee:	4648      	mov	r0, r9
    17f0:	f7ff fffe 	bl	0 <__aeabi_fadd>
    17f4:	4631      	mov	r1, r6
    17f6:	f7ff fffe 	bl	0 <__aeabi_fmul>
    17fa:	4601      	mov	r1, r0
    17fc:	4658      	mov	r0, fp
    17fe:	f7ff fffe 	bl	0 <__aeabi_fadd>
    1802:	9989      	ldr	r1, [sp, #548]	; 0x224
    1804:	f7ff fffe 	bl	0 <__aeabi_fadd>
    1808:	f8c5 01a8 	str.w	r0, [r5, #424]	; 0x1a8
    180c:	992e      	ldr	r1, [sp, #184]	; 0xb8
    180e:	6208      	str	r0, [r1, #32]
    1810:	f8d4 a1ec 	ldr.w	sl, [r4, #492]	; 0x1ec
    1814:	994a      	ldr	r1, [sp, #296]	; 0x128
    1816:	4650      	mov	r0, sl
    1818:	f7ff fffe 	bl	0 <__aeabi_fmul>
    181c:	f8d4 91f0 	ldr.w	r9, [r4, #496]	; 0x1f0
    1820:	4683      	mov	fp, r0
    1822:	9934      	ldr	r1, [sp, #208]	; 0xd0
    1824:	4648      	mov	r0, r9
    1826:	f7ff fffe 	bl	0 <__aeabi_fmul>
    182a:	4601      	mov	r1, r0
    182c:	4658      	mov	r0, fp
    182e:	f7ff fffe 	bl	0 <__aeabi_fadd>
    1832:	9935      	ldr	r1, [sp, #212]	; 0xd4
    1834:	4683      	mov	fp, r0
    1836:	f8d4 01f4 	ldr.w	r0, [r4, #500]	; 0x1f4
    183a:	f7ff fffe 	bl	0 <__aeabi_fmul>
    183e:	4601      	mov	r1, r0
    1840:	4658      	mov	r0, fp
    1842:	f7ff fffe 	bl	0 <__aeabi_fadd>
    1846:	9941      	ldr	r1, [sp, #260]	; 0x104
    1848:	4683      	mov	fp, r0
    184a:	f8d4 01fc 	ldr.w	r0, [r4, #508]	; 0x1fc
    184e:	f7ff fffe 	bl	0 <__aeabi_fmul>
    1852:	4601      	mov	r1, r0
    1854:	4658      	mov	r0, fp
    1856:	f7ff fffe 	bl	0 <__aeabi_fadd>
    185a:	993d      	ldr	r1, [sp, #244]	; 0xf4
    185c:	4683      	mov	fp, r0
    185e:	f8d4 0200 	ldr.w	r0, [r4, #512]	; 0x200
    1862:	f7ff fffe 	bl	0 <__aeabi_fmul>
    1866:	4601      	mov	r1, r0
    1868:	4658      	mov	r0, fp
    186a:	f7ff fffe 	bl	0 <__aeabi_fadd>
    186e:	9942      	ldr	r1, [sp, #264]	; 0x108
    1870:	4683      	mov	fp, r0
    1872:	f8d4 0204 	ldr.w	r0, [r4, #516]	; 0x204
    1876:	f7ff fffe 	bl	0 <__aeabi_fmul>
    187a:	4601      	mov	r1, r0
    187c:	4658      	mov	r0, fp
    187e:	f7ff fffe 	bl	0 <__aeabi_fadd>
    1882:	9913      	ldr	r1, [sp, #76]	; 0x4c
    1884:	f7ff fffe 	bl	0 <__aeabi_fmul>
    1888:	9987      	ldr	r1, [sp, #540]	; 0x21c
    188a:	4683      	mov	fp, r0
    188c:	4650      	mov	r0, sl
    188e:	f7ff fffe 	bl	0 <__aeabi_fmul>
    1892:	4601      	mov	r1, r0
    1894:	983b      	ldr	r0, [sp, #236]	; 0xec
    1896:	f7ff fffe 	bl	0 <__aeabi_fadd>
    189a:	9988      	ldr	r1, [sp, #544]	; 0x220
    189c:	4682      	mov	sl, r0
    189e:	4648      	mov	r0, r9
    18a0:	f7ff fffe 	bl	0 <__aeabi_fmul>
    18a4:	4601      	mov	r1, r0
    18a6:	4650      	mov	r0, sl
    18a8:	f7ff fffe 	bl	0 <__aeabi_fadd>
    18ac:	9989      	ldr	r1, [sp, #548]	; 0x224
    18ae:	4681      	mov	r9, r0
    18b0:	f8d4 01f4 	ldr.w	r0, [r4, #500]	; 0x1f4
    18b4:	f7ff fffe 	bl	0 <__aeabi_fmul>
    18b8:	4601      	mov	r1, r0
    18ba:	4648      	mov	r0, r9
    18bc:	f7ff fffe 	bl	0 <__aeabi_fadd>
    18c0:	998b      	ldr	r1, [sp, #556]	; 0x22c
    18c2:	4682      	mov	sl, r0
    18c4:	f8d4 01fc 	ldr.w	r0, [r4, #508]	; 0x1fc
    18c8:	f7ff fffe 	bl	0 <__aeabi_fmul>
    18cc:	4601      	mov	r1, r0
    18ce:	4650      	mov	r0, sl
    18d0:	f7ff fffe 	bl	0 <__aeabi_fadd>
    18d4:	998c      	ldr	r1, [sp, #560]	; 0x230
    18d6:	4681      	mov	r9, r0
    18d8:	f8d4 0200 	ldr.w	r0, [r4, #512]	; 0x200
    18dc:	f7ff fffe 	bl	0 <__aeabi_fmul>
    18e0:	4601      	mov	r1, r0
    18e2:	4648      	mov	r0, r9
    18e4:	f7ff fffe 	bl	0 <__aeabi_fadd>
    18e8:	998d      	ldr	r1, [sp, #564]	; 0x234
    18ea:	4682      	mov	sl, r0
    18ec:	f8d4 0204 	ldr.w	r0, [r4, #516]	; 0x204
    18f0:	f7ff fffe 	bl	0 <__aeabi_fmul>
    18f4:	4601      	mov	r1, r0
    18f6:	4650      	mov	r0, sl
    18f8:	f7ff fffe 	bl	0 <__aeabi_fadd>
    18fc:	4631      	mov	r1, r6
    18fe:	f7ff fffe 	bl	0 <__aeabi_fmul>
    1902:	4601      	mov	r1, r0
    1904:	4658      	mov	r0, fp
    1906:	f7ff fffe 	bl	0 <__aeabi_fadd>
    190a:	998a      	ldr	r1, [sp, #552]	; 0x228
    190c:	f7ff fffe 	bl	0 <__aeabi_fadd>
    1910:	f8c5 01dc 	str.w	r0, [r5, #476]	; 0x1dc
    1914:	9b2e      	ldr	r3, [sp, #184]	; 0xb8
    1916:	4631      	mov	r1, r6
    1918:	6258      	str	r0, [r3, #36]	; 0x24
    191a:	9841      	ldr	r0, [sp, #260]	; 0x104
    191c:	f7ff fffe 	bl	0 <__aeabi_fmul>
    1920:	998b      	ldr	r1, [sp, #556]	; 0x22c
    1922:	f7ff fffe 	bl	0 <__aeabi_fadd>
    1926:	9a2e      	ldr	r2, [sp, #184]	; 0xb8
    1928:	f8c5 0210 	str.w	r0, [r5, #528]	; 0x210
    192c:	4631      	mov	r1, r6
    192e:	6290      	str	r0, [r2, #40]	; 0x28
    1930:	983d      	ldr	r0, [sp, #244]	; 0xf4
    1932:	f7ff fffe 	bl	0 <__aeabi_fmul>
    1936:	998c      	ldr	r1, [sp, #560]	; 0x230
    1938:	f7ff fffe 	bl	0 <__aeabi_fadd>
    193c:	992e      	ldr	r1, [sp, #184]	; 0xb8
    193e:	f8c5 0244 	str.w	r0, [r5, #580]	; 0x244
    1942:	62c8      	str	r0, [r1, #44]	; 0x2c
    1944:	9842      	ldr	r0, [sp, #264]	; 0x108
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
    1a46:	f7ff fffe 	bl	0 <__aeabi_fadd>
    1a4a:	9026      	str	r0, [sp, #152]	; 0x98
    1a4c:	992e      	ldr	r1, [sp, #184]	; 0xb8
    1a4e:	4648      	mov	r0, r9
    1a50:	f7ff fffe 	bl	0 <__aeabi_fmul>
    1a54:	f8dd c35c 	ldr.w	ip, [sp, #860]	; 0x35c
    1a58:	905d      	str	r0, [sp, #372]	; 0x174
    1a5a:	4661      	mov	r1, ip
    1a5c:	9816      	ldr	r0, [sp, #88]	; 0x58
    1a5e:	f8cd c160 	str.w	ip, [sp, #352]	; 0x160
    1a62:	f7ff fffe 	bl	0 <__aeabi_fmul>
    1a66:	9920      	ldr	r1, [sp, #128]	; 0x80
    1a68:	9050      	str	r0, [sp, #320]	; 0x140
    1a6a:	4650      	mov	r0, sl
    1a6c:	f7ff fffe 	bl	0 <__aeabi_fmul>
    1a70:	991d      	ldr	r1, [sp, #116]	; 0x74
    1a72:	9046      	str	r0, [sp, #280]	; 0x118
    1a74:	9815      	ldr	r0, [sp, #84]	; 0x54
    1a76:	f7ff fffe 	bl	0 <__aeabi_fmul>
    1a7a:	995d      	ldr	r1, [sp, #372]	; 0x174
    1a7c:	f7ff fffe 	bl	0 <__aeabi_fadd>
    1a80:	9950      	ldr	r1, [sp, #320]	; 0x140
    1a82:	f7ff fffe 	bl	0 <__aeabi_fadd>
    1a86:	9946      	ldr	r1, [sp, #280]	; 0x118
    1a88:	f7ff fffe 	bl	0 <__aeabi_fadd>
    1a8c:	9a19      	ldr	r2, [sp, #100]	; 0x64
    1a8e:	9038      	str	r0, [sp, #224]	; 0xe0
    1a90:	68d1      	ldr	r1, [r2, #12]
    1a92:	f8db 000c 	ldr.w	r0, [fp, #12]
    1a96:	f7ff fffe 	bl	0 <__aeabi_fmul>
    1a9a:	f8db 100c 	ldr.w	r1, [fp, #12]
    1a9e:	f7ff fffe 	bl	0 <__aeabi_fmul>
    1aa2:	9919      	ldr	r1, [sp, #100]	; 0x64
    1aa4:	4603      	mov	r3, r0
    1aa6:	6909      	ldr	r1, [r1, #16]
    1aa8:	f8db 0010 	ldr.w	r0, [fp, #16]
    1aac:	9302      	str	r3, [sp, #8]
    1aae:	f7ff fffe 	bl	0 <__aeabi_fmul>
    1ab2:	f8db 1010 	ldr.w	r1, [fp, #16]
    1ab6:	f7ff fffe 	bl	0 <__aeabi_fmul>
    1aba:	9a02      	ldr	r2, [sp, #8]
    1abc:	4601      	mov	r1, r0
    1abe:	4610      	mov	r0, r2
    1ac0:	f7ff fffe 	bl	0 <__aeabi_fadd>
    1ac4:	9919      	ldr	r1, [sp, #100]	; 0x64
    1ac6:	4603      	mov	r3, r0
    1ac8:	6949      	ldr	r1, [r1, #20]
    1aca:	f8db 0014 	ldr.w	r0, [fp, #20]
    1ace:	9302      	str	r3, [sp, #8]
    1ad0:	f7ff fffe 	bl	0 <__aeabi_fmul>
    1ad4:	f8db 1014 	ldr.w	r1, [fp, #20]
    1ad8:	f7ff fffe 	bl	0 <__aeabi_fmul>
    1adc:	4601      	mov	r1, r0
    1ade:	9802      	ldr	r0, [sp, #8]
    1ae0:	f7ff fffe 	bl	0 <__aeabi_fadd>
    1ae4:	992f      	ldr	r1, [sp, #188]	; 0xbc
    1ae6:	4603      	mov	r3, r0
    1ae8:	4650      	mov	r0, sl
    1aea:	9302      	str	r3, [sp, #8]
    1aec:	f7ff fffe 	bl	0 <__aeabi_fmul>
    1af0:	9a02      	ldr	r2, [sp, #8]
    1af2:	4601      	mov	r1, r0
    1af4:	4610      	mov	r0, r2
    1af6:	f7ff fffe 	bl	0 <__aeabi_fadd>
    1afa:	9914      	ldr	r1, [sp, #80]	; 0x50
    1afc:	4603      	mov	r3, r0
    1afe:	9815      	ldr	r0, [sp, #84]	; 0x54
    1b00:	9302      	str	r3, [sp, #8]
    1b02:	f7ff fffe 	bl	0 <__aeabi_fmul>
    1b06:	4601      	mov	r1, r0
    1b08:	9802      	ldr	r0, [sp, #8]
    1b0a:	f7ff fffe 	bl	0 <__aeabi_fadd>
    1b0e:	9926      	ldr	r1, [sp, #152]	; 0x98
    1b10:	4602      	mov	r2, r0
    1b12:	4648      	mov	r0, r9
    1b14:	9202      	str	r2, [sp, #8]
    1b16:	f7ff fffe 	bl	0 <__aeabi_fmul>
    1b1a:	9b02      	ldr	r3, [sp, #8]
    1b1c:	4601      	mov	r1, r0
    1b1e:	4618      	mov	r0, r3
    1b20:	f7ff fffe 	bl	0 <__aeabi_fadd>
    1b24:	9938      	ldr	r1, [sp, #224]	; 0xe0
    1b26:	4602      	mov	r2, r0
    1b28:	9816      	ldr	r0, [sp, #88]	; 0x58
    1b2a:	9202      	str	r2, [sp, #8]
    1b2c:	f7ff fffe 	bl	0 <__aeabi_fmul>
    1b30:	4601      	mov	r1, r0
    1b32:	9802      	ldr	r0, [sp, #8]
    1b34:	f7ff fffe 	bl	0 <__aeabi_fadd>
    1b38:	9913      	ldr	r1, [sp, #76]	; 0x4c
    1b3a:	f7ff fffe 	bl	0 <__aeabi_fmul>
    1b3e:	4603      	mov	r3, r0
    1b40:	9815      	ldr	r0, [sp, #84]	; 0x54
    1b42:	9303      	str	r3, [sp, #12]
    1b44:	4601      	mov	r1, r0
    1b46:	f7ff fffe 	bl	0 <__aeabi_fadd>
    1b4a:	992b      	ldr	r1, [sp, #172]	; 0xac
    1b4c:	f7ff fffe 	bl	0 <__aeabi_fmul>
    1b50:	4649      	mov	r1, r9
    1b52:	4602      	mov	r2, r0
    1b54:	4648      	mov	r0, r9
    1b56:	9202      	str	r2, [sp, #8]
    1b58:	f7ff fffe 	bl	0 <__aeabi_fadd>
    1b5c:	9921      	ldr	r1, [sp, #132]	; 0x84
    1b5e:	f7ff fffe 	bl	0 <__aeabi_fmul>
    1b62:	9b02      	ldr	r3, [sp, #8]
    1b64:	4601      	mov	r1, r0
    1b66:	4618      	mov	r0, r3
    1b68:	f7ff fffe 	bl	0 <__aeabi_fadd>
    1b6c:	4602      	mov	r2, r0
    1b6e:	9816      	ldr	r0, [sp, #88]	; 0x58
    1b70:	9202      	str	r2, [sp, #8]
    1b72:	4601      	mov	r1, r0
    1b74:	f7ff fffe 	bl	0 <__aeabi_fadd>
    1b78:	992d      	ldr	r1, [sp, #180]	; 0xb4
    1b7a:	f7ff fffe 	bl	0 <__aeabi_fmul>
    1b7e:	4601      	mov	r1, r0
    1b80:	9802      	ldr	r0, [sp, #8]
    1b82:	f7ff fffe 	bl	0 <__aeabi_fadd>
    1b86:	4651      	mov	r1, sl
    1b88:	4603      	mov	r3, r0
    1b8a:	4650      	mov	r0, sl
    1b8c:	9302      	str	r3, [sp, #8]
    1b8e:	f7ff fffe 	bl	0 <__aeabi_fadd>
    1b92:	9912      	ldr	r1, [sp, #72]	; 0x48
    1b94:	f7ff fffe 	bl	0 <__aeabi_fmul>
    1b98:	9a02      	ldr	r2, [sp, #8]
    1b9a:	4601      	mov	r1, r0
    1b9c:	4610      	mov	r0, r2
    1b9e:	f7ff fffe 	bl	0 <__aeabi_fadd>
    1ba2:	4631      	mov	r1, r6
    1ba4:	f7ff fffe 	bl	0 <__aeabi_fmul>
    1ba8:	4601      	mov	r1, r0
    1baa:	9803      	ldr	r0, [sp, #12]
    1bac:	f7ff fffe 	bl	0 <__aeabi_fadd>
    1bb0:	f8dd c004 	ldr.w	ip, [sp, #4]
    1bb4:	4661      	mov	r1, ip
    1bb6:	f7ff fffe 	bl	0 <__aeabi_fadd>
    1bba:	9b25      	ldr	r3, [sp, #148]	; 0x94
    1bbc:	991f      	ldr	r1, [sp, #124]	; 0x7c
    1bbe:	60d8      	str	r0, [r3, #12]
    1bc0:	f8d7 c024 	ldr.w	ip, [r7, #36]	; 0x24
    1bc4:	3190      	adds	r1, #144	; 0x90
    1bc6:	4660      	mov	r0, ip
    1bc8:	9131      	str	r1, [sp, #196]	; 0xc4
    1bca:	992f      	ldr	r1, [sp, #188]	; 0xbc
    1bcc:	f8cd c004 	str.w	ip, [sp, #4]
    1bd0:	f7ff fffe 	bl	0 <__aeabi_fmul>
    1bd4:	9914      	ldr	r1, [sp, #80]	; 0x50
    1bd6:	4602      	mov	r2, r0
    1bd8:	69b8      	ldr	r0, [r7, #24]
    1bda:	9202      	str	r2, [sp, #8]
    1bdc:	f7ff fffe 	bl	0 <__aeabi_fmul>
    1be0:	4601      	mov	r1, r0
    1be2:	9802      	ldr	r0, [sp, #8]
    1be4:	f7ff fffe 	bl	0 <__aeabi_fadd>
    1be8:	9926      	ldr	r1, [sp, #152]	; 0x98
    1bea:	4603      	mov	r3, r0
    1bec:	69f8      	ldr	r0, [r7, #28]
    1bee:	9302      	str	r3, [sp, #8]
    1bf0:	f7ff fffe 	bl	0 <__aeabi_fmul>
    1bf4:	9a02      	ldr	r2, [sp, #8]
    1bf6:	4601      	mov	r1, r0
    1bf8:	4610      	mov	r0, r2
    1bfa:	f7ff fffe 	bl	0 <__aeabi_fadd>
    1bfe:	9938      	ldr	r1, [sp, #224]	; 0xe0
    1c00:	4603      	mov	r3, r0
    1c02:	6a38      	ldr	r0, [r7, #32]
    1c04:	9302      	str	r3, [sp, #8]
    1c06:	f7ff fffe 	bl	0 <__aeabi_fmul>
    1c0a:	4601      	mov	r1, r0
    1c0c:	9802      	ldr	r0, [sp, #8]
    1c0e:	f7ff fffe 	bl	0 <__aeabi_fadd>
    1c12:	9a31      	ldr	r2, [sp, #196]	; 0xc4
    1c14:	4603      	mov	r3, r0
    1c16:	68d1      	ldr	r1, [r2, #12]
    1c18:	f8db 000c 	ldr.w	r0, [fp, #12]
    1c1c:	9302      	str	r3, [sp, #8]
    1c1e:	f7ff fffe 	bl	0 <__aeabi_fmul>
    1c22:	9919      	ldr	r1, [sp, #100]	; 0x64
    1c24:	68c9      	ldr	r1, [r1, #12]
    1c26:	f7ff fffe 	bl	0 <__aeabi_fmul>
    1c2a:	4601      	mov	r1, r0
    1c2c:	9802      	ldr	r0, [sp, #8]
    1c2e:	f7ff fffe 	bl	0 <__aeabi_fadd>
    1c32:	9a31      	ldr	r2, [sp, #196]	; 0xc4
    1c34:	4603      	mov	r3, r0
    1c36:	6911      	ldr	r1, [r2, #16]
    1c38:	f8db 0010 	ldr.w	r0, [fp, #16]
    1c3c:	9302      	str	r3, [sp, #8]
    1c3e:	f7ff fffe 	bl	0 <__aeabi_fmul>
    1c42:	9919      	ldr	r1, [sp, #100]	; 0x64
    1c44:	6909      	ldr	r1, [r1, #16]
    1c46:	f7ff fffe 	bl	0 <__aeabi_fmul>
    1c4a:	4601      	mov	r1, r0
    1c4c:	9802      	ldr	r0, [sp, #8]
    1c4e:	f7ff fffe 	bl	0 <__aeabi_fadd>
    1c52:	9a31      	ldr	r2, [sp, #196]	; 0xc4
    1c54:	4603      	mov	r3, r0
    1c56:	6951      	ldr	r1, [r2, #20]
    1c58:	f8db 0014 	ldr.w	r0, [fp, #20]
    1c5c:	9302      	str	r3, [sp, #8]
    1c5e:	f7ff fffe 	bl	0 <__aeabi_fmul>
    1c62:	9919      	ldr	r1, [sp, #100]	; 0x64
    1c64:	6949      	ldr	r1, [r1, #20]
    1c66:	f7ff fffe 	bl	0 <__aeabi_fmul>
    1c6a:	4601      	mov	r1, r0
    1c6c:	9802      	ldr	r0, [sp, #8]
    1c6e:	f7ff fffe 	bl	0 <__aeabi_fadd>
    1c72:	9913      	ldr	r1, [sp, #76]	; 0x4c
    1c74:	f7ff fffe 	bl	0 <__aeabi_fmul>
    1c78:	991c      	ldr	r1, [sp, #112]	; 0x70
    1c7a:	4602      	mov	r2, r0
    1c7c:	9815      	ldr	r0, [sp, #84]	; 0x54
    1c7e:	9203      	str	r2, [sp, #12]
    1c80:	f7ff fffe 	bl	0 <__aeabi_fmul>
    1c84:	992b      	ldr	r1, [sp, #172]	; 0xac
    1c86:	4603      	mov	r3, r0
    1c88:	69b8      	ldr	r0, [r7, #24]
    1c8a:	9302      	str	r3, [sp, #8]
    1c8c:	f7ff fffe 	bl	0 <__aeabi_fmul>
    1c90:	9a02      	ldr	r2, [sp, #8]
    1c92:	4601      	mov	r1, r0
    1c94:	4610      	mov	r0, r2
    1c96:	f7ff fffe 	bl	0 <__aeabi_fadd>
    1c9a:	9924      	ldr	r1, [sp, #144]	; 0x90
    1c9c:	4603      	mov	r3, r0
    1c9e:	4648      	mov	r0, r9
    1ca0:	9302      	str	r3, [sp, #8]
    1ca2:	f7ff fffe 	bl	0 <__aeabi_fmul>
    1ca6:	4601      	mov	r1, r0
    1ca8:	9802      	ldr	r0, [sp, #8]
    1caa:	f7ff fffe 	bl	0 <__aeabi_fadd>
    1cae:	9921      	ldr	r1, [sp, #132]	; 0x84
    1cb0:	4602      	mov	r2, r0
    1cb2:	69f8      	ldr	r0, [r7, #28]
    1cb4:	9202      	str	r2, [sp, #8]
    1cb6:	f7ff fffe 	bl	0 <__aeabi_fmul>
    1cba:	9b02      	ldr	r3, [sp, #8]
    1cbc:	4601      	mov	r1, r0
    1cbe:	4618      	mov	r0, r3
    1cc0:	f7ff fffe 	bl	0 <__aeabi_fadd>
    1cc4:	993e      	ldr	r1, [sp, #248]	; 0xf8
    1cc6:	4602      	mov	r2, r0
    1cc8:	9816      	ldr	r0, [sp, #88]	; 0x58
    1cca:	9202      	str	r2, [sp, #8]
    1ccc:	f7ff fffe 	bl	0 <__aeabi_fmul>
    1cd0:	4601      	mov	r1, r0
    1cd2:	9802      	ldr	r0, [sp, #8]
    1cd4:	f7ff fffe 	bl	0 <__aeabi_fadd>
    1cd8:	992d      	ldr	r1, [sp, #180]	; 0xb4
    1cda:	4603      	mov	r3, r0
    1cdc:	6a38      	ldr	r0, [r7, #32]
    1cde:	9302      	str	r3, [sp, #8]
    1ce0:	f7ff fffe 	bl	0 <__aeabi_fmul>
    1ce4:	9a02      	ldr	r2, [sp, #8]
    1ce6:	4601      	mov	r1, r0
    1ce8:	4610      	mov	r0, r2
    1cea:	f7ff fffe 	bl	0 <__aeabi_fadd>
    1cee:	993f      	ldr	r1, [sp, #252]	; 0xfc
    1cf0:	4603      	mov	r3, r0
    1cf2:	4650      	mov	r0, sl
    1cf4:	9302      	str	r3, [sp, #8]
    1cf6:	f7ff fffe 	bl	0 <__aeabi_fmul>
    1cfa:	4601      	mov	r1, r0
    1cfc:	9802      	ldr	r0, [sp, #8]
    1cfe:	f7ff fffe 	bl	0 <__aeabi_fadd>
    1d02:	f8dd c004 	ldr.w	ip, [sp, #4]
    1d06:	4602      	mov	r2, r0
    1d08:	9912      	ldr	r1, [sp, #72]	; 0x48
    1d0a:	4660      	mov	r0, ip
    1d0c:	9202      	str	r2, [sp, #8]
    1d0e:	f7ff fffe 	bl	0 <__aeabi_fmul>
    1d12:	9b02      	ldr	r3, [sp, #8]
    1d14:	4601      	mov	r1, r0
    1d16:	4618      	mov	r0, r3
    1d18:	f7ff fffe 	bl	0 <__aeabi_fadd>
    1d1c:	4631      	mov	r1, r6
    1d1e:	f7ff fffe 	bl	0 <__aeabi_fmul>
    1d22:	4601      	mov	r1, r0
    1d24:	9803      	ldr	r0, [sp, #12]
    1d26:	f7ff fffe 	bl	0 <__aeabi_fadd>
    1d2a:	9940      	ldr	r1, [sp, #256]	; 0x100
    1d2c:	f7ff fffe 	bl	0 <__aeabi_fadd>
    1d30:	9a30      	ldr	r2, [sp, #192]	; 0xc0
    1d32:	60d0      	str	r0, [r2, #12]
    1d34:	9b25      	ldr	r3, [sp, #148]	; 0x94
    1d36:	991f      	ldr	r1, [sp, #124]	; 0x7c
    1d38:	6118      	str	r0, [r3, #16]
    1d3a:	f8d4 c128 	ldr.w	ip, [r4, #296]	; 0x128
    1d3e:	31b4      	adds	r1, #180	; 0xb4
    1d40:	4660      	mov	r0, ip
    1d42:	9143      	str	r1, [sp, #268]	; 0x10c
    1d44:	992f      	ldr	r1, [sp, #188]	; 0xbc
    1d46:	f8cd c004 	str.w	ip, [sp, #4]
    1d4a:	f7ff fffe 	bl	0 <__aeabi_fmul>
    1d4e:	9914      	ldr	r1, [sp, #80]	; 0x50
    1d50:	4602      	mov	r2, r0
    1d52:	f8d4 011c 	ldr.w	r0, [r4, #284]	; 0x11c
    1d56:	9202      	str	r2, [sp, #8]
    1d58:	f7ff fffe 	bl	0 <__aeabi_fmul>
    1d5c:	4601      	mov	r1, r0
    1d5e:	9802      	ldr	r0, [sp, #8]
    1d60:	f7ff fffe 	bl	0 <__aeabi_fadd>
    1d64:	9926      	ldr	r1, [sp, #152]	; 0x98
    1d66:	4603      	mov	r3, r0
    1d68:	f8d4 0120 	ldr.w	r0, [r4, #288]	; 0x120
    1d6c:	9302      	str	r3, [sp, #8]
    1d6e:	f7ff fffe 	bl	0 <__aeabi_fmul>
    1d72:	9a02      	ldr	r2, [sp, #8]
    1d74:	4601      	mov	r1, r0
    1d76:	4610      	mov	r0, r2
    1d78:	f7ff fffe 	bl	0 <__aeabi_fadd>
    1d7c:	9938      	ldr	r1, [sp, #224]	; 0xe0
    1d7e:	4603      	mov	r3, r0
    1d80:	f8d4 0124 	ldr.w	r0, [r4, #292]	; 0x124
    1d84:	9302      	str	r3, [sp, #8]
    1d86:	f7ff fffe 	bl	0 <__aeabi_fmul>
    1d8a:	4601      	mov	r1, r0
    1d8c:	9802      	ldr	r0, [sp, #8]
    1d8e:	f7ff fffe 	bl	0 <__aeabi_fadd>
    1d92:	9a43      	ldr	r2, [sp, #268]	; 0x10c
    1d94:	4603      	mov	r3, r0
    1d96:	68d1      	ldr	r1, [r2, #12]
    1d98:	f8db 000c 	ldr.w	r0, [fp, #12]
    1d9c:	9302      	str	r3, [sp, #8]
    1d9e:	f7ff fffe 	bl	0 <__aeabi_fmul>
    1da2:	9919      	ldr	r1, [sp, #100]	; 0x64
    1da4:	68c9      	ldr	r1, [r1, #12]
    1da6:	f7ff fffe 	bl	0 <__aeabi_fmul>
    1daa:	4601      	mov	r1, r0
    1dac:	9802      	ldr	r0, [sp, #8]
    1dae:	f7ff fffe 	bl	0 <__aeabi_fadd>
    1db2:	9a43      	ldr	r2, [sp, #268]	; 0x10c
    1db4:	4603      	mov	r3, r0
    1db6:	6911      	ldr	r1, [r2, #16]
    1db8:	f8db 0010 	ldr.w	r0, [fp, #16]
    1dbc:	9302      	str	r3, [sp, #8]
    1dbe:	f7ff fffe 	bl	0 <__aeabi_fmul>
    1dc2:	9919      	ldr	r1, [sp, #100]	; 0x64
    1dc4:	6909      	ldr	r1, [r1, #16]
    1dc6:	f7ff fffe 	bl	0 <__aeabi_fmul>
    1dca:	4601      	mov	r1, r0
    1dcc:	9802      	ldr	r0, [sp, #8]
    1dce:	f7ff fffe 	bl	0 <__aeabi_fadd>
    1dd2:	9a43      	ldr	r2, [sp, #268]	; 0x10c
    1dd4:	4603      	mov	r3, r0
    1dd6:	6951      	ldr	r1, [r2, #20]
    1dd8:	f8db 0014 	ldr.w	r0, [fp, #20]
    1ddc:	9302      	str	r3, [sp, #8]
    1dde:	f7ff fffe 	bl	0 <__aeabi_fmul>
    1de2:	9919      	ldr	r1, [sp, #100]	; 0x64
    1de4:	6949      	ldr	r1, [r1, #20]
    1de6:	f7ff fffe 	bl	0 <__aeabi_fmul>
    1dea:	4601      	mov	r1, r0
    1dec:	9802      	ldr	r0, [sp, #8]
    1dee:	f7ff fffe 	bl	0 <__aeabi_fadd>
    1df2:	9913      	ldr	r1, [sp, #76]	; 0x4c
    1df4:	f7ff fffe 	bl	0 <__aeabi_fmul>
    1df8:	994a      	ldr	r1, [sp, #296]	; 0x128
    1dfa:	4603      	mov	r3, r0
    1dfc:	9815      	ldr	r0, [sp, #84]	; 0x54
    1dfe:	9302      	str	r3, [sp, #8]
    1e00:	f7ff fffe 	bl	0 <__aeabi_fmul>
    1e04:	992b      	ldr	r1, [sp, #172]	; 0xac
    1e06:	4683      	mov	fp, r0
    1e08:	f8d4 011c 	ldr.w	r0, [r4, #284]	; 0x11c
    1e0c:	f7ff fffe 	bl	0 <__aeabi_fmul>
    1e10:	4601      	mov	r1, r0
    1e12:	4658      	mov	r0, fp
    1e14:	f7ff fffe 	bl	0 <__aeabi_fadd>
    1e18:	9934      	ldr	r1, [sp, #208]	; 0xd0
    1e1a:	4683      	mov	fp, r0
    1e1c:	4648      	mov	r0, r9
    1e1e:	f7ff fffe 	bl	0 <__aeabi_fmul>
    1e22:	4601      	mov	r1, r0
    1e24:	4658      	mov	r0, fp
    1e26:	f7ff fffe 	bl	0 <__aeabi_fadd>
    1e2a:	9921      	ldr	r1, [sp, #132]	; 0x84
    1e2c:	4683      	mov	fp, r0
    1e2e:	f8d4 0120 	ldr.w	r0, [r4, #288]	; 0x120
    1e32:	f7ff fffe 	bl	0 <__aeabi_fmul>
    1e36:	4601      	mov	r1, r0
    1e38:	4658      	mov	r0, fp
    1e3a:	f7ff fffe 	bl	0 <__aeabi_fadd>
    1e3e:	9935      	ldr	r1, [sp, #212]	; 0xd4
    1e40:	4683      	mov	fp, r0
    1e42:	9816      	ldr	r0, [sp, #88]	; 0x58
    1e44:	f7ff fffe 	bl	0 <__aeabi_fmul>
    1e48:	4601      	mov	r1, r0
    1e4a:	4658      	mov	r0, fp
    1e4c:	f7ff fffe 	bl	0 <__aeabi_fadd>
    1e50:	992d      	ldr	r1, [sp, #180]	; 0xb4
    1e52:	4683      	mov	fp, r0
    1e54:	f8d4 0124 	ldr.w	r0, [r4, #292]	; 0x124
    1e58:	f7ff fffe 	bl	0 <__aeabi_fmul>
    1e5c:	4601      	mov	r1, r0
    1e5e:	4658      	mov	r0, fp
    1e60:	f7ff fffe 	bl	0 <__aeabi_fadd>
    1e64:	993b      	ldr	r1, [sp, #236]	; 0xec
    1e66:	4683      	mov	fp, r0
    1e68:	4650      	mov	r0, sl
    1e6a:	f7ff fffe 	bl	0 <__aeabi_fmul>
    1e6e:	4601      	mov	r1, r0
    1e70:	4658      	mov	r0, fp
    1e72:	f7ff fffe 	bl	0 <__aeabi_fadd>
    1e76:	f8dd c004 	ldr.w	ip, [sp, #4]
    1e7a:	4683      	mov	fp, r0
    1e7c:	9912      	ldr	r1, [sp, #72]	; 0x48
    1e7e:	4660      	mov	r0, ip
    1e80:	f7ff fffe 	bl	0 <__aeabi_fmul>
    1e84:	4601      	mov	r1, r0
    1e86:	4658      	mov	r0, fp
    1e88:	f7ff fffe 	bl	0 <__aeabi_fadd>
    1e8c:	4631      	mov	r1, r6
    1e8e:	f7ff fffe 	bl	0 <__aeabi_fmul>
    1e92:	9a02      	ldr	r2, [sp, #8]
    1e94:	4601      	mov	r1, r0
    1e96:	4610      	mov	r0, r2
    1e98:	f7ff fffe 	bl	0 <__aeabi_fadd>
    1e9c:	9944      	ldr	r1, [sp, #272]	; 0x110
    1e9e:	f7ff fffe 	bl	0 <__aeabi_fadd>
    1ea2:	f8c5 0110 	str.w	r0, [r5, #272]	; 0x110
    1ea6:	9925      	ldr	r1, [sp, #148]	; 0x94
    1ea8:	6148      	str	r0, [r1, #20]
    1eaa:	99e6      	ldr	r1, [sp, #920]	; 0x398
    1eac:	4650      	mov	r0, sl
    1eae:	9129      	str	r1, [sp, #164]	; 0xa4
    1eb0:	f7ff fffe 	bl	0 <__aeabi_fmul>
    1eb4:	9bcc      	ldr	r3, [sp, #816]	; 0x330
    1eb6:	4683      	mov	fp, r0
    1eb8:	98bf      	ldr	r0, [sp, #764]	; 0x2fc
    1eba:	4619      	mov	r1, r3
    1ebc:	9014      	str	r0, [sp, #80]	; 0x50
    1ebe:	4648      	mov	r0, r9
    1ec0:	9311      	str	r3, [sp, #68]	; 0x44
    1ec2:	f7ff fffe 	bl	0 <__aeabi_fmul>
    1ec6:	99d9      	ldr	r1, [sp, #868]	; 0x364
    1ec8:	905e      	str	r0, [sp, #376]	; 0x178
    1eca:	9816      	ldr	r0, [sp, #88]	; 0x58
    1ecc:	9110      	str	r1, [sp, #64]	; 0x40
    1ece:	f7ff fffe 	bl	0 <__aeabi_fmul>
    1ed2:	9ae7      	ldr	r2, [sp, #924]	; 0x39c
    1ed4:	904e      	str	r0, [sp, #312]	; 0x138
    1ed6:	4611      	mov	r1, r2
    1ed8:	4650      	mov	r0, sl
    1eda:	922a      	str	r2, [sp, #168]	; 0xa8
    1edc:	f7ff fffe 	bl	0 <__aeabi_fmul>
    1ee0:	f8dd c300 	ldr.w	ip, [sp, #768]	; 0x300
    1ee4:	99cd      	ldr	r1, [sp, #820]	; 0x334
    1ee6:	905f      	str	r0, [sp, #380]	; 0x17c
    1ee8:	4648      	mov	r0, r9
    1eea:	f8cd c100 	str.w	ip, [sp, #256]	; 0x100
    1eee:	9144      	str	r1, [sp, #272]	; 0x110
    1ef0:	f7ff fffe 	bl	0 <__aeabi_fmul>
    1ef4:	99da      	ldr	r1, [sp, #872]	; 0x368
    1ef6:	9060      	str	r0, [sp, #384]	; 0x180
    1ef8:	9816      	ldr	r0, [sp, #88]	; 0x58
    1efa:	9117      	str	r1, [sp, #92]	; 0x5c
    1efc:	f7ff fffe 	bl	0 <__aeabi_fmul>
    1f00:	9be8      	ldr	r3, [sp, #928]	; 0x3a0
    1f02:	9051      	str	r0, [sp, #324]	; 0x144
    1f04:	4619      	mov	r1, r3
    1f06:	4650      	mov	r0, sl
    1f08:	933a      	str	r3, [sp, #232]	; 0xe8
    1f0a:	f7ff fffe 	bl	0 <__aeabi_fmul>
    1f0e:	9ace      	ldr	r2, [sp, #824]	; 0x338
    1f10:	9061      	str	r0, [sp, #388]	; 0x184
    1f12:	98c1      	ldr	r0, [sp, #772]	; 0x304
    1f14:	4611      	mov	r1, r2
    1f16:	9033      	str	r0, [sp, #204]	; 0xcc
    1f18:	4648      	mov	r0, r9
    1f1a:	9218      	str	r2, [sp, #96]	; 0x60
    1f1c:	f7ff fffe 	bl	0 <__aeabi_fmul>
    1f20:	f8dd c36c 	ldr.w	ip, [sp, #876]	; 0x36c
    1f24:	9062      	str	r0, [sp, #392]	; 0x188
    1f26:	4661      	mov	r1, ip
    1f28:	9816      	ldr	r0, [sp, #88]	; 0x58
    1f2a:	f8cd c068 	str.w	ip, [sp, #104]	; 0x68
    1f2e:	f7ff fffe 	bl	0 <__aeabi_fmul>
    1f32:	992f      	ldr	r1, [sp, #188]	; 0xbc
    1f34:	9016      	str	r0, [sp, #88]	; 0x58
    1f36:	f8d4 015c 	ldr.w	r0, [r4, #348]	; 0x15c
    1f3a:	f7ff fffe 	bl	0 <__aeabi_fmul>
    1f3e:	9914      	ldr	r1, [sp, #80]	; 0x50
    1f40:	4681      	mov	r9, r0
    1f42:	9815      	ldr	r0, [sp, #84]	; 0x54
    1f44:	f7ff fffe 	bl	0 <__aeabi_fmul>
    1f48:	4601      	mov	r1, r0
    1f4a:	4658      	mov	r0, fp
    1f4c:	f7ff fffe 	bl	0 <__aeabi_fadd>
    1f50:	995e      	ldr	r1, [sp, #376]	; 0x178
    1f52:	f7ff fffe 	bl	0 <__aeabi_fadd>
    1f56:	994e      	ldr	r1, [sp, #312]	; 0x138
    1f58:	f7ff fffe 	bl	0 <__aeabi_fadd>
    1f5c:	4601      	mov	r1, r0
    1f5e:	f8d4 0160 	ldr.w	r0, [r4, #352]	; 0x160
    1f62:	f7ff fffe 	bl	0 <__aeabi_fmul>
    1f66:	4601      	mov	r1, r0
    1f68:	4648      	mov	r0, r9
    1f6a:	f7ff fffe 	bl	0 <__aeabi_fadd>
    1f6e:	9940      	ldr	r1, [sp, #256]	; 0x100
    1f70:	4681      	mov	r9, r0
    1f72:	9815      	ldr	r0, [sp, #84]	; 0x54
    1f74:	f7ff fffe 	bl	0 <__aeabi_fmul>
    1f78:	4601      	mov	r1, r0
    1f7a:	985f      	ldr	r0, [sp, #380]	; 0x17c
    1f7c:	f7ff fffe 	bl	0 <__aeabi_fadd>
    1f80:	9960      	ldr	r1, [sp, #384]	; 0x180
    1f82:	f7ff fffe 	bl	0 <__aeabi_fadd>
    1f86:	9951      	ldr	r1, [sp, #324]	; 0x144
    1f88:	f7ff fffe 	bl	0 <__aeabi_fadd>
    1f8c:	4601      	mov	r1, r0
    1f8e:	f8d4 0164 	ldr.w	r0, [r4, #356]	; 0x164
    1f92:	f7ff fffe 	bl	0 <__aeabi_fmul>
    1f96:	4601      	mov	r1, r0
    1f98:	4648      	mov	r0, r9
    1f9a:	f7ff fffe 	bl	0 <__aeabi_fadd>
    1f9e:	9933      	ldr	r1, [sp, #204]	; 0xcc
    1fa0:	4681      	mov	r9, r0
    1fa2:	9815      	ldr	r0, [sp, #84]	; 0x54
    1fa4:	f7ff fffe 	bl	0 <__aeabi_fmul>
    1fa8:	4601      	mov	r1, r0
    1faa:	9861      	ldr	r0, [sp, #388]	; 0x184
    1fac:	f7ff fffe 	bl	0 <__aeabi_fadd>
    1fb0:	9962      	ldr	r1, [sp, #392]	; 0x188
    1fb2:	f7ff fffe 	bl	0 <__aeabi_fadd>
    1fb6:	9916      	ldr	r1, [sp, #88]	; 0x58
    1fb8:	f7ff fffe 	bl	0 <__aeabi_fadd>
    1fbc:	4601      	mov	r1, r0
    1fbe:	f8d4 0168 	ldr.w	r0, [r4, #360]	; 0x168
    1fc2:	f7ff fffe 	bl	0 <__aeabi_fmul>
    1fc6:	4601      	mov	r1, r0
    1fc8:	4648      	mov	r0, r9
    1fca:	f7ff fffe 	bl	0 <__aeabi_fadd>
    1fce:	f8d4 a154 	ldr.w	sl, [r4, #340]	; 0x154
    1fd2:	4681      	mov	r9, r0
    1fd4:	9926      	ldr	r1, [sp, #152]	; 0x98
    1fd6:	4650      	mov	r0, sl
    1fd8:	f7ff fffe 	bl	0 <__aeabi_fmul>
    1fdc:	4601      	mov	r1, r0
    1fde:	4648      	mov	r0, r9
    1fe0:	f7ff fffe 	bl	0 <__aeabi_fadd>
    1fe4:	9938      	ldr	r1, [sp, #224]	; 0xe0
    1fe6:	4681      	mov	r9, r0
    1fe8:	f8d4 0158 	ldr.w	r0, [r4, #344]	; 0x158
    1fec:	f7ff fffe 	bl	0 <__aeabi_fmul>
    1ff0:	4601      	mov	r1, r0
    1ff2:	4648      	mov	r0, r9
    1ff4:	f7ff fffe 	bl	0 <__aeabi_fadd>
    1ff8:	9913      	ldr	r1, [sp, #76]	; 0x4c
    1ffa:	f7ff fffe 	bl	0 <__aeabi_fmul>
    1ffe:	9921      	ldr	r1, [sp, #132]	; 0x84
    2000:	4681      	mov	r9, r0
    2002:	4650      	mov	r0, sl
    2004:	f7ff fffe 	bl	0 <__aeabi_fmul>
    2008:	4601      	mov	r1, r0
    200a:	985a      	ldr	r0, [sp, #360]	; 0x168
    200c:	f7ff fffe 	bl	0 <__aeabi_fadd>
    2010:	992c      	ldr	r1, [sp, #176]	; 0xb0
    2012:	f7ff fffe 	bl	0 <__aeabi_fadd>
    2016:	992d      	ldr	r1, [sp, #180]	; 0xb4
    2018:	4682      	mov	sl, r0
    201a:	f8d4 0158 	ldr.w	r0, [r4, #344]	; 0x158
    201e:	f7ff fffe 	bl	0 <__aeabi_fmul>
    2022:	4601      	mov	r1, r0
    2024:	4650      	mov	r0, sl
    2026:	f7ff fffe 	bl	0 <__aeabi_fadd>
    202a:	9939      	ldr	r1, [sp, #228]	; 0xe4
    202c:	f7ff fffe 	bl	0 <__aeabi_fadd>
    2030:	9912      	ldr	r1, [sp, #72]	; 0x48
    2032:	4682      	mov	sl, r0
    2034:	f8d4 015c 	ldr.w	r0, [r4, #348]	; 0x15c
    2038:	f7ff fffe 	bl	0 <__aeabi_fmul>
    203c:	4601      	mov	r1, r0
    203e:	4650      	mov	r0, sl
    2040:	f7ff fffe 	bl	0 <__aeabi_fadd>
    2044:	9927      	ldr	r1, [sp, #156]	; 0x9c
    2046:	4682      	mov	sl, r0
    2048:	f8d4 0160 	ldr.w	r0, [r4, #352]	; 0x160
    204c:	f7ff fffe 	bl	0 <__aeabi_fmul>
    2050:	4601      	mov	r1, r0
    2052:	4650      	mov	r0, sl
    2054:	f7ff fffe 	bl	0 <__aeabi_fadd>
    2058:	991b      	ldr	r1, [sp, #108]	; 0x6c
    205a:	4682      	mov	sl, r0
    205c:	f8d4 0164 	ldr.w	r0, [r4, #356]	; 0x164
    2060:	f7ff fffe 	bl	0 <__aeabi_fmul>
    2064:	4601      	mov	r1, r0
    2066:	4650      	mov	r0, sl
    2068:	f7ff fffe 	bl	0 <__aeabi_fadd>
    206c:	9928      	ldr	r1, [sp, #160]	; 0xa0
    206e:	4682      	mov	sl, r0
    2070:	f8d4 0168 	ldr.w	r0, [r4, #360]	; 0x168
    2074:	f7ff fffe 	bl	0 <__aeabi_fmul>
    2078:	4601      	mov	r1, r0
    207a:	4650      	mov	r0, sl
    207c:	f7ff fffe 	bl	0 <__aeabi_fadd>
    2080:	4631      	mov	r1, r6
    2082:	f7ff fffe 	bl	0 <__aeabi_fmul>
    2086:	4601      	mov	r1, r0
    2088:	4648      	mov	r0, r9
    208a:	f7ff fffe 	bl	0 <__aeabi_fadd>
    208e:	992b      	ldr	r1, [sp, #172]	; 0xac
    2090:	f7ff fffe 	bl	0 <__aeabi_fadd>
    2094:	f8c5 0144 	str.w	r0, [r5, #324]	; 0x144
    2098:	9925      	ldr	r1, [sp, #148]	; 0x94
    209a:	6188      	str	r0, [r1, #24]
    209c:	f8d8 9018 	ldr.w	r9, [r8, #24]
    20a0:	9922      	ldr	r1, [sp, #136]	; 0x88
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
