Laurenceb/Dactyl/(commit log)

2011-05-23 Long ways to go yet. Sméagol will show you the way.
    [flash-bin.cfg, flash-elf.cfg]
2011-05-26 Reduced printf functionality
2011-05-26 Hardware, rtc, and sd interface added
    [$savepcb.brd, 4431-T-B1_D_434_BOM.xls, BOM.xls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]
2011-05-29 Assembly photos
2011-05-30 FSA03 and IMU working
2011-06-04 IMU code first draft
2011-06-05 Baro sensor altitude compensation
2011-06-14 NVIC correctly set & Bugfixes
    [cal.h, interrupts.c, main.c]
2011-06-14 Fixed typos, all magno to mG
    [cal.h, main.c]
2011-06-18 EKF running correctly (at reduced 100Hz rate)
    [gpio.c, i2c.h, imu.c, main.c, sensorcal.c]
2011-06-20 EKF running at 125Hz, makefile allows seperate -O for ekf
2011-06-21 Baro working, magno tested running at 120hz
2011-06-23 I2C cleanup, pitot fixes
    [gpio.h, i2c.c, i2c.h, imu.c]
2011-06-24 Baro ekf correction in progress
    [ekf.c, imu.c, main.c]
2011-06-26 Baro working correctly, more work on altitude filtering possible
    [ekf.c, imu.c, main.c]
2011-06-26 Pitot driver bugfix
2011-07-05 Servo PWM support
2011-07-05 Servo PWM support finished
2011-07-09 PID cleanup, Baro altitude tracking improved
2011-07-10 Added Test data, pitot fix
    [cal.h, main.c]
2011-07-12 EKF uses reported GPS error
    [ekf.c, imu.c, insgps.h, ubx.h]
2011-07-14 GPS ubx packet parser bugfixes
    [cal.h, i2c.h, ubx.h]
2011-07-16 Added MAVlink for ground station support
2011-07-18 FatFS DMA fully blocking
2011-07-20 DMA cleanup, added DMA for USART1 debug
2011-07-21 Added quaternion to roll pitch yaw conversion
2011-07-22 DMA tidyup
2011-07-25 UAVtalk DMA cleanup
2011-07-26 DMA<=>Usart1 interface added to main loop
2011-08-01 Added watchdog timer
2011-08-09 added baro and velocity uav objects, with board temperature telemetery
2011-09-15 Started working on NVIC based I2C
2011-09-15 I2C interrupt driven cleanup
2011-09-16 I2C interrupt in progress
2011-09-17 I2C interrupt - in progress (slowly)
2011-09-20 I2C interrupt - in progress (more scripted version)
2011-09-21 I2C scripted
2011-09-22 I2C reoroganisation
2011-09-22 I2C fixes
2011-09-23 I2C improvements
2011-09-23 I2C added device scripts
2011-09-24 Added IMU software interrupt, accel downsampling
2011-09-24 Added interrupt handling and nesting
2011-09-27 I2C rewrite (again)
2011-09-27 I2C interrupt driven
2011-09-27 I2C driver finished (kind of) XD
2011-09-27 I2C driver - added task on completion
2011-09-28 Added interrupt driven sensor support
2011-09-28 Interrupt config fix
2011-09-28 Added completed I2C tasks flags
2011-09-29 IMU debloating
2011-09-29 imu.c simplified
2011-09-30 Interrupt driven rewrite - almost complete
2011-10-03 DMA for USART1 tx, ISR for Rx
2011-10-05 SPI->uSD speed fixed
2011-10-06 Started adding c++ RF22 library
    [project.cfg]
2011-10-11 SPI hardware interface, uSD card software detection
2011-10-11 Fixed Si4432 GPIO -> RX/TX switch
    [RF22.cpp, RF22.h]
2011-10-16 Added Si4432 polling at 125Hz
2011-10-18 FatFS cluster pre-allocation to avoid wait state delays
    [main.c, main.h]
2011-10-20 Added filesystem error flag guards
    [main.c]
2011-10-21 Fixed i2c config
2011-10-21 I2C fixed three byte read
    [i2c_int.c]
2011-10-22 Fixed warnings - spi initi
    [RF22.cpp, i2c_int.c, i2c_int.h, main.c]
2011-10-23 I2C bugfixes on single byte write
    [i2c_int.c, main.c]
2011-10-25 I2C running
2011-10-26 I2C debug
2011-10-27 I2C init
2011-10-27 I2C working
2011-10-27 I2C pitot fixes
2011-10-28 Pitot fixed address conflict (hackish)
    [i2c_int.h, imu.c, interrupts.c]
2011-10-30 Baro initialisation fix, removed erranous code in RF22::init
    [RF22.cpp, main.c]
2011-10-31 USART1 DMA fix
2011-11-01 SPI cleanup
2011-11-02 extern C linkage fixed
    [RF22.h, gpio.c, interrupts.c]
2011-11-02 brackets etc
2011-11-03 SPI sharing control
2011-11-09 Fixed baro pressure averaging
    [main.c]
2011-11-13 USART DMA fixed
2011-11-13 BMP sea level pressure cal fix
    [main.c]
2011-11-24 Fixed FatFS to actually use DMA
2011-11-28 UAVtalk - fix DMA and buffers
    [main.c, usart.c]
2011-12-07 Added ADC driver for Battery voltage monitoring
2011-12-15 PWM fixed timer1 init, added battery state and manual overwride
    [adc.h, imu.c, imu.h, main.c, pwm.c]
2011-12-15 Corrected Kinetic energy mix
    [imu.c]
2011-12-26 Comments and DMA cleanup
2011-12-28 Added ADC config and STM32 Type ID
2011-12-30 UAVtalk independent timers on each port
2012-01-03 Fixed accel filter, GPS update setting
    [accel_down.c, main.c]
2012-01-07 Fix bmp->kalman endianess issue
    [imu.c]
2012-01-12 Fixed Battery stats and Baro temperature
    [imu.c]
2012-01-15 Position and Velocity object units, fixed pointer errors in kalman
    [accel_down.c, cal.h, dma.c, imu.c, imu.h, main.c]
2012-01-16 issue with magno :/
    [i2c_int.c, i2c_int.h, imu.c, imu.h, main.c, sensorcal.c]
2012-01-19 Rewritten I2C method2 to fix bugs
    [main.c]
2012-01-20 Fix error in i2c
    [i2c_int.c]
2012-01-20 Fixed endianess and correction
    [i2c_int.c, i2c_int.h, imu.c, imu.h, main.c, sensorcal.c]
2012-01-21 made I2C job request interruptable by I2C EVT
2012-01-21 Fixed maths functions to single precision (in some cases)
    [ekf.c, pitot.c]
2012-01-27 Fixed baro filtering to avoid atmospheric models
    [bmp085.c, bmp085.h, imu.c, imu.h, main.c, pitot.c]
2012-01-27 Fixed errors in baro tracking
    [imu.c]
2012-01-27 Fixed Baro UAVObject units
    [imu.c]
2012-01-29 Changes to I2C driver, added indoor and debug operating modes
2012-02-02 Fixed typecast issue, fixed Si4432 xtal load capacitance
    [RF22.h, ekf.c, imu.c, main.c, main.h]
2012-02-06 Fixed bmp085 temperature - added oversampling
    [bmp085.c, bmp085.h, i2c_int.asm, i2c_int.c, i2c_int.h]
2012-02-07 BMP085 temperature averaging working
2012-02-07 fixed i2c 2 byte read
    [i2c_int.c]
2012-02-11 Fixed I2C two byte read issues
    [i2c_int.c, main.c]
2012-02-18 Fixed gyor scale factor
    [cal.h]
2012-02-19 Fixed Baro, corrected itg-3200 to match datasheet
    [cal.h, imu.c, main.c]
2012-03-11 Corrected target heading calculation
    [imu.c]
2012-03-19 Made PWM setting more sane
2012-03-25 Fixed pwm output settings
    [pwm.c]
2012-04-01 Datatypes in pwm
2012-04-08 Fixed multiple waypoint switching
    [main.c]
2012-04-29 Changed ADC sample time to improve SNR
2012-05-13 Added reset cause detect
    [main.c]
2012-06-03 Fixed I2C issues
